alphasafal/saaya-verify/docs/report/SAAYA_Cool_Shelter_Project_Report_VIT.pdf

## SAAYA: AN IoT-ENABLED COOL SHELTER FOR OUTDOOR WORKERS

A PROJECT REPORT

Submitted to the School of Computer Science and Engineering

by

SAFAL GUPTA
23BCT0237

SCHOOL OF COMPUTER SCIENCE AND ENGINEERING VELLORE INSTITUTE OF TECHNOLOGY VELLORE – 632 014, TAMIL NADU, INDIA

OCTOBER 2026

### DECLARATION

I hereby declare that the project report entitled “SAAYA: An IoT-Enabled Cool Shelter for Outdoor Workers”, submitted by me to the School of Computer Science and Engineering, Vellore Institute of Technology, Vellore, is a record of original work carried out by me. I further declare that the work reported in this project has not been submitted, either in part or in full, for the award of any other degree or diploma in this institute or any other institute or university.

Place: Vellore
Date:

Signature of the Candidate Safal Gupta
23BCT0237

ii

### CERTIFICATE

This is to certify that the project report entitled “SAAYA: An IoT-Enabled Cool Shelter for Outdoor Workers”, submitted by Safal Gupta (23BCT0237), School of Computer Science and Engineering, Vellore Institute of Technology, Vellore, is a record of bona fide work carried out by the student during the period July 2026 to October 2026. The contents of this report have not been submitted elsewhere for the award of any degree or diploma.

Signature of the Head of Department [Head of Department]
School of Computer Science and Engineering
Internal Examiner | External Examiner

iii

### ACKNOWLEDGEMENT

I thank the Head of the Department and the faculty of the School of Computer Science and Engineering, Vellore Institute of Technology, for the facilities and the encouragement to work on a problem outside the usual software projects. I also thank the management of VIT for providing an environment in which an idea like this can be tried.

The design depends on published research and on openly available datasheets and tools. I acknowledge the authors of the heat and fan-use studies cited in this report, and the developers of CadQuery, PlatformIO, the ESP32 Arduino core and the Wokwi simulator.

Finally, I thank my family and friends for their support, and the workers whose working conditions in the Vellore summer were the reason for starting this project.

Safal Gupta

iv

### ABSTRACT

Workers on Indian construction sites and farms take their rest breaks under whatever shade is available, usually a bare metal sheet that becomes hot in the afternoon sun. Nobody measures whether these shades help, fans fitted to them fail without anyone noticing, and a worker who feels unwell has no reliable way to call for help. This project presents the SAAYA cool shelter, a demountable rest shelter for four to six workers. Its 2.4 m × 2.0 m steel frame carries a reflective upper roof skin, a ventilated gap of about 120 mm and a painted lower lining, with a 200 mm overhang, a louvred side screen and a bench. An IoT system called SAAYA Node, built around an ESP32 microcontroller, reads two Sensirion SHT30 temperature and humidity sensors (at seat height and outside the shelter as a reference), a DS18B20 probe on the roof lining, a float switch in the water can, the tachometer of a 120 mm PWM fan and an INA219 power monitor. Workers use three weatherproof buttons and an OLED display; a help request is latched in flash memory and can be cleared only by staff. Guided by medical studies showing that fans can add heat in very hot air, the controller stops automatic fan operation at 39 °C while leaving manual control to the worker. A screening heat model predicts that the cool roof keeps its lining about 26 °C cooler than a weathered metal sheet, and showed that shade, overhang and the ground around the shelter matter more than any single roof detail. The report documents the selection of materials and components, technical specifications, the interfacing circuit, dimensioned CadQuery 3D models of the shelter and the 175 × 100 × 60 mm IP65 electronics enclosure, and a deployment plan for a worksite in Vellore. The electronics cost about ₹5,314. The firmware compiles and its control logic passes automated tests; fabrication and field testing are the next stage.

Keywords: cool shelter, Internet of Things, ESP32, heat stress, outdoor workers, cool roof, PWM fan control, Vellore.

v

### TABLE OF CONTENTS

Title | Page No.
Declaration | ii
Certificate | iii
Acknowledgement | iv
Abstract | v
List of Figures | ix
List of Tables | x
List of Abbreviations | xi
1 INTRODUCTION | 1
1.1 Background | 1
1.2 Problem statement | 1
1.3 Objectives | 2
1.4 Scope and limitations | 2
1.5 Organisation of the report | 2
2 LITERATURE SURVEY | 3
2.1 Heat exposure in a shaded rest area | 3
2.2 Cool roofs in India | 3
2.3 Lessons from traditional Indian buildings | 3
2.4 When does a fan help? | 4
2.5 Measuring radiant heat cheaply | 4
2.6 Research gap | 4
3 PROPOSED COOL SHELTER AND REAL-LIFE SCENARIO | 5
3.1 The practical problem | 5
3.2 Overview of the cool shelter | 5
3.3 Intended users | 6
3.4 How the shelter keeps people cool | 6
3.5 How the smart system operates | 6
3.6 Design reasoning from a heat model | 7
3.7 Expected benefits | 8
3.8 Why the design suits this application | 8
4 COMPONENT SELECTION AND JUSTIFICATION | 9
4.1 Selection criteria | 9
4.2 Shelter structure and passive cooling elements | 9

vi

4.3 Electronic components | 10
4.4 Discussion of key choices | 11
5 TECHNICAL SPECIFICATIONS | 13
5.1 Shelter specification | 13
5.2 Electronic component specifications | 13
5.3 Power budget | 14
6 INTERFACING DESIGN | 16
6.1 Circuit overview | 16
6.2 Pin assignment | 18
6.3 Design rules taken from the datasheets | 18
7 3D MODEL DESIGN | 20
7.1 Modelling approach | 20
7.2 Shelter structure | 20
7.3 Placement of devices in the shelter | 22
7.4 Electronics enclosure | 22
8 DEPLOYMENT CAPABILITY | 26
8.1 Installation area and orientation | 26
8.2 Foundation and erection | 26
8.3 Mounting the smart system | 26
8.4 Power availability | 28
8.5 Connectivity | 28
8.6 Environmental conditions | 28
8.7 Maintenance | 28
8.8 Retrofit option | 29
9 IMPLEMENTATION AND TESTING | 30
9.1 Firmware structure | 30
9.2 Operating states | 30
9.3 Verification carried out | 31
9.4 Hardware simulation | 31
9.5 Cost summary | 33
9.6 Limitations | 33
10 CONCLUSION AND FUTURE WORK | 34
10.1 Conclusion | 34
10.2 Future work | 34
REFERENCES | 35
APPENDIX A: BILL OF MATERIALS | 37

vii

APPENDIX B: SHELTER COST ESTIMATE | 39

viii

QQLOFQQ

### LIST OF FIGURES

Fig. 3.1 The SAAYA cool shelter: steel frame, ventilated double roof, louvred side screen, bench, SAAYA Node enclosure on the rear post, seat sensor stand and water can

6

Fig. 3.2 Predicted mean radiant temperature at a seated worker’s head for different roof options (screening model, clear 38 °C noon in mid-May, Vellore)

7

Fig. 6.1 Interfacing diagram of the SAAYA Node electronics showing all pins, bus addresses, pull-up resistors, driver stages and supply rails

17

Fig. 7.1 Shelter frame with the roof skins removed, showing posts, crossbeams, knee gussets, purlins, louvred screen, bench, electronics enclosure and sensor stands

20

Fig. 7.2 General arrangement of the cool shelter: plan with post grid, roof outline and bench, and front elevation with frame, double roof and clear height

21

Fig. 7.3 Electronics enclosure with the lid removed: ESP32 board and terminals (left), INA219, buck converter and fuse (right), vent and side ACK button

23

Fig. 7.4 Enclosure front panel | 23
Fig. 7.5 Underside with five PG7 glands | 23
Fig. 7.6 Dimensioned drilling and mounting drawing of the electronics
enclosure, back bracket and internal layout | 25

Fig. 8.1 Side elevation of the shelter showing mounting heights and sensor

positions | 27

Fig. 9.1 Hardware simulator on the project website: field build, seat air 34.2 °C,

fan running at 50 percent with tachometer feedback and the INA219 reading 1.45 W | 32

ix

QQLOTQQ

### LIST OF TABLES

Table 4.1 Selection of the shelter structure and passive cooling elements | 9
Table 4.2 Selection of the electronic components | 10
Table 5.1 Specification of the cool shelter structure | 13
Table 5.2 Technical specifications of the electronic components | 13
Table 5.3 Power budget per supply rail | 15
Table 6.1 ESP32 pin assignment | 18
Table 7.1 Positions of the smart-system devices in the shelter model (datum:
front-left post centre at floor level, mm) | 22

Table 7.2 Principal dimensions of the electronics enclosure (mm, datum at front-

left-bottom corner) | 23
Table 8.1 Maintenance schedule | 28
Table 9.1 Response of the system to each operating state | 30
Table 9.2 Behaviour checked automatically in the hardware simulator | 32
Table A.1 Bill of materials and cost | 37
Table B.1 First-article cost estimate of the cool shelter (₹) | 39

x

QQLOAQQ

### LIST OF ABBREVIATIONS

ABS | Acrylonitrile butadiene styrene
ACK | Acknowledge
API | Application programming interface
CAD | Computer-aided design
CFM | Cubic feet per minute
GPIO | General-purpose input/output
I²C | Inter-Integrated Circuit bus
IMD | India Meteorological Department
IoT | Internet of Things
IP65 | Ingress protection: dust-tight, protected against water jets
LDO | Low-dropout regulator
MRT | Mean radiant temperature
RHS / SHS | Rectangular / square hollow section (steel tube)
NDMA | National Disaster Management Authority
OLED | Organic light-emitting diode
PWM | Pulse-width modulation
RH | Relative humidity
STEP | Standard for the Exchange of Product model data
STP | Shielded twisted pair
WHO | World Health Organization

xi

QQC1QQ

### CHAPTER 1

### INTRODUCTION

QQS1_1QQ1.1 Background

Outdoor work in India does not stop for the summer. Masons, road crews, farm labourers and delivery riders keep working through April and May, when the afternoon air in Vellore regularly sits close to 39 °C and has touched 45 °C [1]. The International Labour Organization estimates that heat stress could cost India about 5.8 percent of its working hours by 2030, roughly 34 million full-time jobs [2]. The 2025 Lancet Countdown put the potential labour lost to heat in India in 2024 at 247 billion hours [3].

For most of these workers the only relief during a break is whatever shade happens to be on site: a sheet of galvanised iron on four poles, a cement-sheet lean-to, or the shadow of a parked truck. In 2025 the National Disaster Management Authority published draft guidelines asking for proper shaded rest structures for outdoor workers, with reflective roofs instead of bare metal sheets, cross-ventilation and shaded, unpaved ground around them [4]. This project takes those guidelines as a starting point and asks what a cool shelter for a worksite should look like, and how it can show that it is actually working.

QQS1_2QQ1.2 Problem statement

Three problems were identified with the rest shades found on typical worksites. The roof itself is often the worst part: a bare or weathered metal sheet absorbs sunlight and its underside becomes a radiant heater above the people sitting below it. There is no feedback of any kind, so if a fan has been fitted, nobody notices when it stalls or loses its supply. And a worker who starts to feel unwell has no dependable way to call for help other than shouting or walking to find a supervisor.

The problem addressed here is to design a low-cost cool shelter for outdoor workers that reduces radiant heat by passive means, moves air only when that is useful, measures the conditions it actually produces, refuses to report a benefit it cannot demonstrate, and gives workers a help request that cannot be lost.

QQS1_3QQ1.3 Objectives

1. To design a demountable cool shelter of about 2.4 m × 2.0 m for four to six seated workers, with a reflective ventilated double roof, a deep overhang, a side screen and a bench.
2. To select sensors, a controller and an actuator that measure seat-level air, an outdoor reference, roof temperature, water availability, fan speed and fan energy, at around ₹5,000 for the electronics.
3. To design the interfacing circuit for an ESP32 microcontroller, with every pin, bus address and supply rail documented.
4. To develop dimensioned 3D models of the shelter and of the weatherproof electronics enclosure, with sensor positions, from parts and sections available in India.
5. To write firmware that keeps working without a network, detects sensor and fan faults, latches help requests and avoids running the fan in conditions where it may add heat.
6. To plan the installation, power, connectivity and maintenance of the shelter on a worksite in Vellore.

QQS1_4QQ1.4 Scope and limitations

The report covers the design of the shelter structure, its passive cooling features, the electronic system (called SAAYA Node), the firmware, the 3D models and the deployment plan. The firmware compiles and its control logic has been tested in software, and both 3D models have been checked for clashes between parts. The shelter has not been fabricated and nothing has been measured outdoors, so no measured cooling benefit or health effect is claimed. The structural sections are candidates that still need approval by a qualified structural engineer, and the shelter cost is a planning estimate, not a quotation.

QQS1_5QQ1.5 Organisation of the report

Chapter 2 reviews the literature behind the design. Chapter 3 describes the proposed cool shelter, the real-life scenario and how it operates. Chapters 4 and 5 justify the choice of materials and components and list their specifications. Chapter 6 presents the interfacing diagram. Chapter 7 describes the 3D models of the shelter and the electronics enclosure. Chapter 8 explains deployment, Chapter 9 the implementation and testing, and Chapter 10 concludes the report.

QQC2QQ

### CHAPTER 2

### LITERATURE SURVEY

QQS2_1QQ2.1 Heat exposure in a shaded rest area

The heat a resting person feels outdoors depends on air temperature, humidity and air speed, and also on radiation from the sun, the sky, the ground and any roof overhead. This radiant part is usually expressed as the mean radiant temperature (MRT). Measurements during a record heatwave in Tempe, Arizona, found that tree shade lowered afternoon MRT by up to 33 °C while air temperature across the same sites varied by less than 4.5 °C [5]. For a shelter the message is clear: blocking radiation matters far more than trying to cool the air, which an open structure cannot hold anyway.

QQS2_2QQ2.2 Cool roofs in India

Indian pilots show that roof treatment makes a measurable difference. In an Ahmedabad trial by the Mahila Housing Trust, a white solar-reflective coating on a tin roof lowered the daytime indoor temperature by about 1 °C, and modular roofs and false ceilings did somewhat better [6]. These were closed rooms rather than open shelters, but they confirm that the finish and the underside temperature of a roof are worth designing for and worth measuring.

QQS2_3QQ2.3 Lessons from traditional Indian buildings

Traditional buildings in hot parts of India handle heat with a few simple ideas: deep verandahs and chajjas that keep the sun off walls and people, jaali screens that cut low-angle sun while letting air through, and roofs with an air space that carries heat away before it reaches the room. The shelter borrows these ideas in a light, demountable form: a 200 mm roof overhang on every side, a removable louvred screen on the sun-facing side and a two-layer roof with a ventilated gap. Heavy thermal mass and evaporative cooling were deliberately left out, because a warm night stops thermal mass from recovering and evaporative systems need water and cleaning and lose their effect in humid monsoon weather.

QQS2_4QQ2.4 When does a fan help?

A fan cools by speeding up the evaporation of sweat, but when the air is hotter than the skin it also blows heat onto the body. Ravanelli et al. found that at 42 °C a fan still helped young men, but only up to a limited humidity [7]. Gagnon et al. repeated a similar test with adults around 68 years old and found no benefit, with heart rate and core temperature slightly higher with the fan on [8]. A clinical trial by Morris et al. found fans helping in hot, humid conditions and making things worse in very hot, dry conditions [9]. A later model by the same group proposed upper air-temperature limits for fan use of 39 °C for young healthy adults, 38 °C for people over 65 and 37 °C for older people on anticholinergic medication, and advised against relying on fans alone in northern India [10]. The WHO recommends using fans only below 40 °C [11].

This research is the reason the shelter’s controller does not behave like a thermostat. Above about 39 °C it stops running the fan automatically and tells the worker why, while leaving manual control in their hands.

QQS2_5QQ2.5 Measuring radiant heat cheaply

MRT is normally estimated from a black globe thermometer together with air temperature and air speed. Teitelbaum et al. showed that the standard correction becomes inaccurate below about 1 m/s [12], which is typical under a shelter. The design therefore measures what can be measured reliably and cheaply (air temperature and humidity at the seat and outside, and the temperature of the roof underside) and keeps globe measurements as a separate validation step.

QQS2_6QQ2.6 Research gap

Shade structures and cool roofs are well understood, and fans are known to help only within limits. What is missing at worksite level is a cheap shelter that combines passive cooling with measurement, controls its fan within safe limits and is honest about what it does not know. The SAAYA cool shelter is an attempt to fill that gap.

QQC3QQ

### CHAPTER 3

### PROPOSED COOL SHELTER AND REAL-LIFE SCENARIO

QQS3_1QQ3.1 The practical problem

Consider a building site on the outskirts of Vellore in May. Around fifteen workers take their afternoon break under a galvanised sheet on four poles. The sheet is old and grey, and by 1 p.m. its underside is hotter than the air. A pedestal fan was once tied to a pole but stopped working weeks ago and nobody noticed. When one of the workers feels dizzy, the others have to find the supervisor on foot.

QQS3_2QQ3.2 Overview of the cool shelter

The SAAYA cool shelter is a four-post steel frame with post centres of 2400 × 2000 mm and a roof that projects 2800 × 2400 mm, giving a 200 mm overhang on every side. The roof is made of two skins: a white, reflective upper sheet that sends most of the sunlight back to the sky, and a lower lining about 120 mm below it. The gap between them is open at the edges so that wind and rising warm air carry away the heat absorbed by the upper sheet before it reaches the lining. The roof falls 120 mm towards the front for drainage. A 1400 × 450 mm bench sits at the rear, a removable louvred screen shades the sun-facing side, and the front stays open for access. Clear height under the front of the roof is 2310 mm (Fig. 3.1).

The smart part of the shelter, called SAAYA Node, is a weatherproof electronics box fixed to a rear post. It reads the conditions under and outside the shelter, drives a small fan, shows the status on a display and handles help requests.

QQF3.1QQ

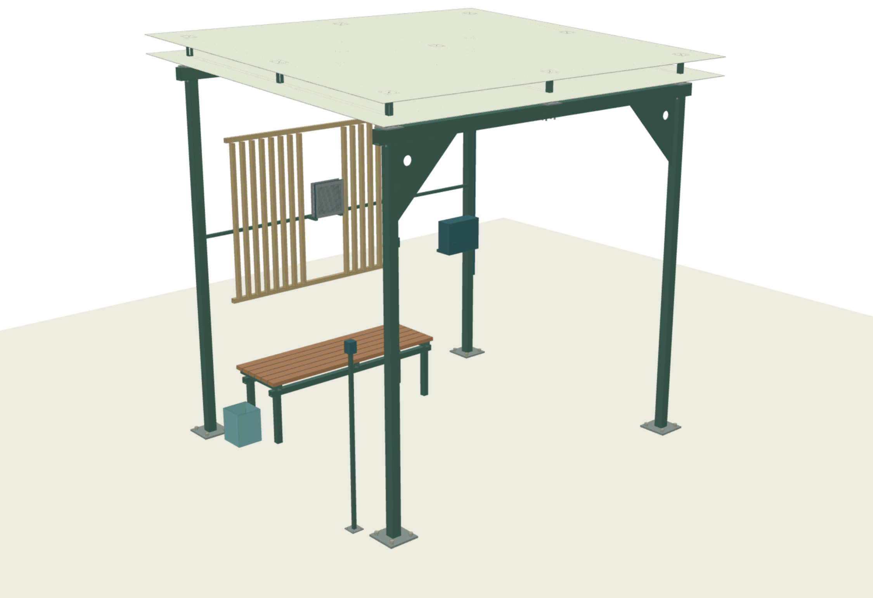
[picture p1: figure]

Fig. 3.1: The SAAYA cool shelter: steel frame, ventilated double roof, louvred side screen, bench, SAAYA Node enclosure on the rear post, seat sensor stand and water can

QQS3_3QQ3.3 Intended users

Workers use the shelter during breaks: they read the display, press MODE to switch the fan and press HELP if someone needs assistance. The site supervisor or safety officer receives help requests and acknowledges them with a separate button. The site engineer looks at the logged data to decide whether, for example, repainting the roof or planting the surrounding ground has made a difference.

QQS3_4QQ3.4 How the shelter keeps people cool

Most of the cooling is passive. The roof blocks direct sun from the seated area; the reflective upper skin keeps the roof itself from becoming a heater; the ventilated gap and the lining keep the surface that people see close to air temperature; the overhang widens the shadow; and the louvred screen cuts low-angle sun from the side while letting air through. The fan is a small addition that increases air movement over seated workers when the air is warm but not yet hot enough for a fan to become counter-productive.

QQS3_5QQ3.5 How the smart system operates

Once a second, the ESP32 inside SAAYA Node reads the air temperature and humidity at seat height, a matching reference sensor placed outside the shelter, the temperature of the roof underside, a float switch in the drinking-water can, the actual speed of the fan from its tachometer signal and the electrical power drawn by the fan.

When a worker presses MODE, the fan runs at 70 percent. In automatic mode it starts at 32 °C and stops below 31 °C, so it does not switch on and off around a single threshold. If the seat-level air reaches 39 °C, automatic operation stops and the display reads “HOT: FAN MAY ADD HEAT”, although the worker can still switch the fan on manually. If the fan is commanded but its tachometer shows no rotation after three seconds, the display shows a fan fault and no cooling is reported for that period.

Pressing HELP latches a request: the red LED lights, the buzzer sounds and the display shows the request. The latch is kept in flash memory, so it survives a power cut or a reset, and it can only be cleared with the ACK button, which sits on the side of the box so that it is pressed deliberately by staff. Readings go to a laptop over USB, or optionally over the site Wi-Fi to the supervisor.

QQS3_6QQ3.6 Design reasoning from a heat model

Before fixing the roof design, a small steady-state model was written to see which features actually reduce the heat felt by a seated worker [13, 14]. It balances sunlight, sky and ground radiation and wind on each roof skin and computes the MRT at the head of a seated worker from the exact solid angle of the roof, sky and ground. For a clear 38 °C noon in mid-May in Vellore it predicts that moving from open sun into the shade of a weathered metal shed lowers MRT by about 16 °C, and that the SAAYA cool roof lowers it by a further 2.6 °C (Fig. 3.2). The bigger difference is in the roof underside, which the model expects to run about 26 °C cooler than the weathered sheet, so the surface just above people’s heads stays close to air temperature.

QQF3.2QQ

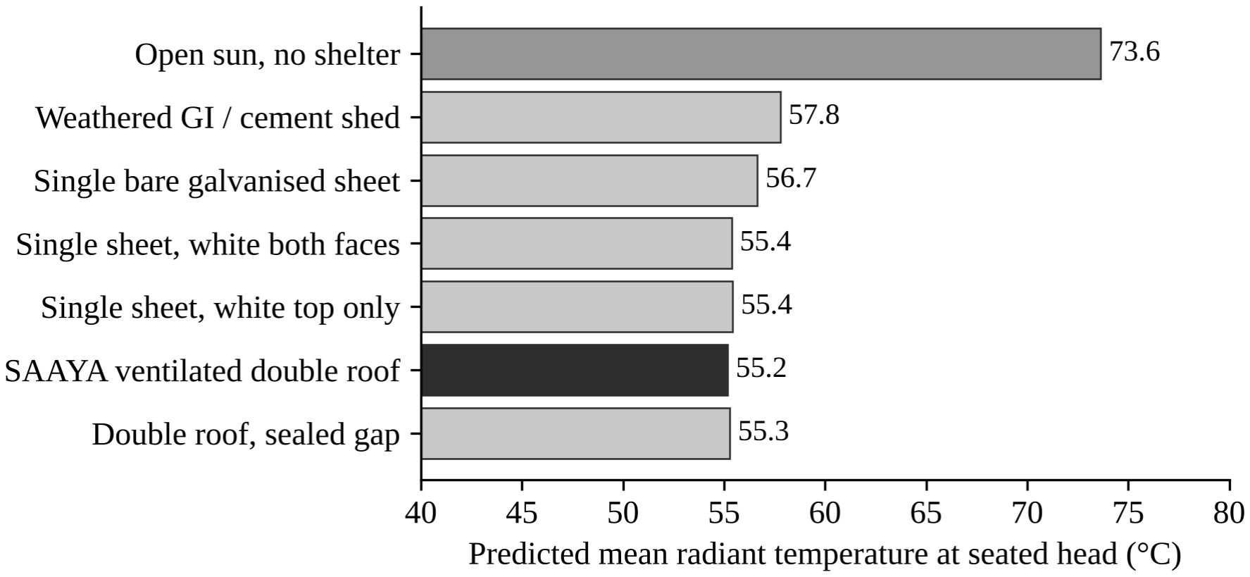
[picture p2: figure]

Fig. 3.2: Predicted mean radiant temperature at a seated worker’s head for different roof options (screening model, clear 38 °C noon in mid-May, Vellore)

The model also showed what else is worth spending on. Adding 0.3 m of overhang on every side lowers the seated MRT by about 1.4 °C, and replacing dry bare ground around the shelter with irrigated ground cover lowers it by about 4 °C, because a seated person sees far more ground and sky than roof. Light-coloured paving does the opposite: it reflects sunlight back up and raises MRT by about 5 °C. The upper skin of the double roof cuts the lining temperature by 8 to 22 °C, and its value grows as the white top coat gets dirty. These results set the priorities in the design: shade and overhang first, then the cool roof, then the ground around the shelter.

QQS3_7QQ3.7 Expected benefits

A rest place where direct sun and the hot-roof effect are removed, with the roof underside kept near air temperature.
A help request that cannot be lost or silently cleared, and that still works when the network or the laptop is down.
Immediate notice of a stalled fan, a disconnected sensor or an empty water can. Paired readings from the seat and from outside the shelter, so the site can see whether the shelter, or a later improvement, actually helped.
Very low energy use: about 34 Wh a day for the electronics and fan, compared with 11 to 13 kWh in one shift for a 1.5-ton air conditioner.

QQS3_8QQ3.8 Why the design suits this application

An open shelter cannot keep air-conditioned air in, so cooling the air is not a realistic goal. What can be done is to block radiation, move air sensibly and keep watch. The frame is bolted from repeated steel sections so it can be moved when the site moves; the electronics run entirely on the microcontroller so they do not depend on the internet; and the same electronics can be fitted to an existing shed when a new shelter is not affordable.

QQC4QQ

### CHAPTER 4

### COMPONENT SELECTION AND JUSTIFICATION

QQS4_1QQ4.1 Selection criteria

Every material and component was judged against the same criteria: whether it contributes to cooling or to measurement rather than only appearance; cost; accuracy adequate for a 1 °C decision margin; power consumption; an operating range covering shaded outdoor air between 25 °C and 45 °C and monsoon rain; compatibility with the rest of the system (3.3 V logic and the I²C bus for the electronics, bolted connections for the structure); and availability from Indian suppliers.

QQS4_2QQ4.2 Shelter structure and passive cooling elements

QQT4.1QQ
Table 4.1: Selection of the shelter structure and passive cooling elements
Element | Selected | Reasons for selection | Alternatives considered
Frame | Steel SHS 60×60×3 posts, RHS 80×60×3 beams, RHS 60×40×3 purlins | Standard sections stocked across India; bolted plate connections make the shelter demountable; galvanised or painted for corrosion | Bamboo (variable strength, termites, hard to bolt), timber (rot, fire), aluminium extrusions (higher cost, harder to weld locally)
Upper roof skin | White coated steel sheet | Reflects most sunlight; cheap and replaceable; the white top coat can be repainted when dirty | Bare galvanised sheet (hot underside), cement sheet (heavy, brittle), polycarbonate (lets light and heat through)
Roof gap | About 120 mm, open at the edges | Wind and rising air carry heat away before it reaches the lining; the gap is set by 30×30 spacers that also carry the upper skin | Sealed gap (traps heat), insulated sandwich panel (cost, holds heat into the evening)
Lower lining | Painted aluminium sheet | Stays near air temperature behind the ventilated gap; paint resists corrosion and the model shows the finish matters little once the lining is cool | No lining (the hot upper skin faces people), false ceiling boards (moisture, fixings)
Overhang | 200 mm on every side | Widens the shadow at the bench without enlarging the post grid | Larger overhang (more wind uplift and cost; considered as an upgrade)
Side screen | Removable timber louvres 20×40, on two rails | Cuts low-angle sun from the side while letting air through, like a jaali | Solid wall (blocks breeze), fabric (wears out quickly in UV)

Element | Selected | Reasons for selection | Alternatives considered
Bench | 1400×450, seat height 450, timber or recycled-plastic slats | Comfortable seated height; slats drain rain and do not get as hot as metal | Steel bench (too hot to touch), concrete (fixed, heavy)
Foundation | 200×200×10 base plates with 4 anchors each | Bolts to a slab or footing and can be lifted and moved | Embedded posts (permanent; cannot be relocated)

QQS4_3QQ4.3 Electronic components

QQT4.2QQ
Table 4.2: Selection of the electronic components
Function | Selected part | Reasons for selection | Alternatives considered
Microcontro ller | ESP32-DevKitC (WROOM-32) | ₹499; 2 × I²C, 16 LEDC PWM channels (25 kHz fan PWM), interrupt tach input, Wi-Fi built in, flash for the help latch, hardware watchdog, −40… 85 °C | Arduino Uno (no Wi-Fi, 2 kB RAM), Raspberry Pi (SD-card corruption on power loss, ~10× power, no hard real-time), ESP8266 (one ADC, fewer GPIO, no 2nd core for the Wi-Fi task)
Air temperature / RH (×2) | Sensirion SHT30 on GY-SHT30-D | Same typical accuracy as SHT31 (±0.2 °C over 0–65 °C, ±2 %RH) at less than half the price (₹179 vs ₹399); digital I²C; 0x44/0x45 lets two share one bus; 0.6 mA while measuring | DHT22 (slower, timing-critical 1-wire, poorer RH stability), BME280 (self-heating, pressure not needed), SHT31 (no accuracy gain in our 25–45 °C range)
Roof underside temperature | DS18B20 waterproof probe | ₹49; ±0.5 °C (−10…85 °C); stainless, sealed; 1-Wire runs on long cable; one GPIO | IR thermometer (needs emissivity correction on a metal roof), NTC thermistor (needs ADC calibration, lead resistance)
Energy measuremen t | INA219 breakout | ₹89; high-side current + bus voltage 0–26 V on I²C; 0.5 % class; measures the fan branch so energy is measured, not estimated | ACS712-5A Hall sensor (185 mV/A: only ≈ 60 mV signal at the 0.33 A fan load, noisy), datasheet power figures (not a measurement)
Actuator | Arctic P12 Pro, 120 mm, 12 V, 4-wire | Tach feedback (2 pulses/rev) proves the fan turns; 25 kHz PWM speed control; 0 rpm below 5 % PWM gives a true off; 77 CFM at 0.33 A (~4 W) | 2-wire fans (no feedback: a stalled fan looks like a running one), 230 V pedestal fan (shock risk in a wet outdoor space, no feedback, 55–125 W)
Display | SSD1306 0.96" I²C OLED | ₹130; readable status without a phone; shares the I²C bus; ~20 mA | LCD 16×2 (needs 5 V and 6 GPIO or an extra I²C backpack), phone app only (workers may not carry phones)
Controls | 3 × 12 mm IP65 metal momentary buttons | Weatherproof, gloved-hand usable; HELP on the front, ACK on the side so only staff clear a request | Membrane keypad (UV/ heat ageing), touch sensor (false triggers with sweat/rain)

Function | Selected part | Reasons for selection | Alternatives considered
Alert | SFM-27 active buzzer + 5 mm LED | >95 dB, <12 mA from 12 V via 2N3904; visible + audible help/fault state | Passive piezo (needs tone generation, quieter)
Water status | PP reed float switch | Dry contact, no power, cheap; open circuit (incl. broken wire) reads “low / check” | Ultrasonic level sensor (cost, condensation errors), capacitive probe (fouling)
Power | 12 V 2 A SMPS + MP1584 buck to 5 V + 1 A fuse | 12 V feeds the fan directly; buck gives 5 V for the board at high efficiency; fuse protects the field wiring; ~3.6× current margin | Linear 7805 (≈60 % loss at 12→5 V), USB power bank (not for continuous outdoor use)
Enclosure | ProtechT WPE16 IP65 ABS, 175×100×60 | Purchasable, IP65, room for the 90×70 board + modules; cable glands down + breathable vent manage monsoon rain and condensation | 3D-printed PETG box (UV and heat creep near 60–70 °C roof air, not IP-rated)

QQS4_4QQ4.4 Discussion of key choices

Why a ventilated double roof instead of a single cool sheet
A single sheet painted white on top already removes much of the solar heat, but its underside still runs well above air temperature on a clear day, and the difference grows as the coating gets dirty. A second skin with a ventilated gap keeps the lining close to air temperature even when the top coat has aged, protects the white coating from being scratched from below, and gives a cool surface just above the heads of standing workers. The upper skin is bolted on spacers so it can be removed, which also allows a site to compare the single and double roof directly with the shelter’s own sensors.

Microcontroller
The ESP32 combines two I²C controllers, sixteen PWM channels, interrupt-capable inputs for the fan tachometer, Wi-Fi, flash storage and a hardware watchdog on a ₹499 board [15]. An Arduino Uno would need extra hardware for networking and has very little memory for the telemetry records. A Raspberry Pi was rejected because it boots an operating system from an SD card that can be corrupted by the frequent power cuts on worksites.

Temperature and humidity sensors
The SHT31 was the first choice, but the cheaper SHT30 has the same typical accuracy of ±0.2 °C between 0 °C and 65 °C and ±2 percent relative humidity [16], which covers the range under a shelter. Two SHT30 modules save about ₹440, and they share one bus because one is set to address 0x44 and the other to 0x45.

Fan
A four-wire PWM fan was essential because its tachometer output proves that the fan is actually turning. The four-wire specification also requires such fans to run at full speed when the PWM line is not driven [17, 18], so if the controller fails the fan fails on rather than off. The Arctic P12 Pro delivers 77 CFM at 0.33 A and stops completely below 5 percent PWM, which gives a genuine off state. A 230 V pedestal fan was rejected because it brings mains voltage into a wet outdoor space and gives no feedback.

Power
A 12 V, 2 A adapter feeds the fan directly, and an MP1584 buck module produces 5 V for the board. A linear regulator would waste more than half of the power as heat inside a closed box. The MP1584 chip is marked as not recommended for new designs by its maker [19], which is acceptable for a prototype; the MP2338 is noted as its replacement for production.

QQC5QQ

### CHAPTER 5

### TECHNICAL SPECIFICATIONS

QQS5_1QQ5.1 Shelter specification

QQT5.1QQ
Table 5.1: Specification of the cool shelter structure
Item | Specification
Plan size | Post centres 2400 × 2000 mm; roof projection 2800 × 2400 mm (200 mm overhang each side)
Height | Front clear height 2310 mm; roof falls 120 mm over 2000 mm (3.4°) towards the front gutter
Capacity | 4 to 6 seated workers on a 1400 mm bench, plus standing space and an open access bay
Posts | SHS 60 × 60 × 3 mm; front 2300 mm, rear 2420 mm long; 200 × 200 × 10 mm base plates, 4 anchors each
Beams and purlins | Two RHS 80 × 60 × 3 mm crossbeams, 2580 mm; three RHS 60 × 40 × 3 mm purlins at 2000 mm span; two 6 mm knee gussets
Roof | White coated steel upper skin; painted aluminium lower lining; nine SHS 30 × 30 × 2 spacers, about 118 mm, with bolted caps
Side screen | 14 timber louvres 20 × 40 × 1070 mm on two RHS 30 × 30 × 2 mm rails, 1400 mm long, removable
Bench | 1400 × 450 mm, seat height 450 mm, six 70 × 25 mm slats on SHS 40 × 40 × 2 mm legs and rails
Connections | M10 bolts at roof connection plates, M6 at spacer caps; weld and bolt schedule subject to structural approval
Modelled mass | About 250 kg using idealised material densities

QQS5_2QQ5.2 Electronic component specifications

QQT5.2QQ
Table 5.2: Technical specifications of the electronic components
Component | Supply and current | Range and accuracy | Interface | Dimensions | Sourc e
ESP32-WROOM-32E (DevKitC) | 3.0–3.6 V module; 5 V via board LDO 20–68 mA modem-sleep; Wi-Fi TX 239 mA avg / 379 mA peak; 10 µA deep sleep | −40…85 °C — | 2 × I²C, LEDC PWM, GPIO, Wi-Fi 802.11 b/g/n | board 54.4 × 27.9; module 18 × 25.5 × 3.1 | [20]

Component | Supply and current | Range and accuracy | Interface | Dimensions | Sourc e
SHT30 (×2) | 2.15–5.5 V (3.3 V used) 0.6 mA measuring; 0.2 µA idle | 0–100 %RH; −40…125 °C ±0.2 °C (0–65 °C), ±2 %RH typ; τ63 RH 8 s | I²C 0x44 / 0x45 | small breakout; measure before fixing | [16]
DS18B20 probe | 3.0–5.5 V 1 mA active; 0.75 µA standby | −55…125 °C ±0.5 °C (−10…85 °C); 12-bit, 750 ms | 1-Wire, 4.7 kΩ pull-up | Ø6 × 50 mm probe, 1 m lead | [21]
INA219 | 3–5.5 V logic; bus 0– 26 V 0.7 mA | ±3.2 A with 0.1 Ω shunt 0.5 % max (B grade); 0.8 mA LSB | I²C 0x40 | ≈ 25 × 22 mm | [22]
SSD1306 OLED | 3.3–5 V module ≈ 20 mA fully lit, < 5 mA text | −40…85 °C 128 × 64 px, active 21.7 × 10.9 mm | I²C 0x3C | 27.5 × 27.5 × 11 mm | [23]
Arctic P12 Pro fan | 12 V 0.33 A (~4 W) | 600–3000 rpm; 0 rpm < 5 % PWM 77 CFM / 131 m³/h; 6.9 mmH₂O | 4-wire: PWM 25 kHz, tach 2 p/rev | 120 × 120 × 25 mm | suppli er
2N3904 (Q1, Q2) | VCEO 40 V IC 200 mA max | — hFE 100–300 @ 10 mA; VCE(sat) 0.2 V | 4.7 kΩ base, 10 kΩ B-E | TO-92 | [24]
MP1584EN buck | 4.5–28 V in 3 A out | 0.8–20 V out (set 5.0 V) IC marked NRND → MP2338 for production | — | 22 × 17 × 4 mm | [19]
SFM-27 buzzer | 3–24 V (12 V used) < 12 mA | — > 95 dB | via Q2 on IO14 | measure before drilling | suppli er
12 mm IP65 button (×3) | — 3 A / 250 V AC contact | — IP65 | to GND, internal pull-up | 12 mm panel hole | suppli er
PP float switch | — 0.5 A switching | −10…60 °C NO reed | IO35 + 10 kΩ pull-up | measure before fitting | suppli er
Enclosure WPE16 | — — | outdoor, shaded mount IP65 | 5 × PG7 + M12 vent | 175 × 100 × 60 mm | suppli er

QQS5_3QQ5.3 Power budget

Table 5.3 adds up the expected current on each supply rail. With the fan at 70 percent and Wi-Fi off, the system draws about 271 mA from the 12 V adapter, about 3.2 W. In the worst case, with the fan at full speed, the Wi-Fi radio transmitting and the buzzer on, it draws about 578 mA or 6.9 W, assuming an 85 percent efficient buck converter. The 2 A adapter has a margin of more than three times, and a 1 A slow-blow fuse protects the field wiring.

QQT5.3QQ
Table 5.3: Power budget per supply rail
Load | Rail | Typical (mA) | Peak (mA) | Note
ESP32-DevKitC (Wi-Fi off) | 5 V | 70 | 70 | modem-sleep 20–68 mA + LDO
ESP32 Wi-Fi uplink (optional) | 5 V | 0 | 380 | TX peak 379 mA
OLED | 3.3 V | 10 | 20
SHT30 ×2 + DS18B20 + INA219 | 3.3 V | 3 | 4
LED | 3.3 V | 0 | 8 | only on help/fault
Fan, Arctic P12 Pro | 12 V | 230 | 330 | 70 % / 100 % PWM
Buzzer | 12 V | 0 | 12 | only on help

Running the fan for eight hours and the controller for twenty-four hours uses about 34 Wh a day. A 20 W solar panel on the roof with a 12 V, 7 Ah battery could therefore power the shelter on sites without mains, although that option has not been costed here.

QQC6QQ

### CHAPTER 6

### INTERFACING DESIGN

QQS6_1QQ6.1 Circuit overview

Fig. 6.1 shows every connection between the ESP32-DevKitC, the sensors, the fan, the user controls and the power supply. All signals use 3.3 V logic. The four I²C devices share one bus on GPIO21 and GPIO22, run at 50 kHz rather than the usual 100 kHz to give extra margin on the several metres of cable to the reference sensor outside the shelter. The fan is controlled through a 2N3904 transistor so that the ESP32 never connects directly to the fan’s own circuitry, and a second transistor drives the 12 V buzzer.

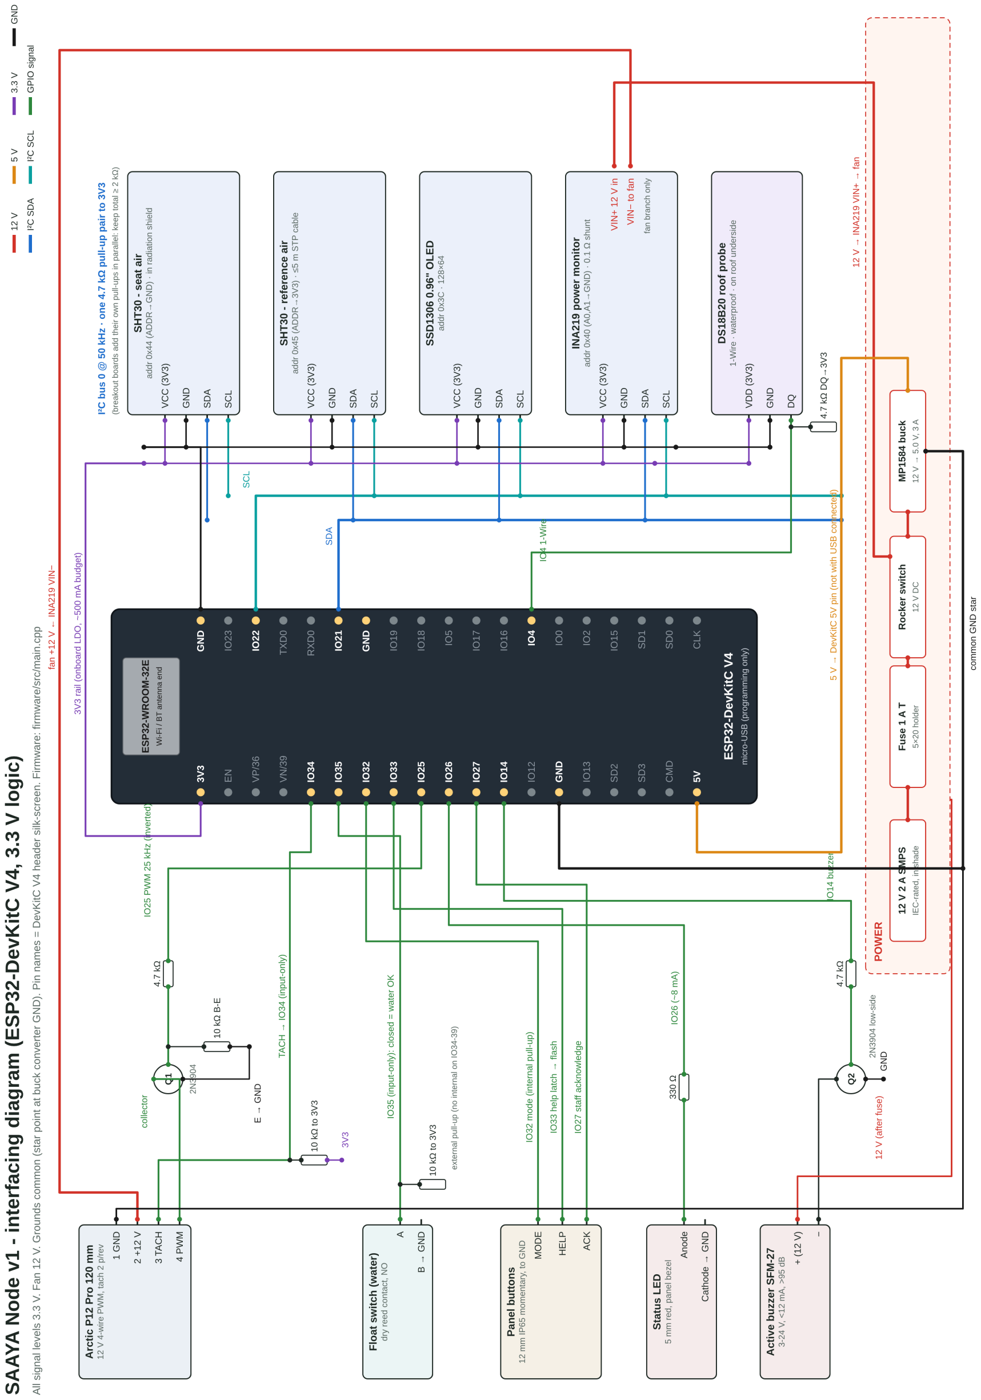
[picture p3: figure]

QQF6.1QQ

Fig. 6.1: Interfacing diagram of the SAAYA Node electronics showing all pins, bus addresses, pull-up resistors, driver stages and supply rails

QQS6_2QQ6.2 Pin assignment

QQT6.1QQ
Table 6.1: ESP32 pin assignment
ESP32 pin | Function | Directio n | Conditioning | Connected to
IO21 / IO22 | I²C SDA / SCL @ 50 kHz | bidir | 4.7 kΩ to 3V3 | SHT30 seat 0x44, SHT30 reference 0x45, OLED 0x3C, INA219 0x40
IO25 | Fan PWM 25 kHz (LEDC ch 0) | out | 4.7 kΩ → Q1 2N3904, 10 kΩ B-E; output inverted in firmware | Fan pin 4 (PWM). ESP32 reset → line floats → fan full speed
IO34 | Fan tach | in only | 10 kΩ to 3V3 (no internal pull-up) | Fan pin 3, 2 pulses/rev
IO4 | DS18B20 1-Wire | bidir | 4.7 kΩ to 3V3 | Roof underside probe
IO35 | Float switch | in only | 10 kΩ to 3V3; closed = water OK | Float in water can
IO32 | MODE button | in | INPUT_PULLUP, 35 ms debounce | Front panel
IO33 | HELP button | in | INPUT_PULLUP; latch stored in flash | Front panel (red)
IO27 | ACK button | in | INPUT_PULLUP | Right side wall (staff)
IO26 | Status LED | out | 330 Ω (≈ 8 mA) | Front panel
IO14 | Buzzer | out | 4.7 kΩ → Q2 2N3904 low side | SFM-27 on 12 V
5V / GND | Board supply | power | MP1584 5.0 V; never with USB connected | Common GND star at buck
3V3 | Sensor/logic supply | power | DevKitC LDO | All I²C modules, DS18B20, pull-ups

The strapping pins GPIO0, GPIO2, GPIO12 and GPIO15 were avoided because their state at power-up decides how the chip boots, and GPIO6 to GPIO11 are connected to the on-board flash memory.

QQS6_3QQ6.3 Design rules taken from the datasheets

GPIO34 to GPIO39 are input-only and have no internal pull-up resistors [15], so the fan tachometer and the float switch use GPIO34 and GPIO35 with external 10 kΩ pull-ups to 3.3 V.
The fan PWM signal is generated at 25 kHz, the frequency required by the four-wire fan specification, and the tachometer gives two pulses per revolution [17].

The DevKitC must be powered from either USB or its 5 V pin, never both at once [15]. In the shelter it runs from the buck converter, and USB is used only for programming.
The INA219 can sense up to 26 V [22]; it sits on the high side of the 12 V fan supply and measures the fan’s energy only.
The DS18B20 needs a 4.7 kΩ pull-up on its data line [21], and its 750 ms conversion is started in the background so it never delays the control loop.

QQC7QQ

### CHAPTER 7

### 3D MODEL DESIGN

QQS7_1QQ7.1 Modelling approach

Both models were built in CadQuery, a Python library for parametric CAD, so every dimension lives in code and the drawings, renders and this report all read the same numbers. The shelter model contains 44 part definitions and 143 placed instances; the electronics enclosure model contains 23 solids. Both are exported as STEP files for use in any CAD package and as STL meshes for the web viewer, and an automatic check confirms that no two solids overlap by more than 1 mm³ in either model.

QQS7_2QQ7.2 Shelter structure

The frame is made of welded side frames and a bolted roof module so that it can be transported in pieces and assembled with hand tools. Fig. 7.1 shows the frame with the roof removed: the two crossbeams sit on the posts with knee gussets at the front, and three purlins carry the roof skins. Fig. 7.2 is the general arrangement drawing with the post grid, roof outline, bench and clear height.

QQF7.1QQ

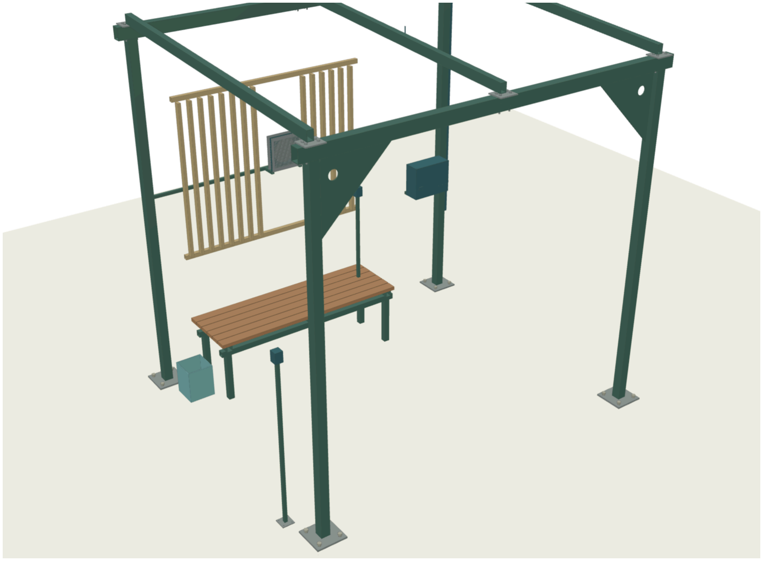
[picture p4: figure]

Fig. 7.1: Shelter frame with the roof skins removed, showing posts, crossbeams, knee gussets, purlins, louvred screen, bench, electronics enclosure and sensor stands

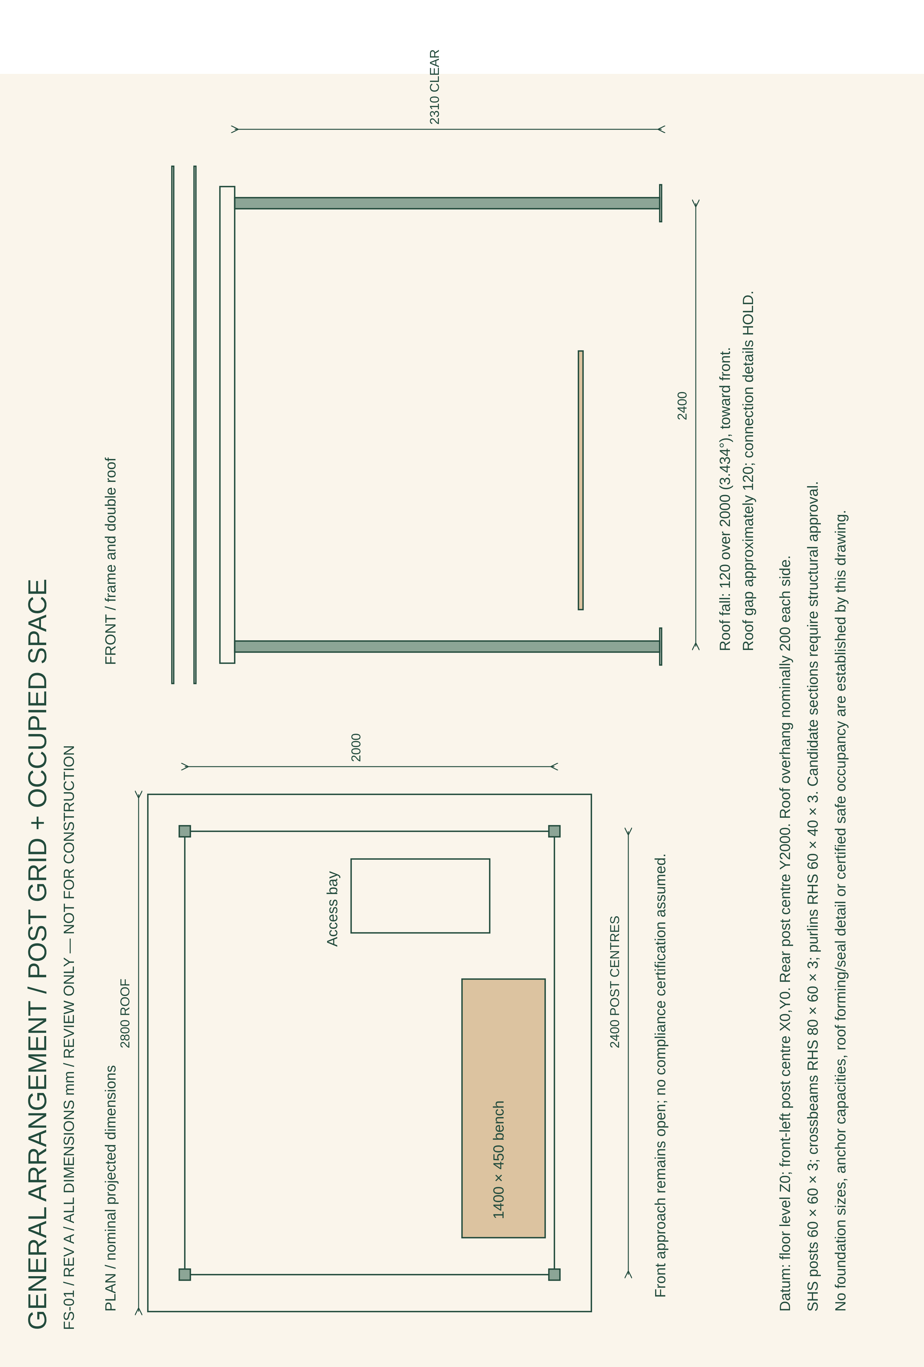
[picture p5: figure]

QQF7.2QQ

Fig. 7.2: General arrangement of the cool shelter: plan with post grid, roof outline and bench, and front elevation with frame, double roof and clear height

QQS7_3QQ7.3 Placement of devices in the shelter

QQT7.1QQ
Table 7.1: Positions of the smart-system devices in the shelter model (datum: front-left post centre at floor level, mm)
Device | Position (x, y, z) | Reason
SAAYA Node enclosure | rear right post, z ≈ 950–1200 | Shaded, within reach of a seated or standing person, close to the cable route
Fan | (850, 1880, 1400) on a rear service rail | Above and behind the bench, aimed down at seated workers
Seat T/RH sensor | (1450, 1750, 1100) on a stem by the bench | Seated head height, in the occupied zone, in a radiation shield
Roof probe | (1300, 1000, under the lining) | Centre of the roof underside, the surface people see
Reference T/RH sensor | own stand; moved ≥ 2 m outside the roof edge in use | Measures outdoor air at the same height for a fair comparison
Water can and float | (0, 1640, 0), rear left | Away from the electronics; easy to refill

QQS7_4QQ7.4 Electronics enclosure

The electronics live in a purchased IP65 ABS box of 175 × 100 × 60 mm, which the model treats as a box to be drilled rather than a part to be printed. A 3D-printed housing was rejected because PETG can soften in the 60 to 70 °C air just below a sunlit roof and is not rated for rain. Inside, a 90 × 70 mm perforated board carries the ESP32, the two driver transistors, the pull-up resistors and pluggable terminal blocks for the field wiring, with the INA219, buck converter and fuse holder beside it on a metal plate (Fig. 7.3).

The display window is at the top left, where people look first. The HELP button, the status LED and the MODE button form one column on the right, with the LED directly above HELP so the state of a request is shown next to the button that made it. All five cable glands face the ground so that rain runs off rather than in, and a breathable vent on the left wall stops condensation being drawn in as the box cools every night (Figs. 7.4 and 7.5). An aluminium back bracket clamps to the shelter post with two hose clamps or screws to a wall.

QQF7.3QQ

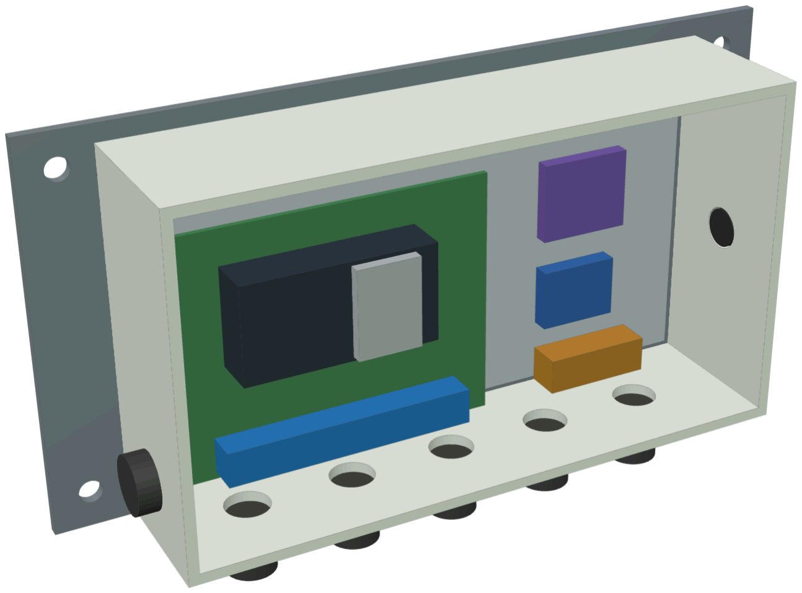
[picture p6: figure]

Fig. 7.3: Electronics enclosure with the lid removed: ESP32 board and terminals (left), INA219, buck converter and fuse (right), vent and side ACK button

QQF7.4QQ

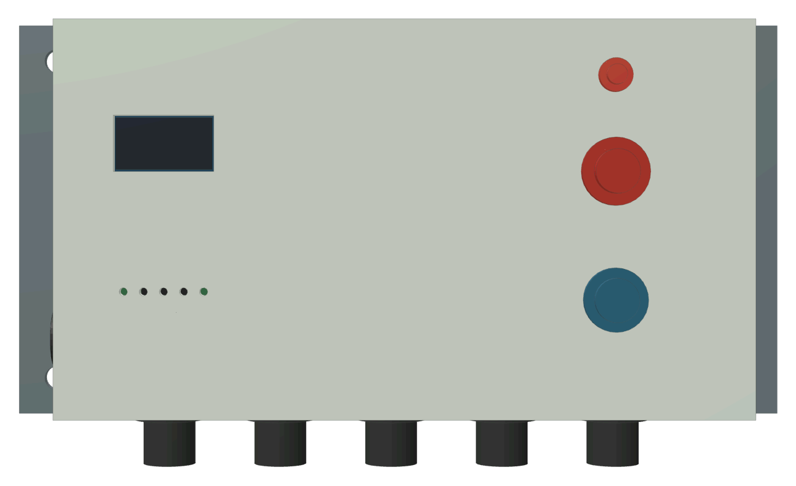
[picture p7: figure]

Fig. 7.4: Enclosure front panel

QQF7.5QQ

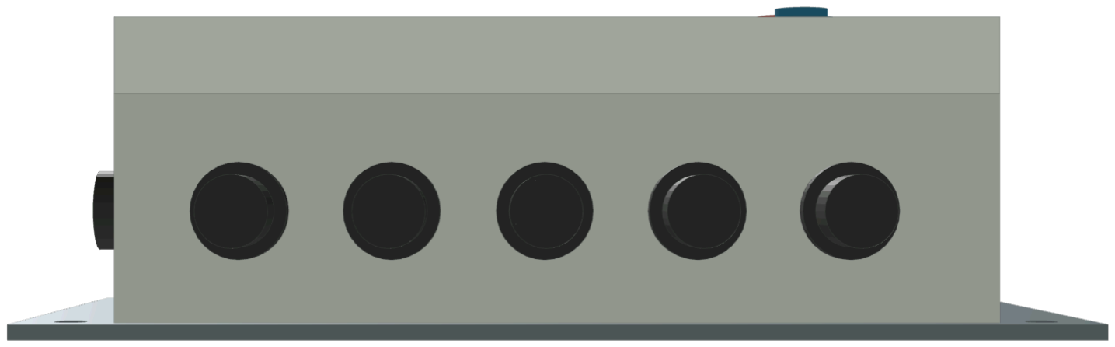
[picture p8: figure]

Fig. 7.5: Underside with five PG7 glands

QQT7.2QQ
Table 7.2: Principal dimensions of the electronics enclosure (mm, datum at front-left-bottom corner)
Feature | Dimension | Reason
Enclosure | 175 × 100 × 60, wall 3.0, lid depth 15 | Purchasable IP65 box with at least 10 mm of wiring space
OLED window | 25 × 14 at x = 15, z = 62 | Clears the 21.7 × 10.9 mm active area
HELP, MODE, LED | Ø12, Ø12, Ø8 on x = 140; z = 62, 30, 86 | One column for the right hand; LED above HELP
ACK button | Ø12 on right wall, y = 38, z = 50 | Reached only on purpose, by staff

Feature | Dimension | Reason
Cable glands | 5 × PG7 (Ø12.5) at x = 25, 55, 85, 115, 145, y = 38 | Face down; 30 mm pitch leaves room for a spanner
Vent | M12 (Ø12.5) on left wall, y = 38, z = 18 | Equalises pressure, limits condensation
Back bracket | 215 × 110 × 3 aluminium; 4 × Ø6.5 on 194 × 90; 4 slots 8 × 16 | Hose clamps on a 40–90 mm post, or wall anchors
Radiation shield | 5 plates Ø110 at 14 mm pitch on three M5 rods | Shades the air sensor while letting air pass
Fan | 120 × 120 × 25 with guards on both faces | Mounted on the rear rail with an adapter plate

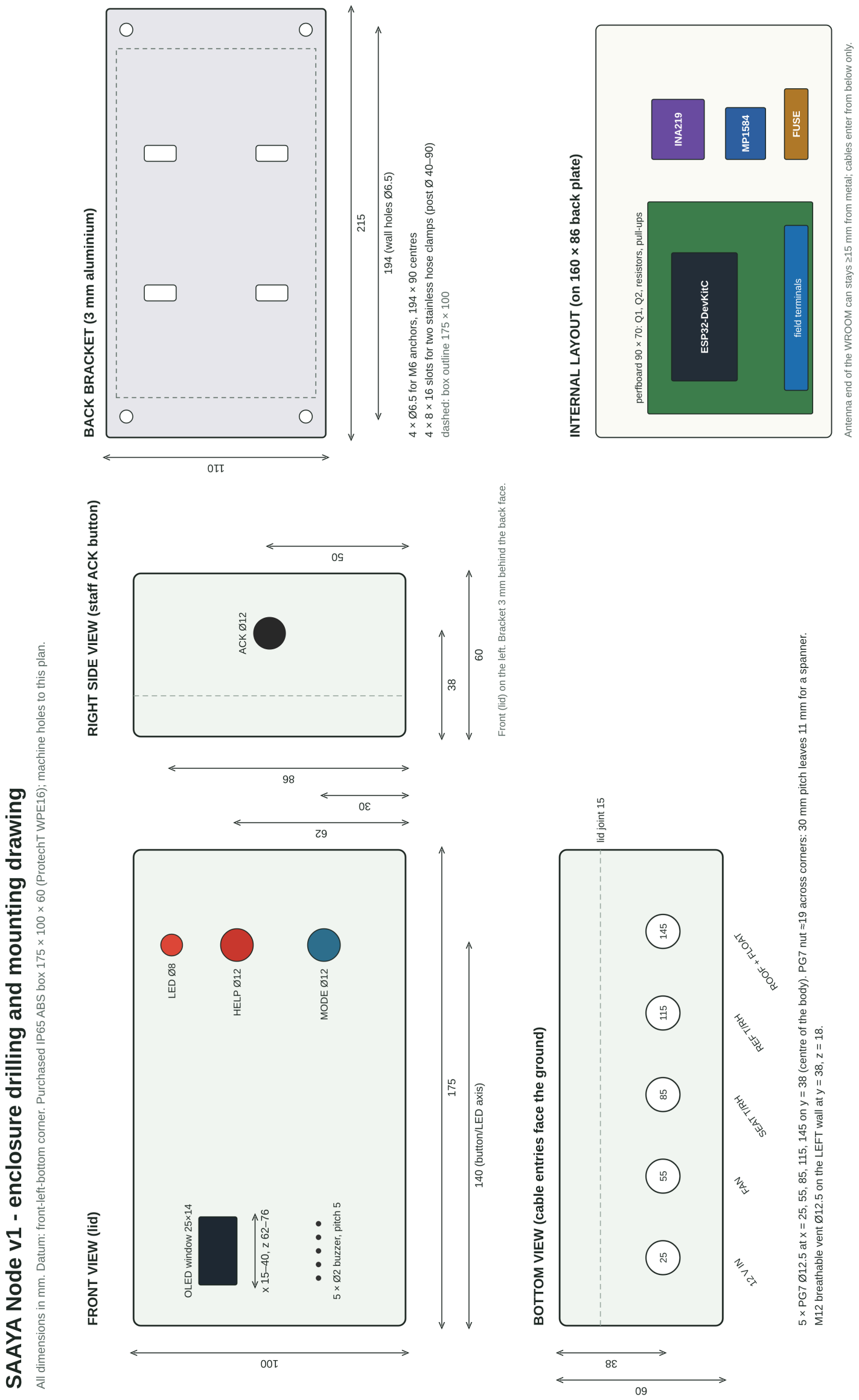
[picture p9: figure]

QQF7.6QQ

Fig. 7.6: Dimensioned drilling and mounting drawing of the electronics enclosure, back bracket and internal layout

QQC8QQ

### CHAPTER 8

### DEPLOYMENT CAPABILITY

QQS8_1QQ8.1 Installation area and orientation

The shelter is meant for construction sites, road projects, farms and factory yards where workers rest outdoors, with one shelter for every four to six people on break at the same time. A larger site with thirty to sixty workers would place several shelters near the work fronts rather than one large one, so that nobody has to walk far in the heat. The open front faces away from the afternoon sun, and the louvred screen goes on the west or south-west side, which takes the low afternoon sun in Vellore. The shelter should stand on shaded or planted ground where possible, not on light paving.

QQS8_2QQ8.2 Foundation and erection

Each post stands on a 200 × 200 × 10 mm base plate with four anchors into a small concrete footing or an existing slab. The side frames are welded in a workshop, carried to site and bolted to the crossbeams and purlins; the roof skins and spacers are then bolted on and the screen and bench fitted. The size of the footings and anchors depends on the soil and the local wind load and must be designed by a structural engineer for each site.

QQS8_3QQ8.3 Mounting the smart system

The electronics box is clamped to a rear post with its centre about 1.4 m above the floor, within easy reach and well above splashing water. The seat sensor stands beside the bench at 1.1 m, the head height of a seated person, and the reference sensor stands at least 2 m outside the roof edge at the same height so that the two readings can be compared fairly. The roof probe is fixed to the centre of the lining with thermal tape, and the fan is mounted on the rear rail about 1 m from the seat, tilted 30 to 45 degrees down (Fig. 8.1). Cables run in UV-stabilised conduit along the post and the purlins.

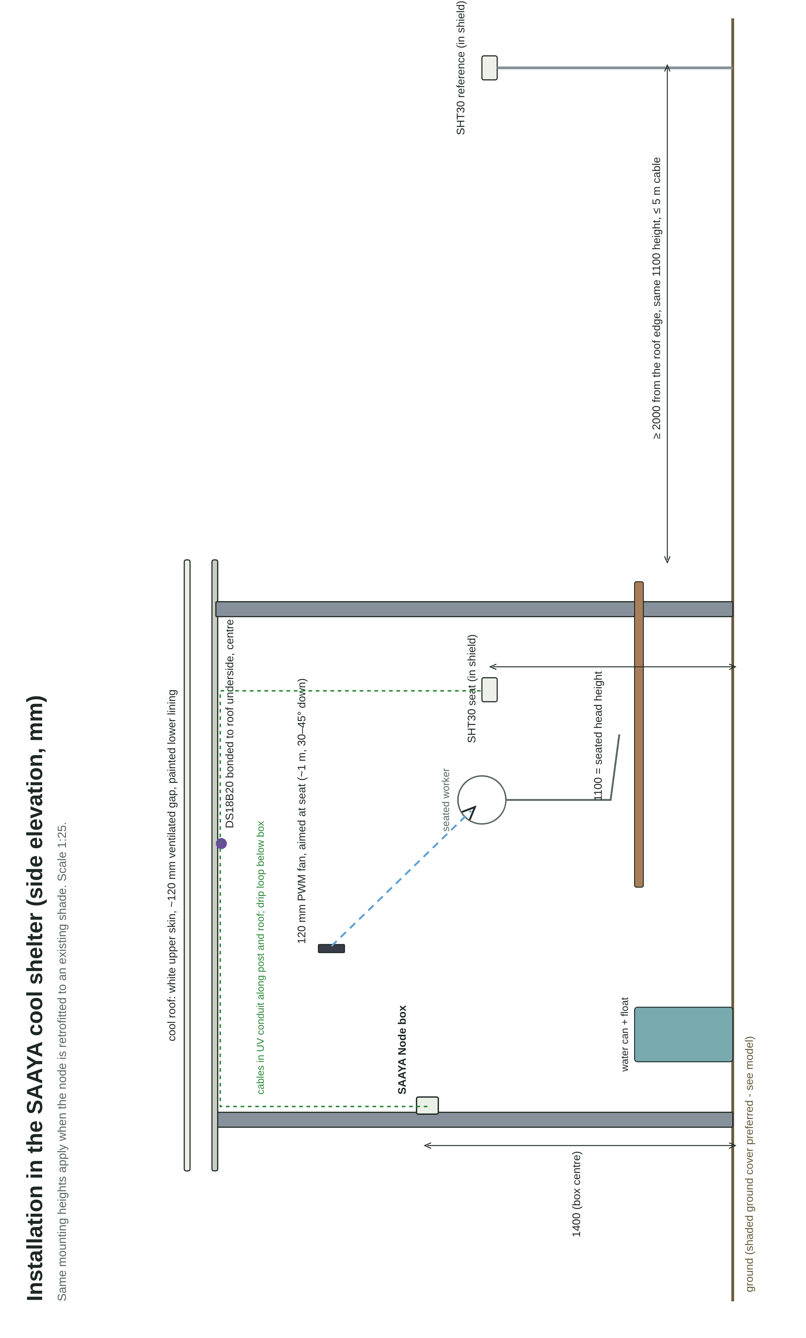
[picture p10: figure]

QQF8.1QQ

Fig. 8.1: Side elevation of the shelter showing mounting heights and sensor positions

QQS8_4QQ8.4 Power availability

Most sites have a 230 V socket in the site office or on a distribution board. The 12 V adapter is kept in the dry and only safe low voltage is run to the shelter. Peak demand is under 7 W. For sites without mains, the 34 Wh daily need can be met by a small solar panel on the roof and a battery.

QQS8_5QQ8.5 Connectivity

The system is offline-first: every control decision is made on the ESP32. Data can be collected in two ways. In the basic setup a laptop connected by USB runs the local logging software. In the Wi-Fi build, the node posts each reading to the supervisor’s laptop over the site network, authenticated with a device token. The Wi-Fi code runs as a separate task on the second processor core, so a weak signal can never delay the buttons, the help alarm or the fan. No cloud account or SIM card is needed, although a GSM or LoRa link could be added for remote sites.

QQS8_6QQ8.6 Environmental conditions

In Vellore the shaded air ranges from about 25 °C to 45 °C, afternoon humidity in the hot months is around 43 to 51 percent, and the north-east monsoon brings heavy rain from October to December. The roof falls towards a front gutter, the steel is galvanised or painted, the electronics are rated well above 60 °C, the enclosure is IP65 with its cable entries facing down and a vent for condensation, and the adapter is kept out of the sun and rain.

QQS8_7QQ8.7 Maintenance

QQT8.1QQ
Table 8.1: Maintenance schedule
Interval | Task
Weekly | Wipe the radiation shields and fan guard; check the float switch and refill the water can; clear leaves from the roof gap
Monthly | Check glands, cables and conduit; compare commanded and measured fan speed on the display; clean the gutter
Every three months | Place the two SHT30 sensors side by side for 20 minutes and record their offset; check bolt tightness and touch up paint
Yearly or when dirty | Wash or repaint the white top coat of the upper skin; inspect base plates and anchors for corrosion
On a fault message | The display names the fault (sensor, fan feedback or water); every electronic part is plugged in and can be replaced in minutes

QQS8_8QQ8.8 Retrofit option

Where a site already has a sound shed and cannot afford a new shelter, the same SAAYA Node can be clamped to an existing post and the roof underside painted. This brings the help request, fault detection and measurement to the existing shade for the cost of the electronics alone, and the measurements can later show whether a full cool shelter is worth building.

QQC9QQ

### CHAPTER 9

### IMPLEMENTATION AND TESTING

QQS9_1QQ9.1 Firmware structure

The firmware is written in C++ for the Arduino framework and built with PlatformIO. The decision logic (help latch, fan duty, start-up grace period and fault detection) is kept in a single header file with no hardware dependencies, so the same code can be compiled and tested on a computer. The main loop polls the buttons every cycle, applies the control logic and, once a second, reads the sensors, updates the display and prints one JSON record. A five-second hardware watchdog restarts the board if the loop hangs.

QQS9_2QQ9.2 Operating states

QQT9.1QQ
Table 9.1: Response of the system to each operating state
State or event | System response
Air below 32 °C, automatic mode | Fan off; it starts at 32 °C and stops below 31 °C
32 °C to 37 °C, automatic mode | Fan at 50 percent; normal display
37 °C to 39 °C | Fan allowed; display warns that benefit is limited for older or medicated people
39 °C or above | Automatic fan stops and restarts below 38.5 °C; display reads “HOT: FAN MAY ADD HEAT”; manual still allowed
MODE pressed | Switches between manual 70 percent and automatic (field build) or off (bench build)
HELP pressed | Request latched; LED, buzzer and display; kept in flash through a reset
ACK pressed by staff | Clears the request; HELP wins if both are pressed together
Fan commanded, tachometer below 100 rpm after 3 s | Fan feedback fault shown; any cooling claim for the period is withdrawn
Sensor missing or invalid | Sensor fault shown; readings marked unavailable, never zero; automatic mode disabled
Float switch open or wire broken | “WATER LOW / CHECK” shown
Firmware stalls | Watchdog restarts the board within 5 s; the help latch is restored

QQS9_3QQ9.3 Verification carried out

The firmware, including the optional Wi-Fi version, is compiled automatically on GitHub Actions for the esp32dev board. The control logic passes native C++ tests covering the help latch, manual override, fault detection, start-up grace, timer roll-over, hysteresis and the fan-benefit limit, and the same rules are tested in the Python data service and in the web demonstration. The data service has 89 automated tests. The shelter model passes the clash check over all 143 instances, the enclosure model over all 23 solids, and the public website is tested in a browser at desktop and phone widths.

The firmware is built in four versions on every change: the default bench build (manual fan only), the field build with the automatic fan band, the Wi-Fi build and a build for the newer Arduino-ESP32 core 3. All four compile without errors.

QQS9_4QQ9.4 Hardware simulation

Because the node has not yet been assembled, the complete circuit was simulated in two ways so that its behaviour can be demonstrated and checked before any soldering.

The first is an interactive simulator on the project website (Fig. 9.1). It draws every part of the node wired to the same ESP32 pins as the interfacing diagram: both SHT30 sensors, the DS18B20 roof probe, the INA219, the OLED, the 4-wire fan with its 2N3904 driver, the three buttons, the LED, the buzzer, the float switch and the 12 V to 5 V supply. The fan, help and fault decisions are not re-written for the website: the firmware’s own control header is compiled to WebAssembly and called directly, and an automated test confirms that it gives exactly the same answers as the normally compiled C++ on 5,000 random cases. The loop around it follows the firmware line by line, including the 35 ms button debounce, one-second sampling, the 2-pulses-per-revolution tachometer calculation, the inverted PWM through the transistor and the help latch kept in flash. The sensors return values set with sliders, and the fan follows a simple speed and current model; the page states clearly which parts are modelled.

The second is a complete project for the Wokwi ESP32 emulator [25], which runs the actual firmware on an emulated ESP32. Wokwi has no models of the SHT30, the INA219 or a 4-wire fan, so two custom chips were written in C: an SHT30 that answers the real command set with the datasheet CRC, and a fan branch that inverts the PWM like the 2N3904, produces two tachometer pulses per revolution and exposes the INA219 registers. Both chips were compiled with Wokwi’s compiler settings and tested against the same I²C transactions that the Adafruit libraries perform.

QQF9.1QQ

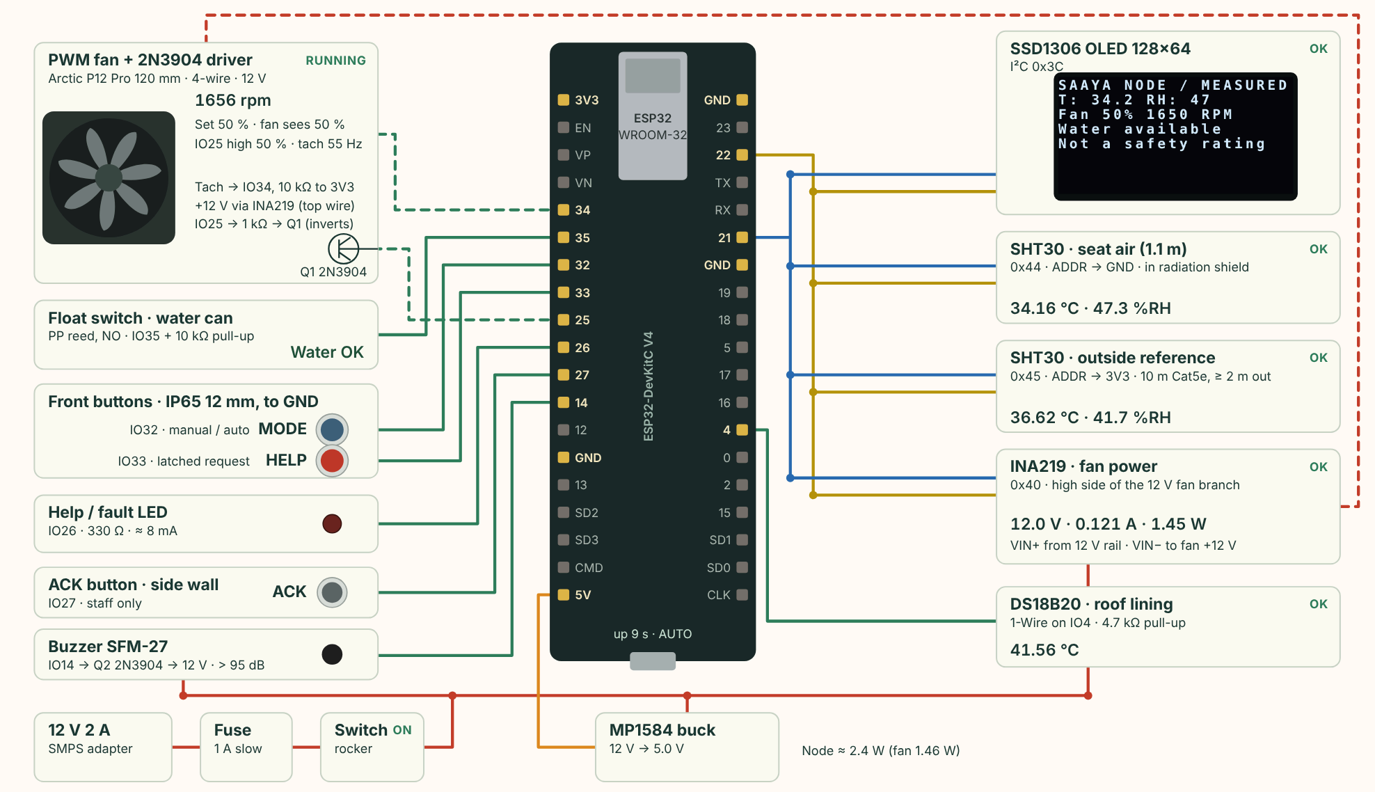
[picture p11: figure]

Fig. 9.1: Hardware simulator on the project website: field build, seat air 34.2 °C, fan running at 50 percent with tachometer feedback and the INA219 reading 1.45 W

QQT9.2QQ
Table 9.2: Behaviour checked automatically in the hardware simulator
Test | Expected and observed result
Seat air 33 °C, field build | Automatic fan at 50 percent; tachometer above 1,000 rpm; INA219 0.5 to 4.5 W; record marked valid
Seat air 40 °C | Automatic fan stops; OLED “HOT: FAN MAY ADD HEAT”; fan_advice = avoid
MODE at 40 °C | Manual fan at 70 percent: never blocked
Seat air 38.6 °C, then 38.2 °C | No restart above 38.5 °C; restarts below it
Fan rotor blocked; tachometer wire cut | FAN FEEDBACK FAULT after 3 s and LED on; clears when pulses return
HELP, then power cut, then ACK | Latched before the cut, restored from flash after reboot, cleared only by ACK
Seat sensor unplugged | SENSOR FAULT; temperature sent as null; automatic fan inhibited; recovers on reconnection
INA219 unplugged; float dropped | Power sent as null; OLED “WATER LOW / CHECK”
Default (bench) build at 34 °C | No automatic fan, as intended for bench use

All nine checks pass at desktop and phone screen widths and run on every change to the project. The simulation also exposed three faults in the earlier firmware, which were corrected: the two SHT30 addresses were the reverse of the design, the automatic fan band was switched off in the only build, and the first OLED line was one character too long for the 128-pixel display.

QQS9_5QQ9.5 Cost summary

The electronics cost about ₹5,314, of which ₹3,965 comes from prices listed on Indian supplier websites and the rest is estimated (Appendix A). The first shelter is estimated at ₹94,134 to ₹170,771, including steel, roof, fabrication, finishing, bench and screen, electronics allowance, foundations, transport, engineering review and a 15 percent contingency (Appendix B). This is a planning estimate, not a quotation. Repeated production, bolted standard sections and sites with an existing slab would bring the figure down, and the retrofit option costs only the electronics.

QQS9_6QQ9.6 Limitations

Several things have not yet been demonstrated: the real temperature of the roof underside and the air speed at the seat, the error introduced by the home-made radiation shields, the efficiency of the buck converter in a hot box, whether the enclosure stays watertight after drilling, the strength of the frame and its connections, and any effect on how workers feel. The structural sections need approval by a qualified engineer before anyone sits under a full-size shelter.

QQC10QQ

### CHAPTER 10

### CONCLUSION AND FUTURE WORK

QQS10_1QQ10.1 Conclusion

This project designed the SAAYA cool shelter, a demountable rest shelter for outdoor workers that keeps people cool mainly by passive means and uses a low-cost IoT system to control a fan sensibly, detect faults, handle help requests and measure the conditions it produces. The 2400 × 2000 mm steel frame carries a reflective, ventilated double roof with a 200 mm overhang, a louvred side screen and a bench for four to six people. The smart system uses an ESP32 with two SHT30 sensors, a DS18B20 roof probe, an INA219 power monitor, a four-wire PWM fan, an OLED display and three weatherproof buttons in a 175 × 100 × 60 mm IP65 box.

Two findings shaped the design more than anything else. A heat model showed that shade removes most of the radiant heat and that a cool, ventilated roof keeps the surface above people’s heads near air temperature, which set the order of priorities: shade and overhang, then the cool roof, then the ground around the shelter. Studies of fan use showed that a fan can add heat above about 39 °C, which led to a controller that steps back from automatic operation at that point instead of running harder.

QQS10_2QQ10.2 Future work

1. Have the frame and connections designed and approved by a structural engineer, and obtain a fabrication quotation in Vellore.
2. Build one shelter and two electronics units, place the sensors side by side to measure their offsets, and compare the roof underside and seat conditions with the model on at least three clear days.
3. Compare the single and double roof directly by removing the upper skin for some of the test days.
4. Add a GSM or LoRa link so that help requests reach a supervisor’s phone on sites without Wi-Fi, and design a small printed circuit board for the electronics.
5. Carry out a supervised field trial with worker consent and a proper safety protocol, and only then report any effect on comfort.

QQREFQQ

### REFERENCES

India Meteorological Department, climatological normals for Vellore (station 43303), 1991–2020, as tabulated in “Vellore,” Wikipedia.

[1]

International Labour Organization, Working on a Warmer Planet: The Impact of Heat Stress on Labour Productivity and Decent Work. Geneva: ILO, 2019.

[2]

M. Romanello et al., “The 2025 report of the Lancet Countdown on health and climate change,” The Lancet, 2025.

[3]

National Disaster Management Authority, Government of India, Guidelines for Cooling Centers (draft), New Delhi, May 2025.

[4]

A. Middel and E. S. Krayenhoff, “Micrometeorological determinants of pedestrian thermal exposure during record-breaking heat in Tempe, Arizona,” Science of the Total Environment, vol. 687, pp. 137–151, 2019.

[5]

Mahila Housing Trust, Combating Climate Change Induced Heat Stress in Ahmedabad: Cool Roof Interventions, Ahmedabad, 2017–2022.

[6]

N. M. Ravanelli, S. G. Hodder, G. Havenith and O. Jay, “Heart rate and body temperature responses to extreme heat and humidity with and without electric fans,” JAMA, vol. 313, no. 7, pp. 724–725, 2015.

[7]

D. Gagnon, S. A. Romero, M. N. Cramer, O. Jay and C. G. Crandall, “Age modulates physiological responses during fan use under extreme heat and humidity,” JAMA, vol. 316, no. 9, pp. 989–991, 2016.

[8]

N. B. Morris, T. English, L. Hospers, A. Capon and O. Jay, “The effects of electric fan use under differing resting heat index conditions: a clinical trial,” Annals of Internal Medicine, 2019.

[9]

N. B. Morris et al., “Electric fan use for cooling during hot weather: a biophysical modelling study,” The Lancet Planetary Health, vol. 5, no. 6, 2021.

[10]

World Health Organization, “Climate change, heat and health,” fact sheet. [Online]. Available: https://www.who.int/news-room/fact-sheets/detail/climate-change-heat-and-health

[11]

E. Teitelbaum et al., “Addressing a systematic error correcting for free and mixed convection when measuring mean radiant temperature with globe thermometers,” Scientific Reports, vol. 12, art. 6473, 2022.

[12]

W. C. Swinbank, “Long-wave radiation from clear skies,” Quarterly Journal of the Royal Meteorological Society, vol. 89, pp. 339–348, 1963.

[13]

J. H. Watmuff, W. W. S. Charters and D. Proctor, “Solar and wind induced external coefficients for solar collectors,” COMPLES, no. 2, p. 56, 1977.

[14]

Espressif Systems, ESP32 Series Datasheet, v5.3, and ESP32-DevKitC V4 User Guide. [Online]. Available: https://docs.espressif.com

[15]

Sensirion AG, Datasheet SHT3x-DIS: Humidity and Temperature Sensor, v7, Dec. 2022.

[16]

Intel Corporation, 4-Wire Pulse Width Modulation (PWM) Controlled Fans Specification, Rev. 1.2, Jul. 2004.

[17]

[18] Noctua, PWM Specifications White Paper. [Online]. Available: https://noctua.at

Monolithic Power Systems, MP1584 3 A, 1.5 MHz, 28 V Step-Down Converter, datasheet r1.1.

[19]

Espressif Systems, ESP32-WROOM-32E & ESP32-WROOM-32UE Datasheet, v2.1. [Online]. Available: https://documentation.espressif.com/esp32-wroom-32e_esp32-wroom-32ue_datasheet_en.pdf

[20]

Analog Devices (Maxim Integrated), DS18B20 Programmable Resolution 1-Wire Digital Thermometer, datasheet.

[21]

Texas Instruments, INA219 Zerø-Drift, Bidirectional Current/Power Monitor With I²C Interface, datasheet SBOS448.

[22]

Solomon Systech, SSD1306 128 × 64 Dot Matrix OLED/PLED Segment/Common Driver with Controller, Rev 1.1.

[23]

[24] onsemi, 2N3904 General Purpose Transistor, NPN Silicon, datasheet.
Wokwi, “ESP32 simulation” and “Diagram format” documentation. [Online]. Available: https://docs.wokwi.com

[25]

QQAPPAQQ

### APPENDIX A BILL OF MATERIALS

Prices were read from Indian supplier websites on 20 October 2026 and include GST where it was shown. Items marked “allowance” are estimates.

QQTA.1QQ
Table A.1: Bill of materials and cost
Function | Part | Qty | Unit | Amount | Status
Microcontroller | ESP32-DevKitC, 38-pin, ESP32-WROOM-32 | 1 | ₹499 | ₹499 | listed
Air T/RH (seat + reference) | GY-SHT30-D module, Sensirion SHT30 | 2 | ₹179 | ₹358 | listed
Roof surface temperature | DS18B20 waterproof probe, 1 m | 1 | ₹49 | ₹49 | listed
Fan power monitor | INA219 module (0.1 Ω shunt class) | 1 | ₹89 | ₹89 | listed
Local display | SSD1306 0.96" 128×64 I²C OLED | 1 | ₹130 | ₹130 | listed
Actuator | Arctic P12 Pro 120 mm 4-wire PWM fan | 1 | ₹910 | ₹910 | listed
PWM + buzzer drivers | 2N3904 NPN, TO-92 | 2 | ₹6 | ₹12 | listed
MODE / HELP / ACK | 12 mm IP65 metal momentary (ProMax) | 3 | ₹159 | ₹477 | listed
Status light | 5 mm red LED + 8 mm bezel | 1 | ₹4 | ₹4 | listed
Help sounder | SFM-27 active buzzer, 3–24 V | 1 | ₹60 | ₹60 | allowance
Water availability | PP float switch, reed, NO | 1 | ₹175 | ₹175 | listed
Power supply | 12 V 2 A SMPS adapter | 1 | ₹189 | ₹189 | listed
5 V rail | MP1584EN buck module | 1 | ₹49 | ₹49 | listed
Enclosure | ProtechT WPE16 IP65 ABS 175×100×60 | 1 | ₹949 | ₹949 | listed
Cable entries | PG7 nylon cable gland | 5 | ₹15 | ₹75 | listed
Protection | 5×20 fuse holder + 1 A T fuse | 1 | ₹19 | ₹19 | allowance (listed items out of stock)
Board + passives | perfboard 90×70, headers, resistors, terminal blocks | 1 | ₹150 | ₹150 | allowance
Power switch / vent | rocker switch + M12 breathable vent | 1 | ₹120 | ₹120 | allowance

Function | Part | Qty | Unit | Amount | Status
Field cable | Cat5e STP 10 m (sensor runs) | 1 | ₹250 | ₹250 | allowance
Radiation shields | 2 × DIY 5-plate PP shield on M5 rods | 1 | ₹300 | ₹300 | allowance
Mounting | 3 mm Al bracket, M6 anchors / 2 hose clamps, UV conduit | 1 | ₹450 | ₹450 | allowance
Total | listed prices ₹3,965; estimates ₹1,349 | | | ₹5,314 | excluding shipping and labour

Supplier pages: https://probots.co.in/esp32-wroom-32-nodemcu-38-pin-micro-usb-development-board.html; http s://probots.co.in/gy-sht30-d-digital-temperature-humidity-sensor-module-i2c.html; https://probots.co.in/ds18b20-w aterproof-temperature-sensor-for-arduino-raspberry.html; https://hubtronics.in/ina219-m; https://st.robu.in/product/0-96-inch-oled; https://mdcomputers.in/product/arctic-p12-pro-120mm-cabinet-fan-acfan00305a; https://probots.co.in/2n3904-npn-transistor-40v-0-2a-to92.html; https://probots.co.in/12mm-promax-pps12005rpm-metal-push-butt on-switch-waterproof-momentary-red.html; https://probots.co.in/5mm-red-led-diffused.html; https://st.robu.in/product/continuous-sound-electronic-active-buzzer-sfm-27-dc-3-24v; https://probots.co.in/water-level-float-sensor-swit ch-with-digital-output.html; https://probots.co.in/12v-2a-power-supply-smps-adaptor-premium.html; https://aws.robu.in/?p=2275994; https://probots.co.in/protecht-ip65-waterproof-plastic-enclosure-wpe16.html; https://probots.co.in/polymide-cable-glands-pg-07.html; https://hubtronics.in/5x20mm-glass-fuse-holder.

QQAPPBQQ

### APPENDIX B SHELTER COST ESTIMATE

The figures below are planning allowances worked out from the quantities in the 3D model (about 161 kg of structural steel at an assumed ₹80 to ₹140 per kg) and typical local rates. They are not supplier quotations and must be replaced by a dated fabrication quote before any decision is made.

QQTB.1QQ
Table B.1: First-article cost estimate of the cool shelter (₹)
Item | Low | High
Structural steel stock | ₹12,855 | ₹22,496
Roof materials, forming and sealed drainage | ₹9,000 | ₹16,000
Frame cutting, drilling, welding and jigs | ₹15,000 | ₹25,000
Corrosion protection and finishing | ₹5,000 | ₹9,000
Bench and removable screens | ₹8,000 | ₹14,000
Outdoor electronics, fan and protected low-voltage power | ₹6,000 | ₹12,000
Foundations, anchors and site preparation | ₹10,000 | ₹20,000
Transport, erection and installation | ₹8,000 | ₹15,000
Engineering review and first-article inspection | ₹8,000 | ₹15,000
Contingency / tax reconciliation allowance | ₹12,279 | ₹22,275
Total | ₹94,134 | ₹170,771

The electronics line in this table is a broad allowance; the detailed electronics bill in Appendix A comes to about ₹5,314. For comparison, a 1.5-ton inverter split air conditioner lists at about ₹36,990 for the equipment alone, but an air conditioner cannot cool an open shelter, so the two are not equivalent.
