alphasafal/saaya-verify/docs/node/enclosure-drawing.png

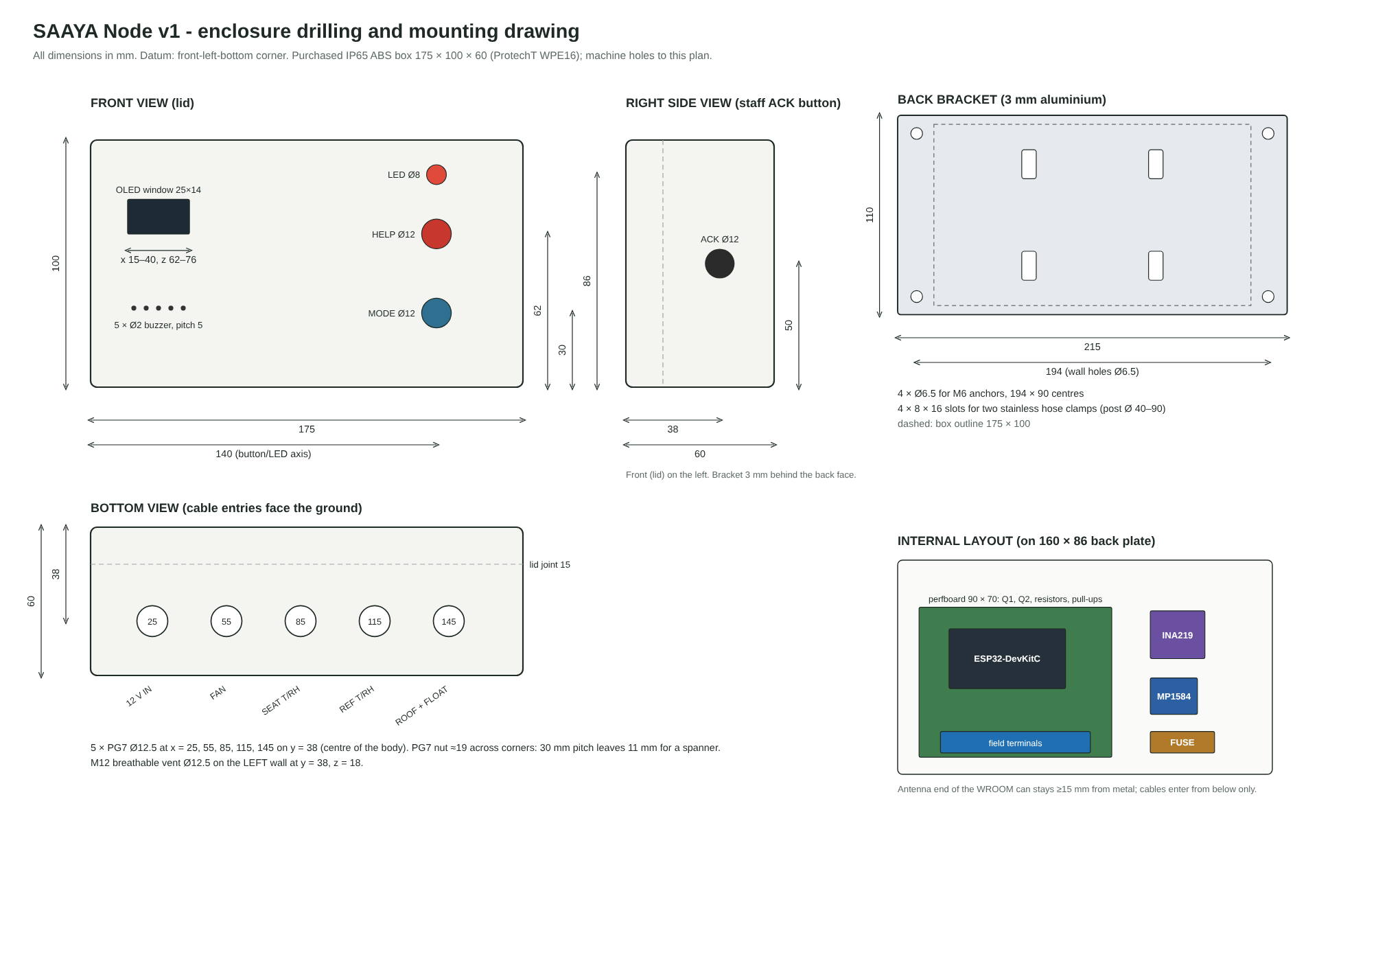
docs/node/enclosure-drawing.png
