alphasafal/saaya-verify/docs/node/interfacing-diagram.png

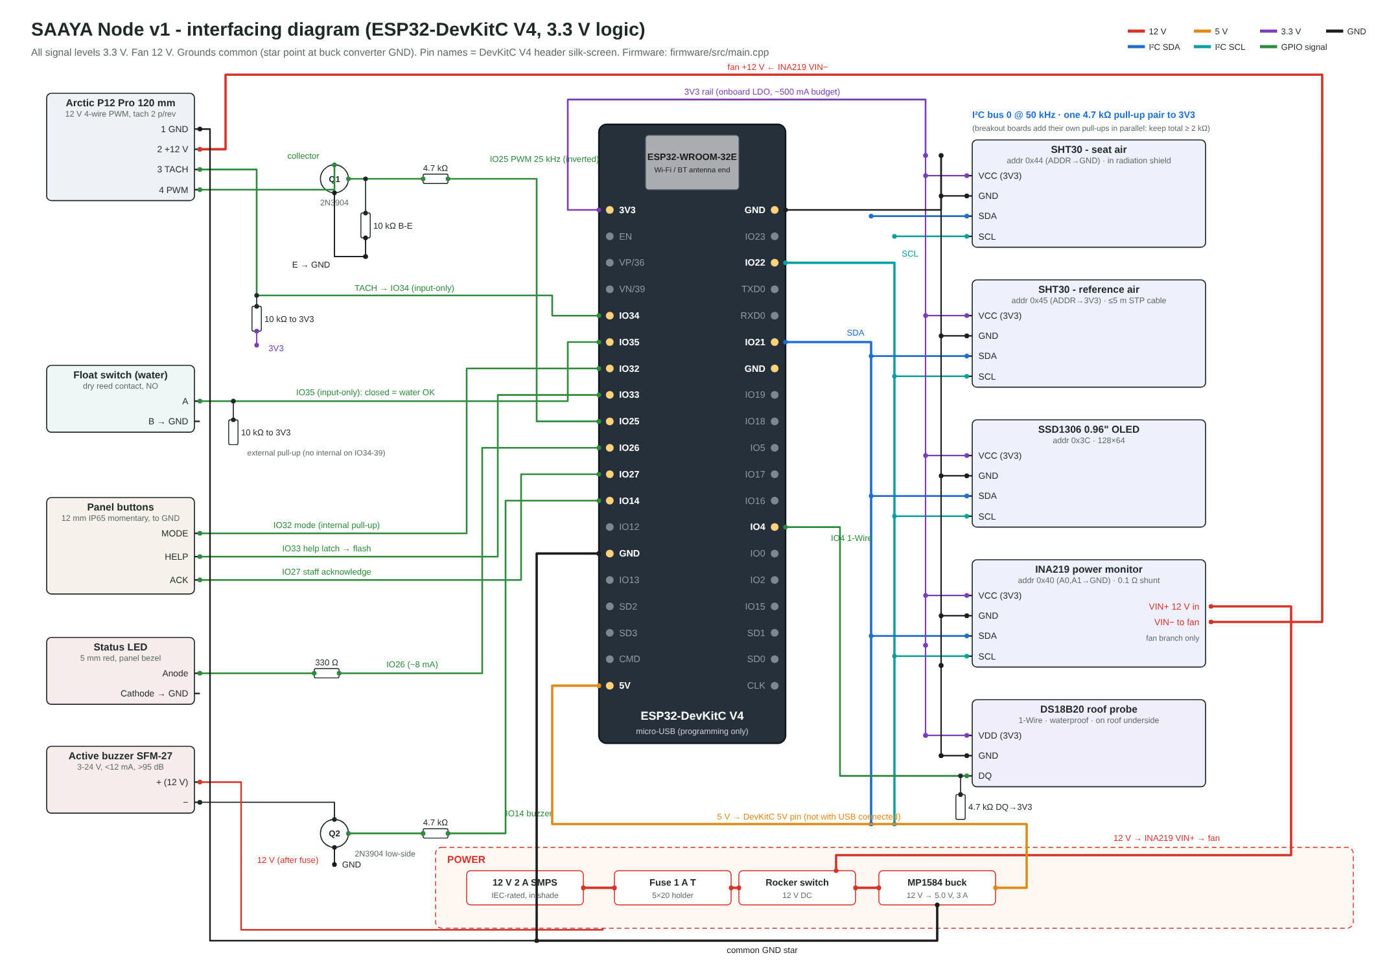
docs/node/interfacing-diagram.png
