alphasafal/saaya-verify/docs/report/img/enclosure-drawing-rot.png

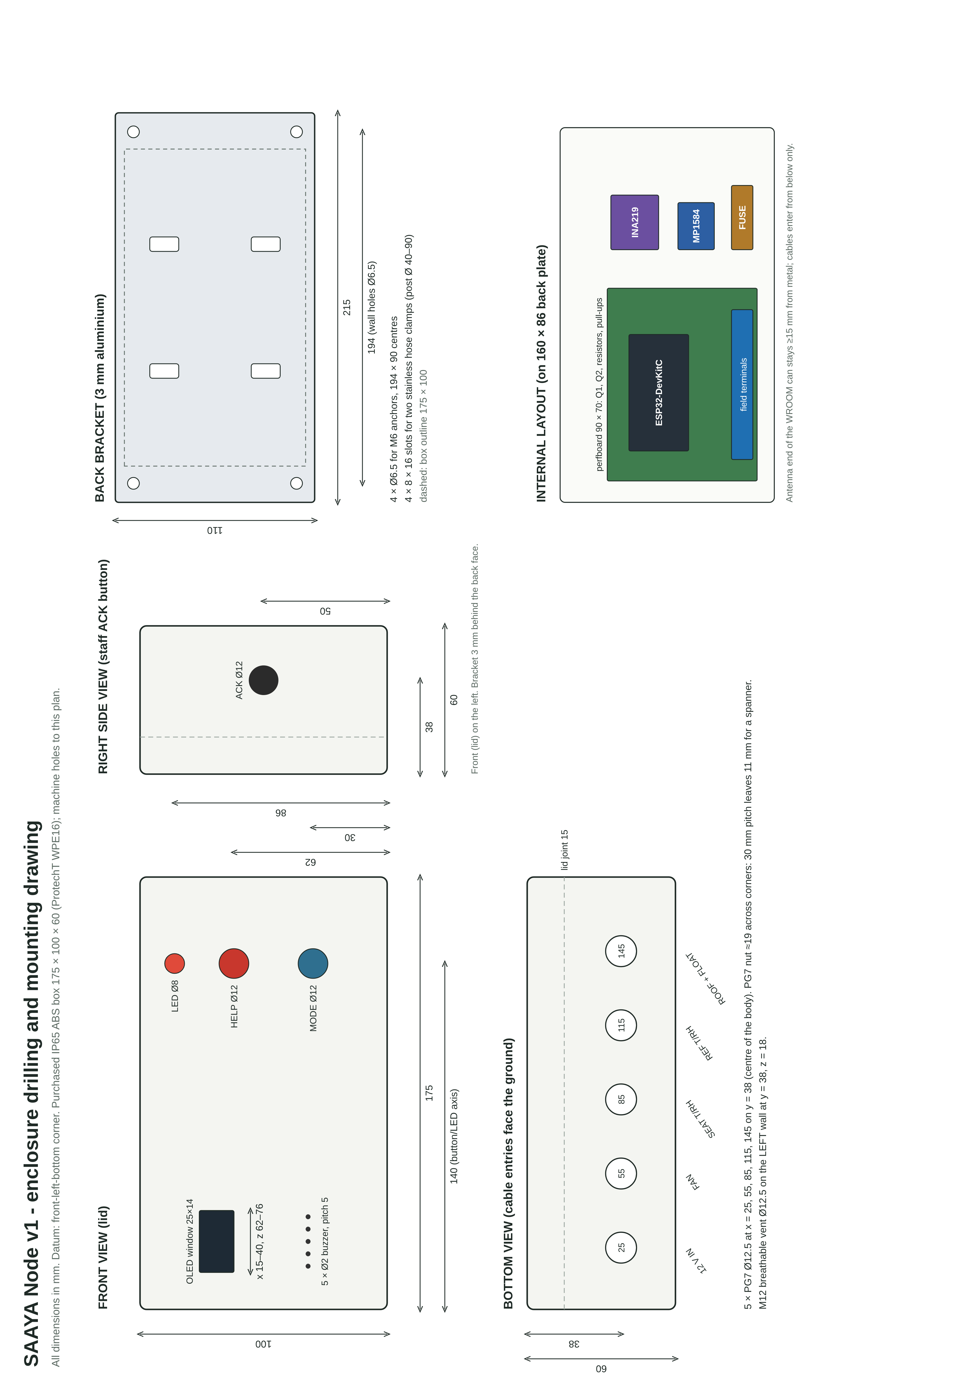
docs/report/img/enclosure-drawing-rot.png
