alphasafal/saaya-verify/docs/report/img/general-arrangement-rot.png

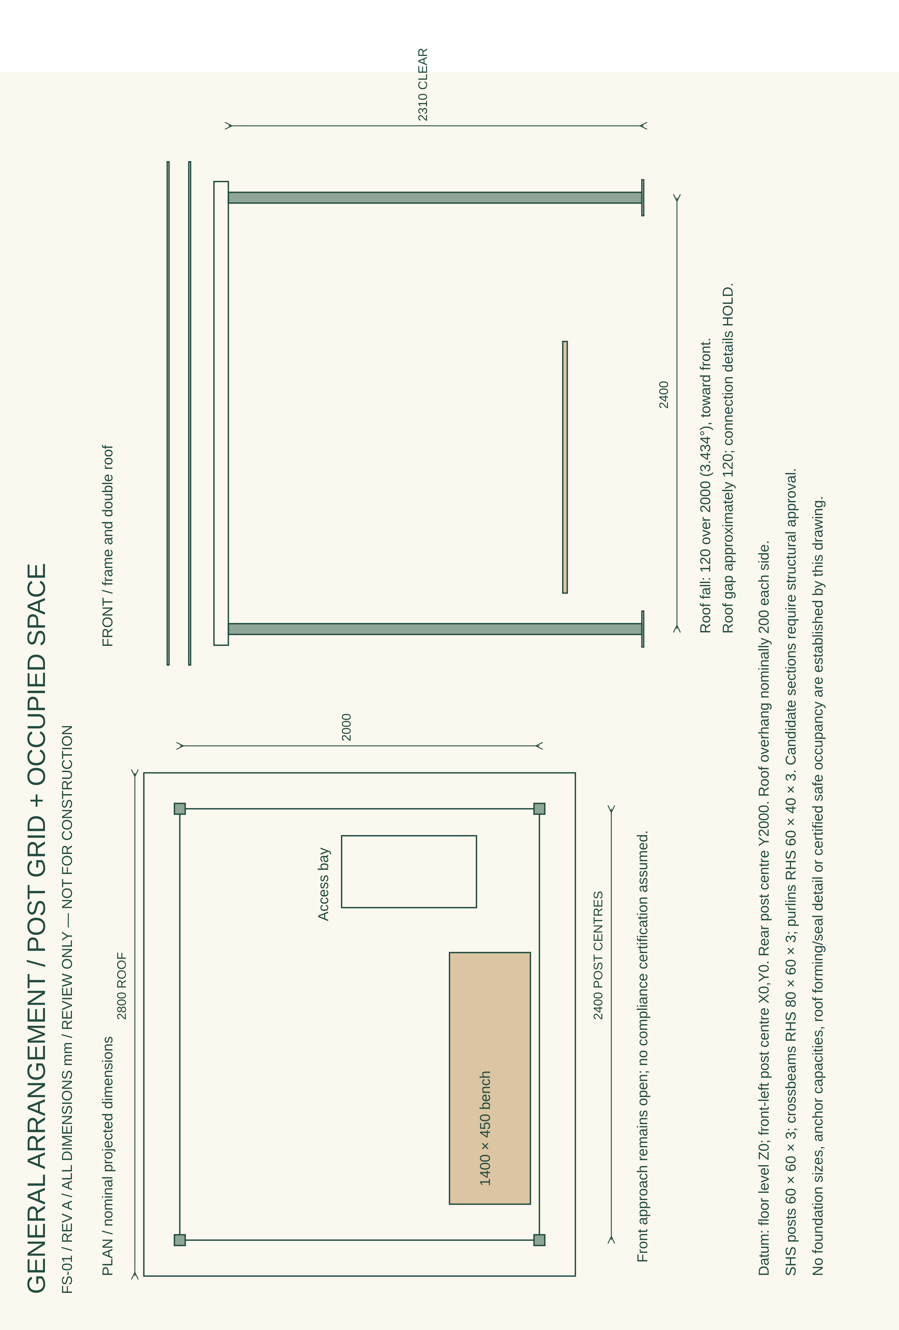
docs/report/img/general-arrangement-rot.png
