alphasafal/saaya-verify/docs/report/img/general-arrangement.png

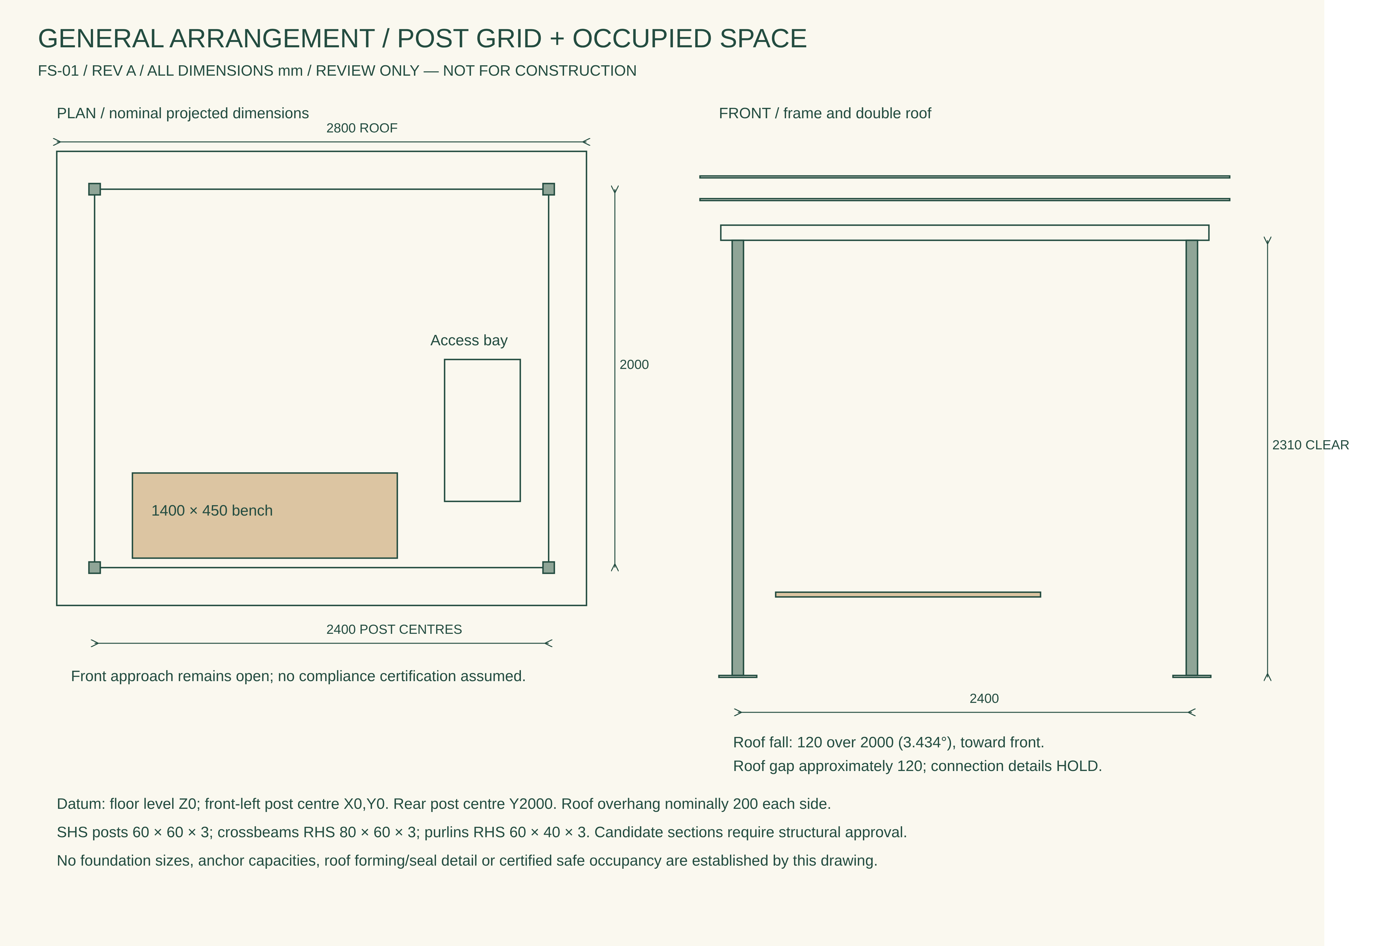
docs/report/img/general-arrangement.png
