alphasafal/saaya-verify/docs/report/img/interfacing-diagram-rot.png

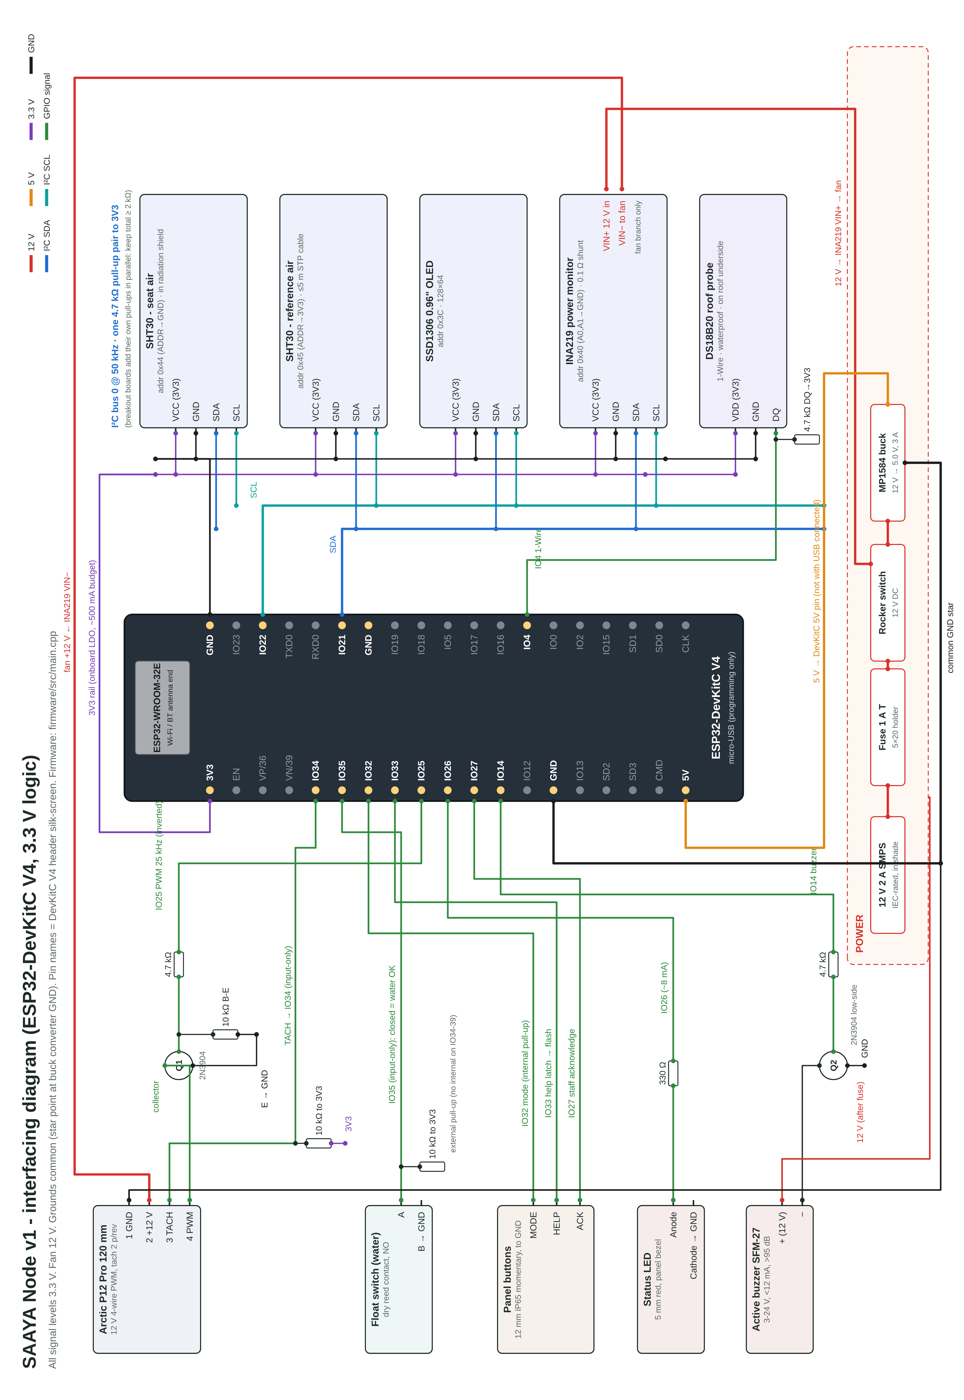
docs/report/img/interfacing-diagram-rot.png
