alphasafal/saaya-verify/docs/report/img/mrt-chart.png

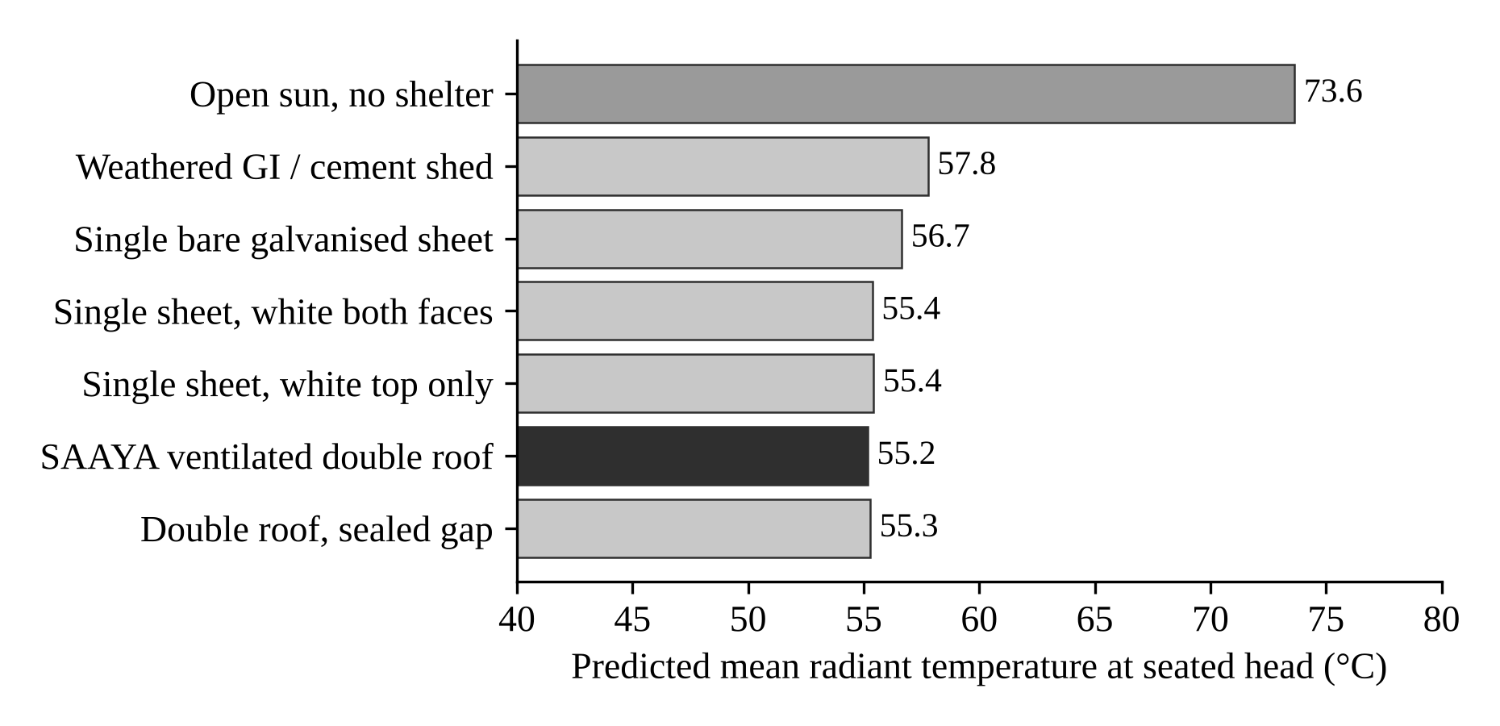
docs/report/img/mrt-chart.png
