alphasafal/saaya-verify/docs/report/img/shelter-front.png

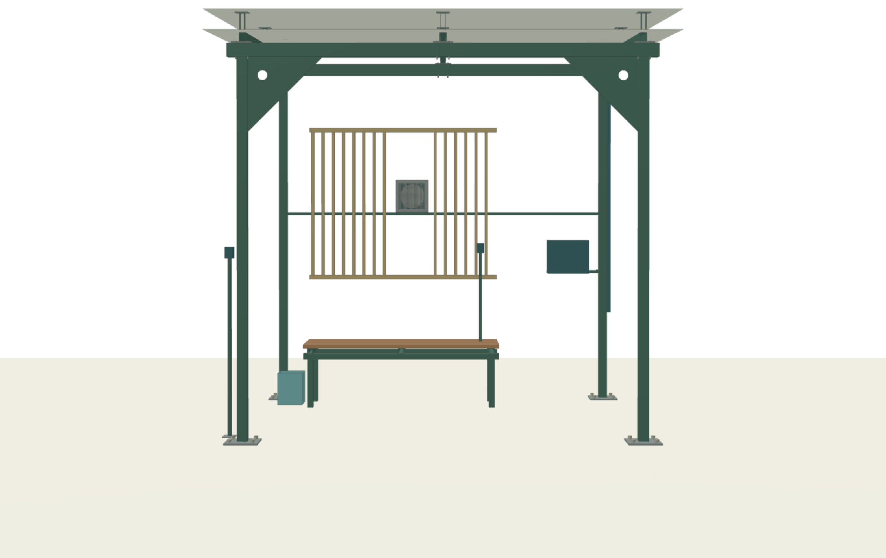
docs/report/img/shelter-front.png
