alphasafal/saaya-verify/site/downloads/sheet-1.png

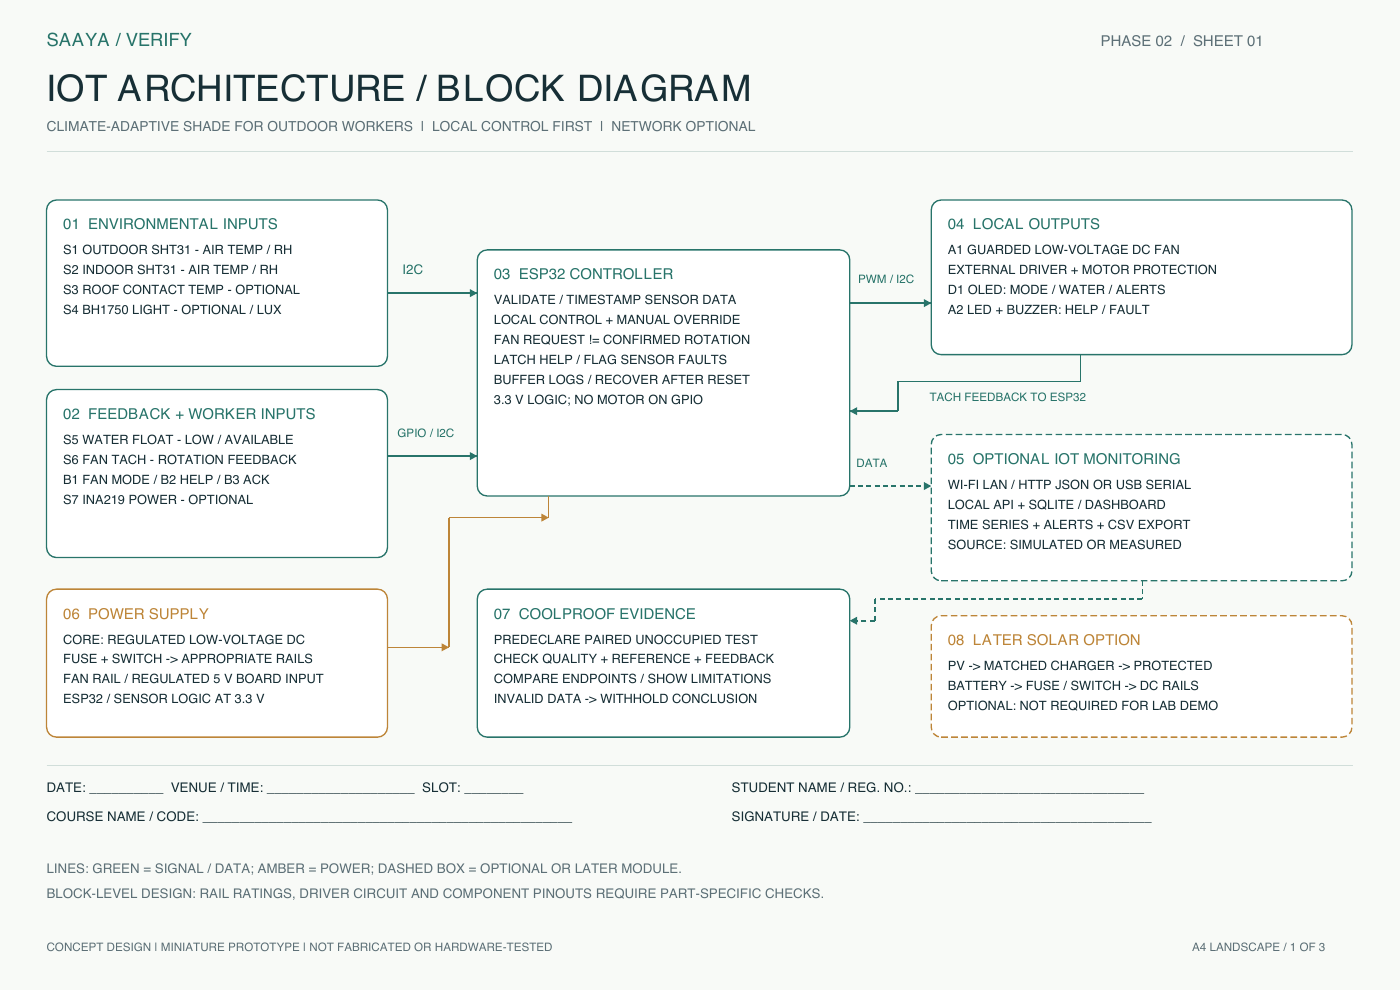
site/downloads/sheet-1.png
