alphasafal/saaya-verify/site/fullsize/bom.csv

part | quantity | material | process | envelope_mm | unit_mass_kg | mass_basis | note
BP01_base_plate | 4 | S235/S275 equivalent candidate; obtain mill certificate | Laser cut + drill | [200.0, 200.0, 10.022] | 3.06 | Idealized solid volume × assumed density; purchased electronics masses are placeholders | Four anchor holes; foundation and anchor design HOLD
P01_front_post | 2 | S235/S275 equivalent candidate; obtain mill certificate | Saw SHS 60x60x3; weld base | [60.0, 60.0, 2300.0] | 12.35 | Idealized solid volume × assumed density; purchased electronics masses are placeholders | Bottom at z10; cap/vent/drain detail by galvanizer
P02_rear_post | 2 | S235/S275 equivalent candidate; obtain mill certificate | Saw SHS 60x60x3; weld base | [60.0, 60.0, 2420.0] | 12.994 | Idealized solid volume × assumed density; purchased electronics masses are placeholders
B01_crossbeam | 2 | S235/S275 equivalent candidate; obtain mill certificate | Saw RHS 80x60x3 | [2580.0, 60.0, 80.014] | 16.23 | Idealized solid volume × assumed density; purchased electronics masses are placeholders | Connection plate/weld schedule requires structural review
R01_roof_purlin | 3 | S235/S275 equivalent candidate; obtain mill certificate | RHS 60x40x3; vertical end cuts | [40.0, 2000.0, 180.0] | 8.831 | Idealized solid volume × assumed density; purchased electronics masses are placeholders | Slope 3.434 degrees; span 2000; rear bottom seating relief up to 3 mm over 50 mm requires structural review
CP01_roof_connection | 6 | S235/S275 equivalent candidate; obtain mill certificate | Laser cut + drill | [120.0, 100.0, 6.014] | 0.547 | Idealized solid volume × assumed density; purchased electronics masses are placeholders | M10 proposed; hole pattern matched to bolt envelopes
SP01_roof_spacer | 9 | S235/S275 equivalent candidate; obtain mill certificate | Saw SHS 30x30x2 | [30.0, 30.0, 117.8] | 0.134 | Idealized solid volume × assumed density; purchased electronics masses are placeholders | Ventilation gap; bolted cap plates not load approved
CP02_spacer_cap | 9 | S235/S275 equivalent candidate; obtain mill certificate | Laser cut + drill | [80.0, 80.0, 7.8] | 0.147 | Idealized solid volume × assumed density; purchased electronics masses are placeholders | M6 proposed, isolate dissimilar metals
RF01_lower_skin | 1 | Aluminium sheet candidate | Cut/drill; split into transportable panels at fabrication | [2800.0, 2400.0, 145.0] | 18.143 | Idealized solid volume × assumed density; purchased electronics masses are placeholders | One solid envelope; seam/hem tooling detail HOLD
RF02_upper_skin | 1 | Coated steel sheet candidate | Cut/drill/form; reflective finish | [2800.0, 2400.0, 144.8] | 42.2 | Idealized solid volume × assumed density; purchased electronics masses are placeholders | Flat envelope; formed profile, laps, rain seal and uplift fixing HOLD
G01_knee_gusset | 2 | S235/S275 equivalent candidate; obtain mill certificate | Laser cut 6 mm; weld to frame | [450.0, 6.075, 450.0] | 4.636 | Idealized solid volume × assumed density; purchased electronics masses are placeholders | Weld access and buckling check HOLD
ST01_bench_leg | 4 | S235/S275 equivalent candidate; obtain mill certificate | Saw SHS 40x40x2 | [40.0, 40.0, 345.0] | 0.823 | Idealized solid volume × assumed density; purchased electronics masses are placeholders
ST02_bench_rail | 2 | S235/S275 equivalent candidate; obtain mill certificate | Saw SHS 40x40x2 | [1400.0, 40.0, 40.0] | 3.341 | Idealized solid volume × assumed density; purchased electronics masses are placeholders
ST04_bench_crossrail | 3 | S235/S275 equivalent candidate; obtain mill certificate | Saw SHS 40x40x2 | [450.0, 40.0, 40.0] | 1.074 | Idealized solid volume × assumed density; purchased electronics masses are placeholders | Transverse support beneath every slat; connection strength review required
ST03_seat_slat | 6 | Durable timber / recycled plastic candidate | Cut, radius edges, predrill | [1400.0, 70.0, 25.0] | 1.593 | Idealized solid volume × assumed density; purchased electronics masses are placeholders | Material/creep/fire specification and surface temperature test HOLD
JA01_louvre | 14 | Timber candidate | Cut and finish | [20.0, 40.0, 1070.0] | 0.556 | Idealized solid volume × assumed density; purchased electronics masses are placeholders | Interchangeable spacing; check wind load and splinters
JA02_screen_rail | 2 | S235/S275 equivalent candidate; obtain mill certificate | Saw RHS 30x30x2 | [1400.0, 30.0, 30.0] | 2.462 | Idealized solid volume × assumed density; purchased electronics masses are placeholders
E01_dry_enclosure | 1 | Aluminium candidate | Fold/weld or purchased enclosure adapted | [300.0, 120.004, 240.012] | 1.865 | Idealized solid volume × assumed density; purchased electronics masses are placeholders | Envelope only for enclosure process; seals, hinges, wall mounts and IP test HOLD
E02_service_lid | 1 | Aluminium candidate | Cut/drill | [300.0, 120.0, 3.006] | 0.291 | Idealized solid volume × assumed density; purchased electronics masses are placeholders | Gasket and threaded supports require supplier selection
E03_component_carrier | 1 | Aluminium candidate | Cut/drill | [260.0, 80.0, 3.006] | 0.168 | Idealized solid volume × assumed density; purchased electronics masses are placeholders | Insulated standoffs; board mounting holes transferred after component approval
F01_fan_cartridge | 1 | Aluminium candidate | Cut + drill | [240.0, 4.236, 240.0] | 0.315 | Idealized solid volume × assumed density; purchased electronics masses are placeholders | 154 mm fan bolt grid; confirm actual fan drawing/revision
F02_fan_guard | 2 | Aluminium candidate | Laser cut; deburr | [240.0, 3.007, 240.0] | 0.331 | Idealized solid volume × assumed density; purchased electronics masses are placeholders | 4 mm slots; finger/probe clearance, rigidity and airflow tests required
F03_reference_fan | 1 | Purchased Noctua NF-A20 PWM reference | Purchase | [200.0, 30.224, 200.0] | 0.218 | Idealized solid volume × assumed density; purchased electronics masses are placeholders | Not weather qualified; use an outdoor-rated substitute before release
S01_sensor_shield | 2 | UV-resistant polymer candidate | Print fit prototype; source qualified shield | [50.0, 50.0, 70.0] | 0.052 | Idealized solid volume × assumed density; purchased electronics masses are placeholders | Illustrative shield enclosure; ventilation/radiation performance unverified
E04_ESP32_reference | 1 | Purchased electronics | Purchase | [48.26, 27.94, 14.0] | 0.017 | Idealized solid volume × assumed density; purchased electronics masses are placeholders | Espressif DevKitC V4 PCB outline; connector/component heights require measurement
E05_monitor_reference | 1 | Purchased electronics | Purchase | [25.0, 20.0, 12.0] | 0.005 | Idealized solid volume × assumed density; purchased electronics masses are placeholders | INA219 nominal; exact supplier board HOLD
E06_display_reference | 1 | Purchased electronics | Purchase | [36.0, 6.0, 24.0] | 0.005 | Idealized solid volume × assumed density; purchased electronics masses are placeholders | OLED nominal; final module/drawing HOLD
S02_roof_probe | 1 | Stainless probe reference | Purchase | [6.004, 6.006, 50.007] | 0.011 | Idealized solid volume × assumed density; purchased electronics masses are placeholders | Probe dimensional allowance, supplier confirmation required
W01_optional_water_vessel | 1 | Polymer vessel candidate | Purchase | [180.0, 180.0, 230.0] | 0.728 | Idealized solid volume × assumed density; purchased electronics masses are placeholders | Empty removable experiment vessel; no potable-water or cooling claim
HW01_M10_bolt_reference | 24 | Steel hardware | Purchase | [16.01, 16.015, 106.016] | 0.071 | Idealized solid volume × assumed density; purchased electronics masses are placeholders | Unthreaded solid envelope; grade/length/washer/torque approval HOLD
HW02_M16_anchor_reference | 16 | Anchor hardware | Purchase | [26.016, 26.024, 210.026] | 0.357 | Idealized solid volume × assumed density; purchased electronics masses are placeholders | Geometry ONLY; embedment and capacity not designed
C01_cable_trunk | 1 | UV-resistant conduit candidate | Cut and mechanically fasten | [25.0, 18.0, 1700.0] | 0.233 | Idealized solid volume × assumed density; purchased electronics masses are placeholders | No mains wiring in model; secure clamps and drip loops required
MT01_rear_service_rail | 1 | S235/S275 equivalent candidate; obtain mill certificate | Saw RHS 20x20x2 | [2340.0, 20.0, 20.0] | 2.645 | Idealized solid volume × assumed density; purchased electronics masses are placeholders | Rear support rail; weld/attachment verification required
MT02_fan_support_arm | 2 | S235/S275 equivalent candidate; obtain mill certificate | Saw RHS 20x20x2 | [90.0, 20.0, 20.0] | 0.102 | Idealized solid volume × assumed density; purchased electronics masses are placeholders | Rotate along Y; weld to rail
MT03_enclosure_backrail | 1 | S235/S275 equivalent candidate; obtain mill certificate | Saw RHS 20x20x2 | [400.0, 20.0, 20.0] | 0.452 | Idealized solid volume × assumed density; purchased electronics masses are placeholders | Bracket attachment and back-wall sealing HOLD
MT04_enclosure_return | 1 | S235/S275 equivalent candidate; obtain mill certificate | Saw RHS 20x20x2 | [110.0, 20.0, 20.0] | 0.124 | Idealized solid volume × assumed density; purchased electronics masses are placeholders
MT05_seated_sensor_stem | 1 | S235/S275 equivalent candidate; obtain mill certificate | Saw SHS 20x20x2 | [20.0, 20.0, 650.0] | 0.735 | Idealized solid volume × assumed density; purchased electronics masses are placeholders | Bench mount fastener detail HOLD
MT06_reference_sensor_stem | 1 | S235/S275 equivalent candidate; obtain mill certificate | Saw SHS 20x20x2 | [20.0, 20.0, 1096.0] | 1.239 | Idealized solid volume × assumed density; purchased electronics masses are placeholders | Independent reference support; anti-tip/anchor verification HOLD
MT07_sensor_foot | 1 | S235/S275 equivalent candidate; obtain mill certificate | Laser cut/drill | [80.0, 80.0, 4.008] | 0.197 | Idealized solid volume × assumed density; purchased electronics masses are placeholders
E07_button_reference | 3 | Purchased switch | Purchase | [6.006, 10.007, 6.004] | 0.0 | Idealized solid volume × assumed density; purchased electronics masses are placeholders | Envelope only; choose exact panel switch
E08_LED_reference | 1 | Purchased indicator | Purchase | [3.003, 5.004, 3.002] | 0.0 | Idealized solid volume × assumed density; purchased electronics masses are placeholders | Envelope only
E09_buzzer_reference | 1 | Purchased buzzer | Purchase | [12.0, 12.0, 8.0] | 0.001 | Idealized solid volume × assumed density; purchased electronics masses are placeholders | Envelope only; audible level unverified
S03_SHT31_reference | 2 | Purchased sensor | Purchase | [12.7, 18.0, 2.6] | 0.001 | Idealized solid volume × assumed density; purchased electronics masses are placeholders | Adafruit 2857 current outline reference; confirm purchased revision
W02_float_reference | 1 | Purchased level switch | Purchase | [8.0, 20.0, 12.0] | 0.002 | Idealized solid volume × assumed density; purchased electronics masses are placeholders | Nominal envelope; material compatibility and wiring unverified
