alphasafal/saaya-verify/cad/node/exports/main_board.stl

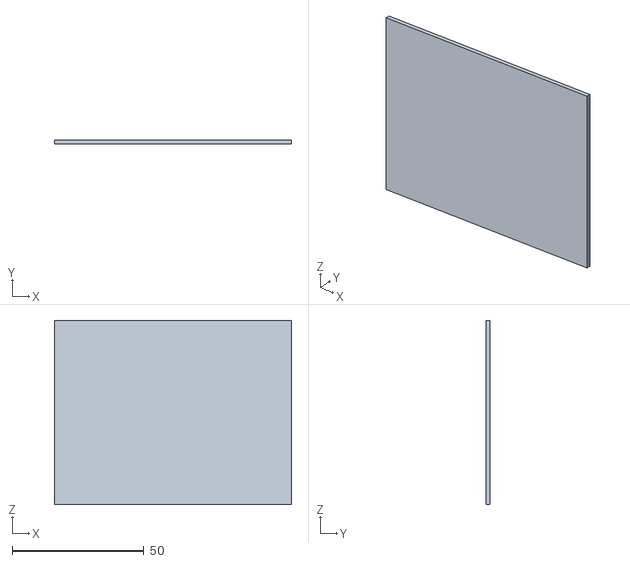
[picture p33: CAD file, 2026-10-20]
cad/node/exports/main_board.stl
90.0 x 1.60 x 70.0
