alphasafal/saaya-verify/cad/fullsize/exports/SAAYA_FS01_assembly.step

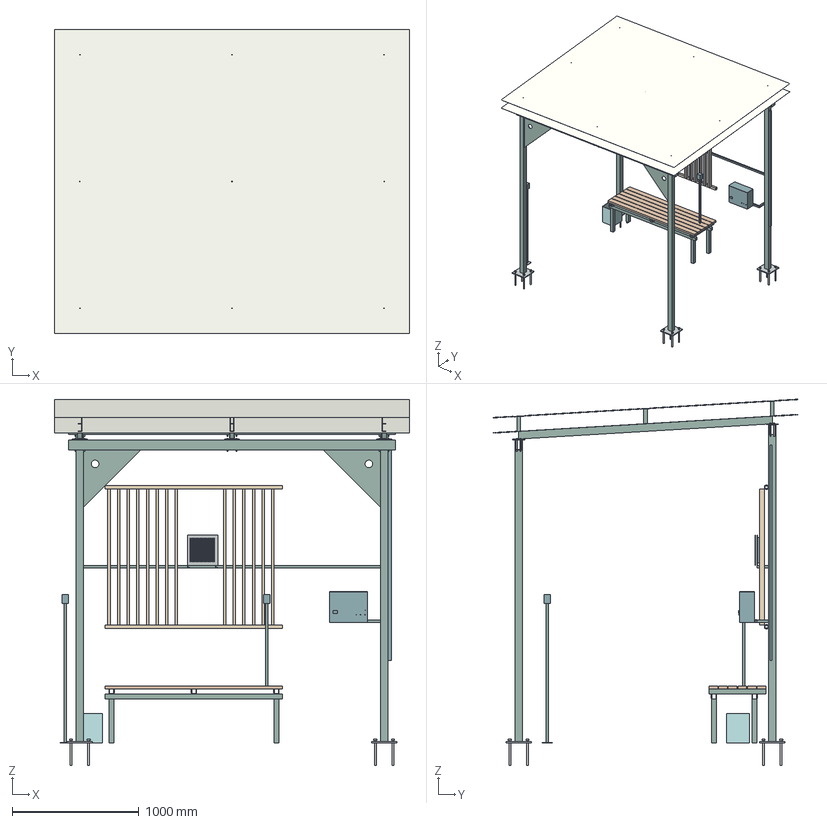
[picture p34: CAD file, 2026-10-12]
cad/fullsize/exports/SAAYA_FS01_assembly.step
2800.0 x 2400.0 x 2888.8 mm
base_0 x 4
post_0 x 2
anchor_0_0 x 16
post_2 x 2
crossbeam_0 x 2
purlin_0 x 3
connection_0_0 x 6
roof_bolt_0_0_0 x 24
lower_roof
upper_roof
roof_spacer_0_0 x 9
roof_cap_0_0 x 9
front_knee_0 x 2
bench_leg_0 x 4
bench_rail_0 x 2
bench_crossrail_0 x 3
seat_slat_0 x 6
screen_rail_0 x 2
louvre_0 x 14
dry_enclosure
service_lid
component_carrier
ESP32
INA219
OLED
fan_mount
reference_fan
front_fan_guard x 2
reference_sensor x 2
roof_probe
optional_water
cable_route
rear_service_rail
fan_support_arm_0 x 2
enclosure_backrail
enclosure_return
seated_sensor_stem
reference_sensor_stem
reference_sensor_foot
mode_button x 3
assistance_LED
assistance_buzzer
outdoor_SHT31 x 2
water_availability_switch
