alphasafal/saaya-verify/cad/exports/fan_angle_bracket.stl

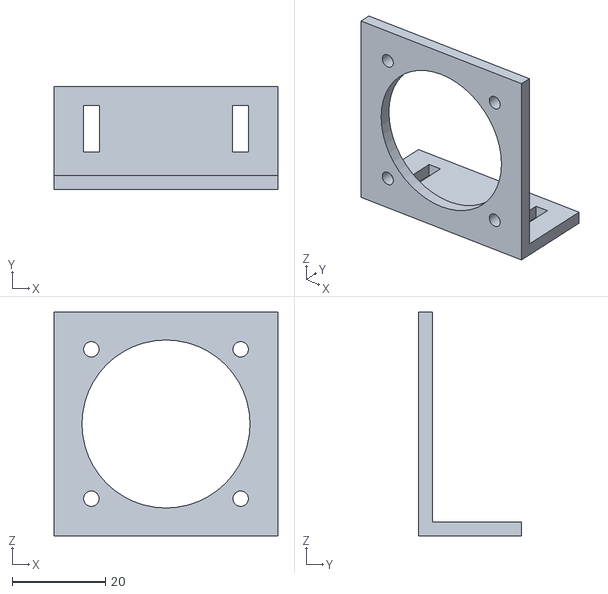
[picture p35: CAD file, 2026-10-11]
cad/exports/fan_angle_bracket.stl
48.0 x 22.0 x 48.0
