alphasafal/saaya-verify/cad/fullsize/exports/ST04_bench_crossrail.step

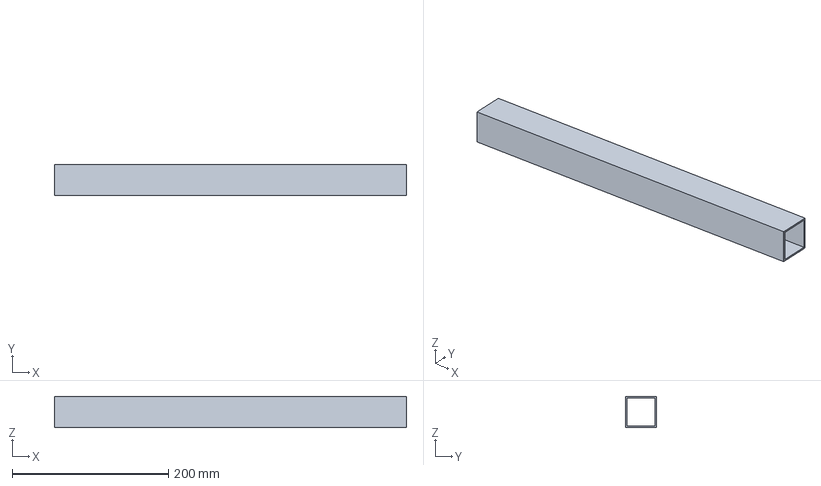
[picture p36: CAD file, 2026-10-12]
cad/fullsize/exports/ST04_bench_crossrail.step
450.0 x 40.0 x 40.0 mm
