alphasafal/saaya-verify/cad/node/exports/buck.stl

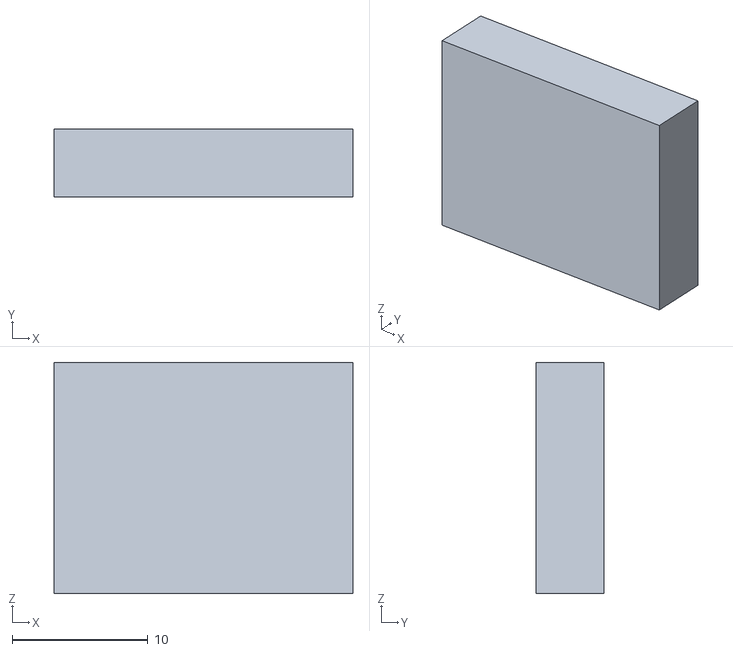
[picture p37: CAD file, 2026-10-20]
cad/node/exports/buck.stl
22.0 x 5.00 x 17.0
