alphasafal/saaya-verify/cad/pavilion/exports/air_sensor_4.stl

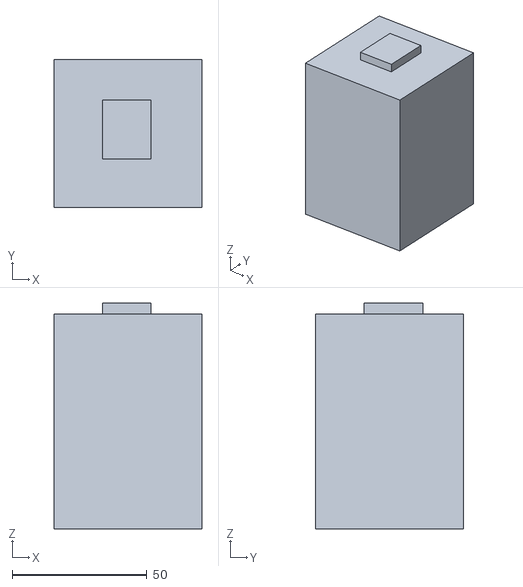
[picture p38: CAD file, 2026-10-13]
cad/pavilion/exports/air_sensor_4.stl
55.0 x 55.0 x 84.0
