alphasafal/saaya-verify/site/fullsize/P01_front_post.step

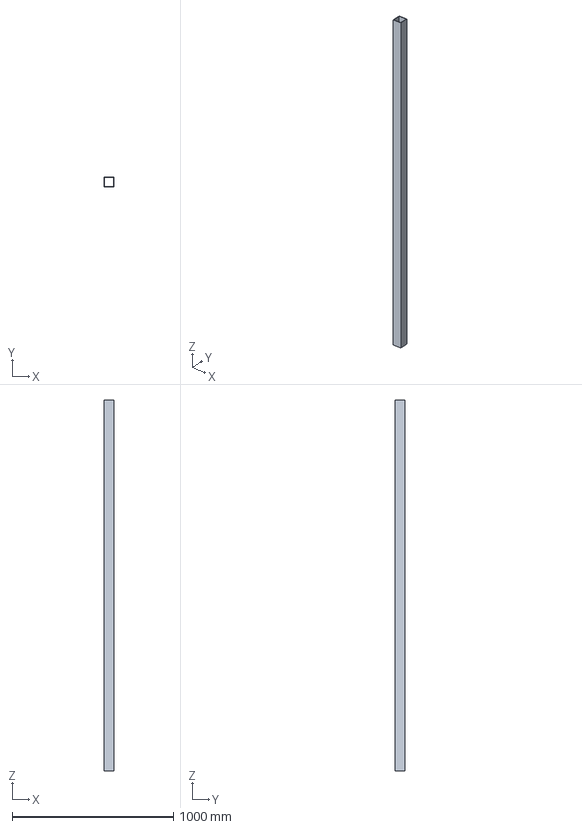
[picture p39: CAD file, 2026-10-12]
site/fullsize/P01_front_post.step
60.0 x 60.0 x 2300.0 mm
