alphasafal/saaya-verify/site/node/enclosure_body.stl

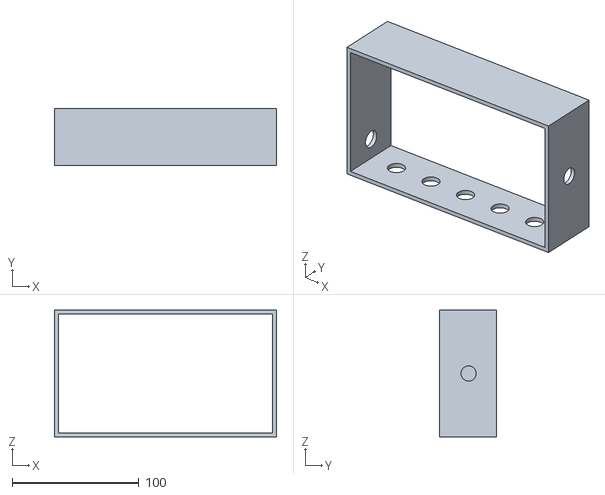
[picture p40: CAD file, 2026-10-20]
site/node/enclosure_body.stl
175.0 x 45.0 x 100.0
