alphasafal/saaya-verify/site/pavilion/lower_roof.stl

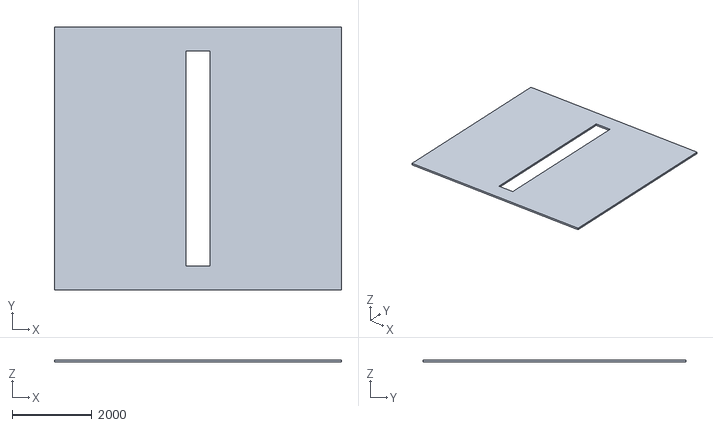
[picture p41: CAD file, 2026-10-13]
site/pavilion/lower_roof.stl
7200.0 x 6600.0 x 60.0
