alphasafal/saaya-verify/cad/exports/jaali_coupon_pitch_8.stl

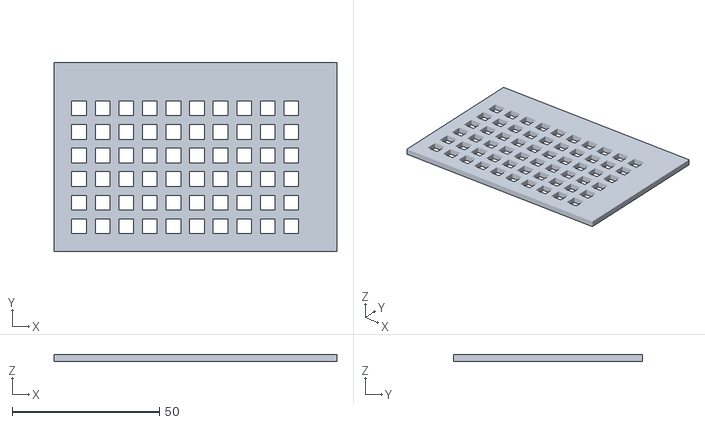
[picture p42: CAD file, 2026-10-11]
cad/exports/jaali_coupon_pitch_8.stl
96.0 x 64.0 x 2.40
