alphasafal/saaya-verify/cad/fullsize/exports/RF02_upper_skin.step

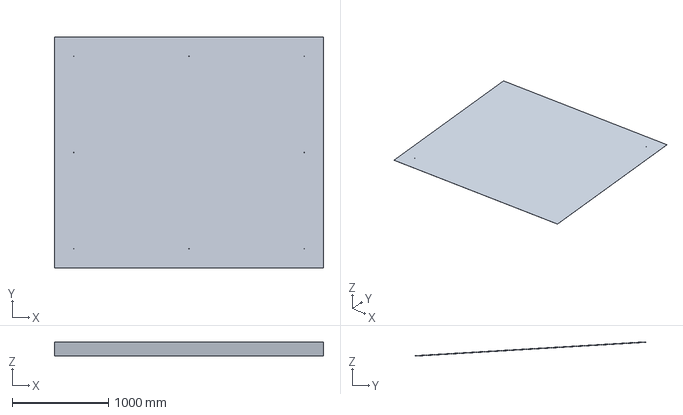
[picture p43: CAD file, 2026-10-12]
cad/fullsize/exports/RF02_upper_skin.step
2800.0 x 2400.0 x 144.8 mm
