alphasafal/saaya-verify/cad/node/exports/esp32_devkitc.stl

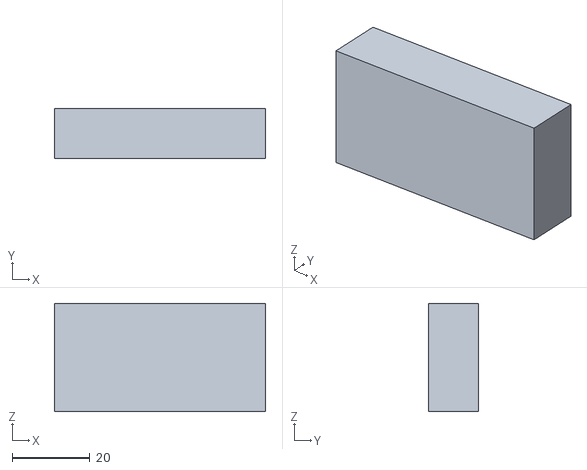
[picture p44: CAD file, 2026-10-20]
cad/node/exports/esp32_devkitc.stl
54.4 x 13.0 x 27.9
