alphasafal/saaya-verify/site/downloads/enclosure_base.stl

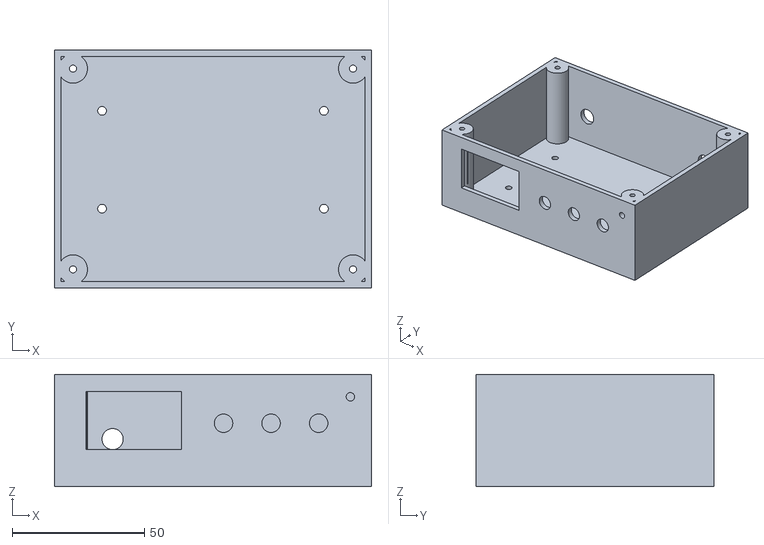
[picture p45: CAD file, 2026-10-11]
site/downloads/enclosure_base.stl
120.0 x 90.0 x 42.5
