alphasafal/saaya-verify/site/fullsize/SP01_roof_spacer.step

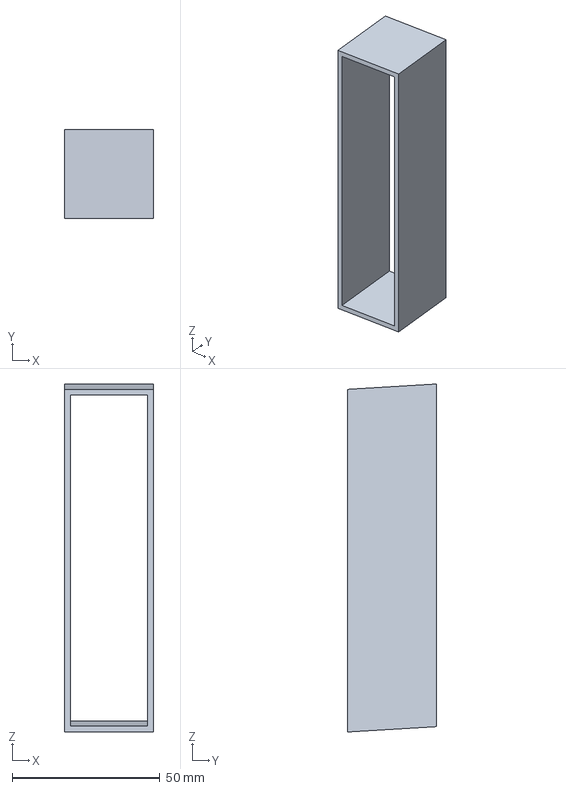
[picture p46: CAD file, 2026-10-12]
site/fullsize/SP01_roof_spacer.step
30.0 x 30.0 x 117.8 mm
