alphasafal/saaya-verify/site/node/fan_guard.stl

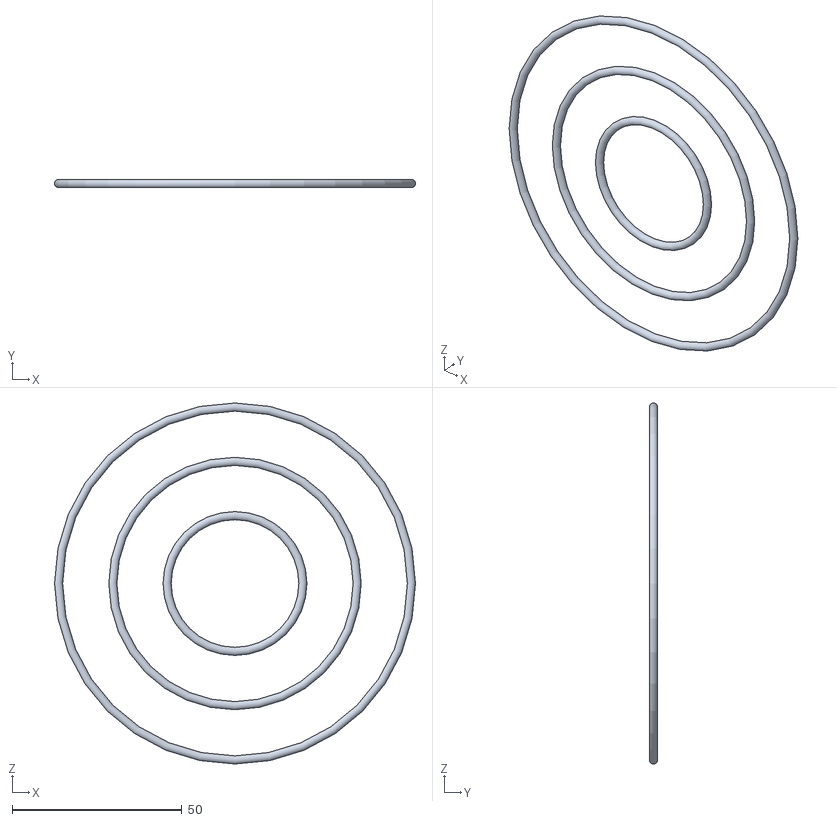
[picture p47: CAD file, 2026-10-20]
site/node/fan_guard.stl
106.4 x 2.40 x 106.4
