alphasafal/saaya-verify/site/pavilion/fan_2.stl

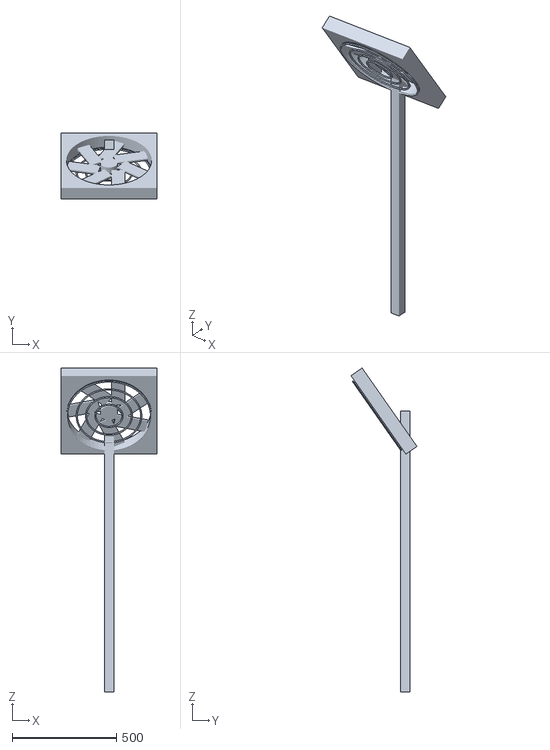
[picture p48: CAD file, 2026-10-13]
site/pavilion/fan_2.stl
460.0 x 317.1 x 1557.0
