alphasafal/saaya-verify/cad/exports/roof_quarter_print_8.stl

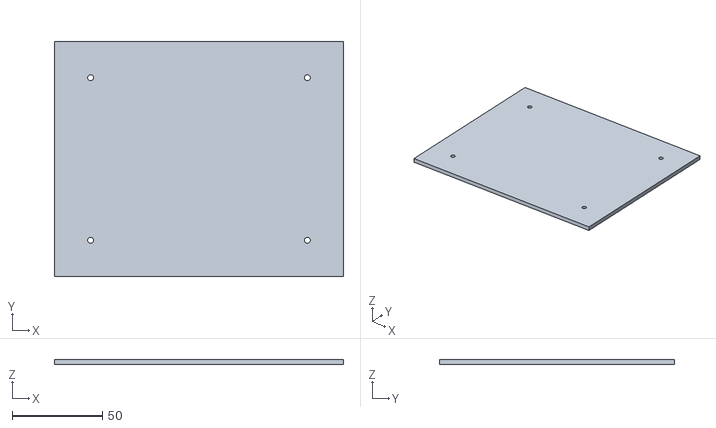
[picture p49: CAD file, 2026-10-11]
cad/exports/roof_quarter_print_8.stl
160.0 x 130.0 x 3.00
