alphasafal/saaya-verify/cad/fullsize/exports/F02_fan_guard.step

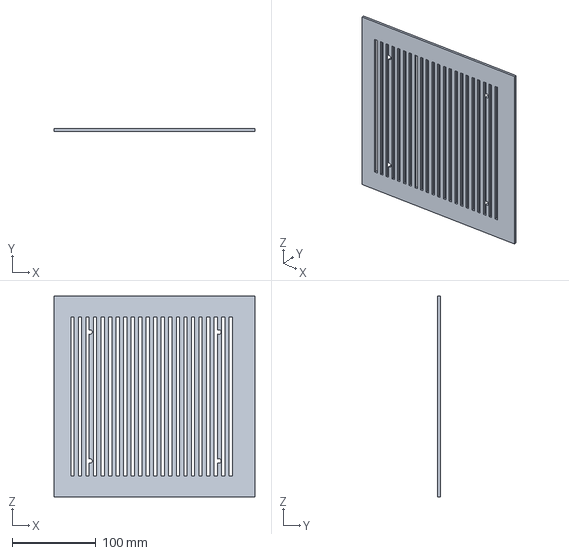
[picture p50: CAD file, 2026-10-12]
cad/fullsize/exports/F02_fan_guard.step
240.0 x 3.00 x 240.0 mm
