alphasafal/saaya-verify/cad/node/exports/back_bracket.stl

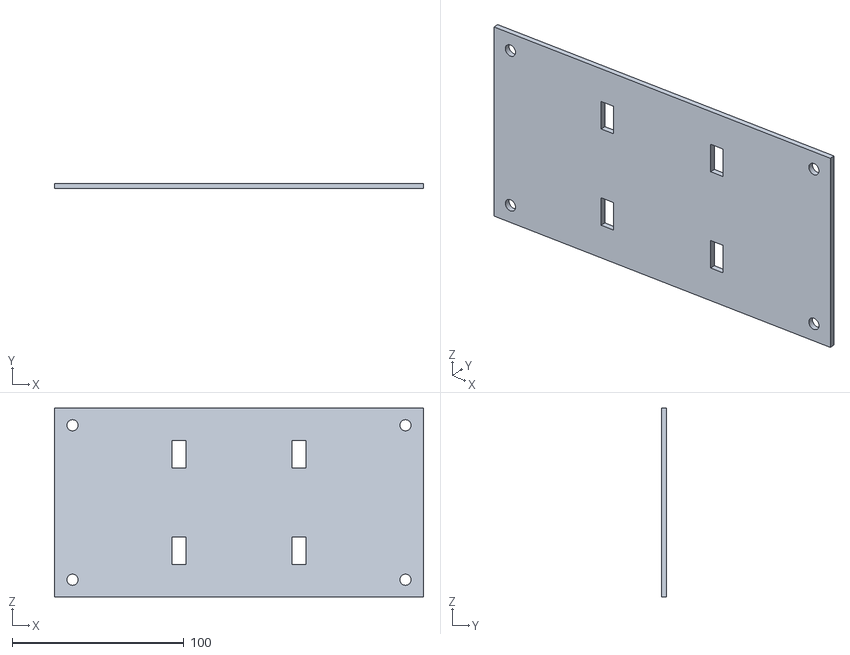
[picture p51: CAD file, 2026-10-20]
cad/node/exports/back_bracket.stl
215.0 x 3.00 x 110.0
