alphasafal/saaya-verify/cad/pavilion/exports/reflective_roof.stl

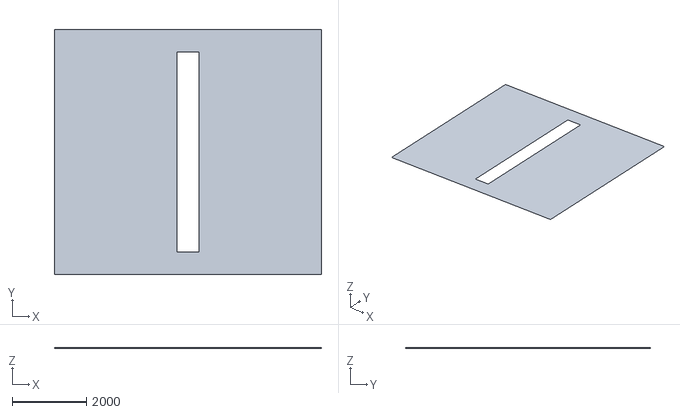
[picture p52: CAD file, 2026-10-13]
cad/pavilion/exports/reflective_roof.stl
7200.0 x 6600.0 x 20.0
