alphasafal/saaya-verify/site/downloads/base_quarter_print_4.stl

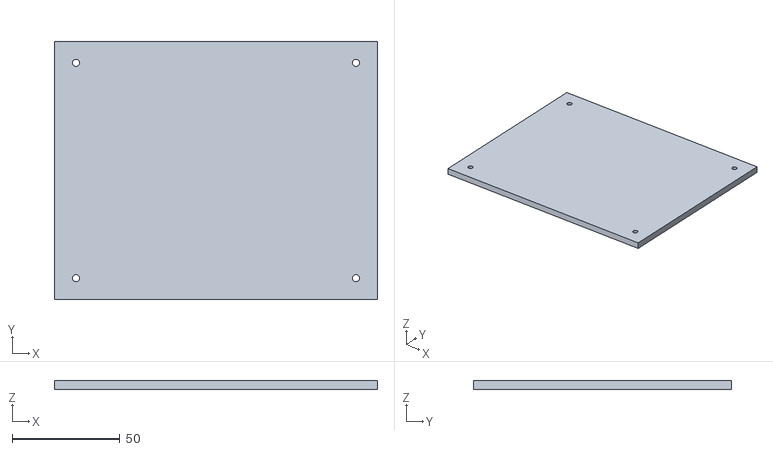
[picture p53: CAD file, 2026-10-11]
site/downloads/base_quarter_print_4.stl
150.0 x 120.0 x 4.00
