alphasafal/saaya-verify/site/fullsize/MT07_sensor_foot.step

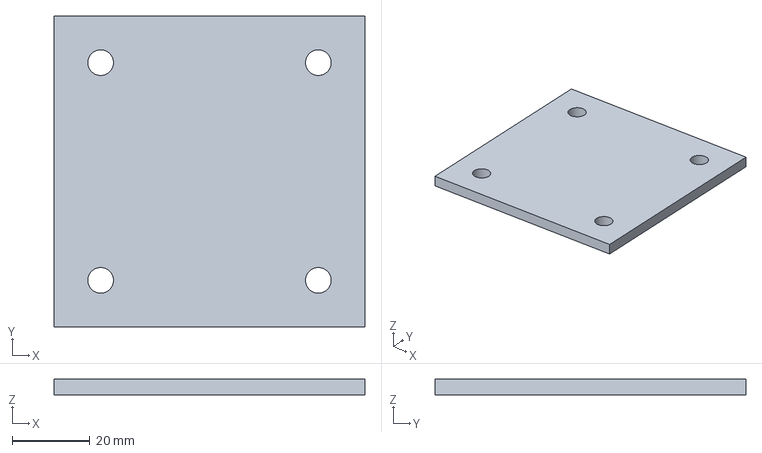
[picture p54: CAD file, 2026-10-12]
site/fullsize/MT07_sensor_foot.step
80.0 x 80.0 x 4.00 mm
