alphasafal/saaya-verify/site/node/mounting_plate.stl

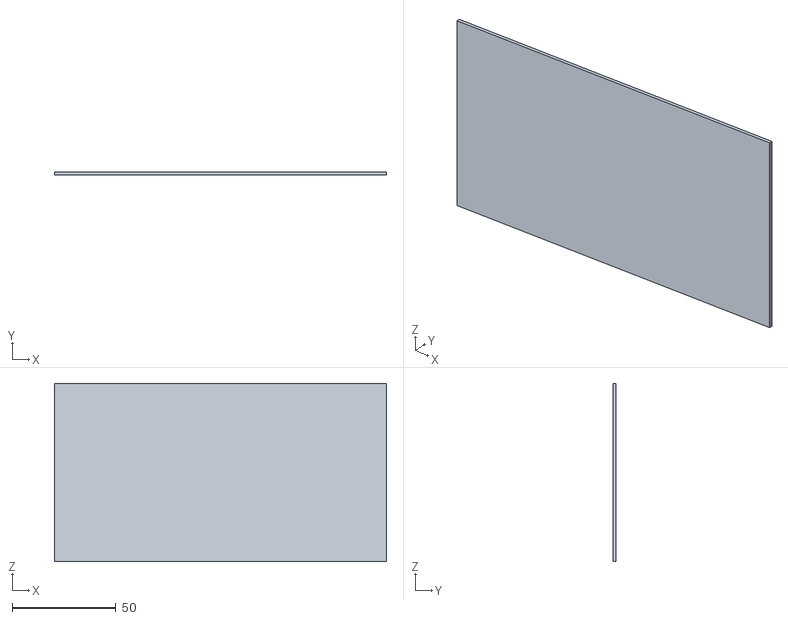
[picture p55: CAD file, 2026-10-20]
site/node/mounting_plate.stl
160.0 x 1.50 x 86.0
