alphasafal/saaya-verify/site/pavilion/east_screen.stl

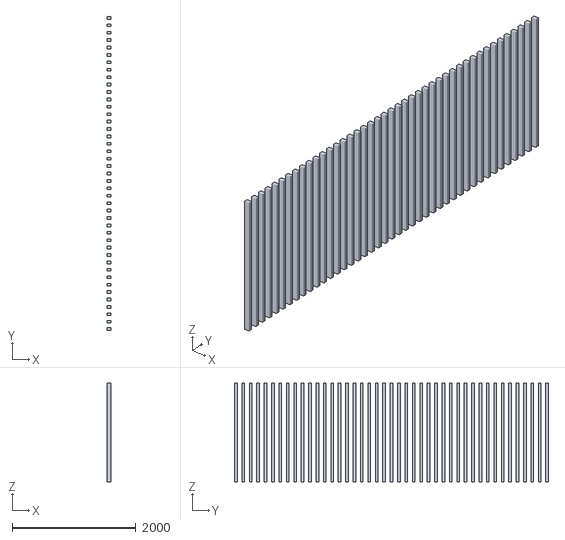
[picture p56: CAD file, 2026-10-13]
site/pavilion/east_screen.stl
60.0 x 5085.0 x 1600.0
