alphasafal/saaya-verify/cad/exports/fan_guard_40mm.stl

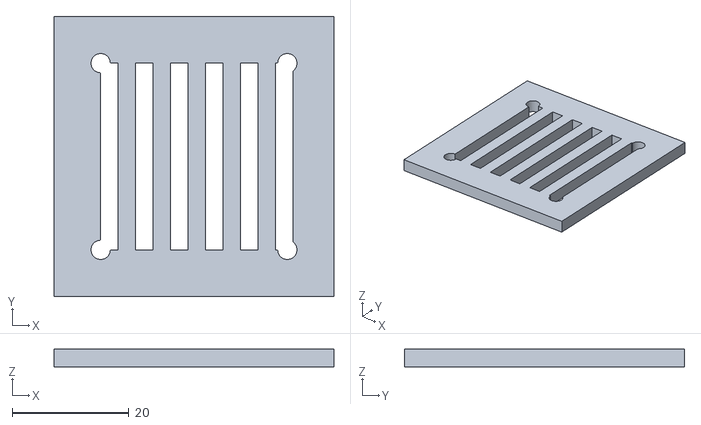
[picture p57: CAD file, 2026-10-11]
cad/exports/fan_guard_40mm.stl
48.0 x 48.0 x 3.00
