alphasafal/saaya-verify/cad/node/exports/enclosure_lid.stl

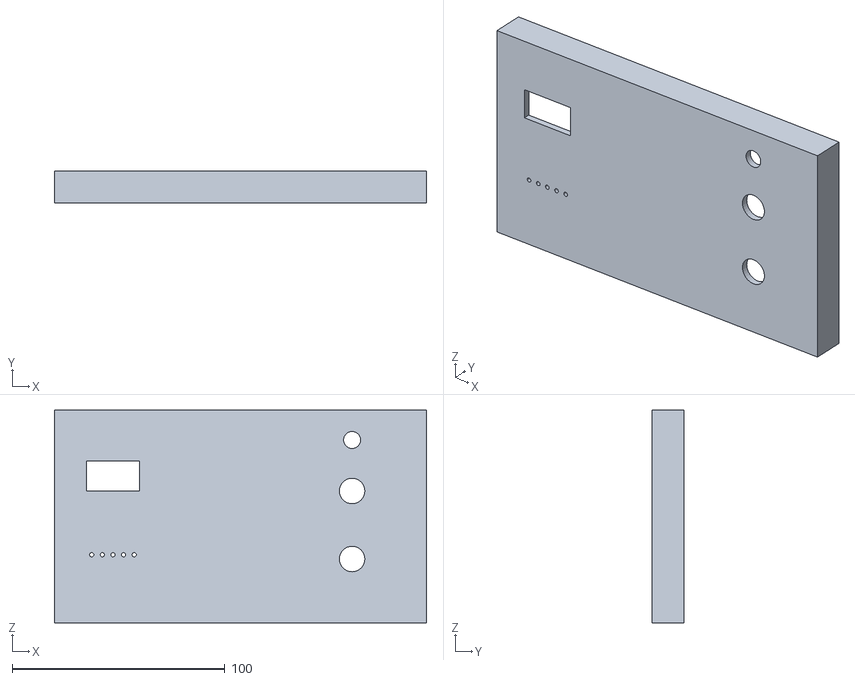
[picture p58: CAD file, 2026-10-20]
cad/node/exports/enclosure_lid.stl
175.0 x 15.0 x 100.0
