alphasafal/saaya-verify/site/downloads/jaali_coupon_pitch_12.stl

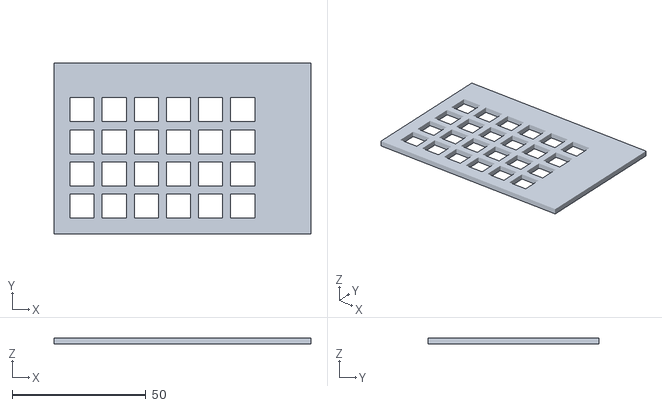
[picture p59: CAD file, 2026-10-11]
site/downloads/jaali_coupon_pitch_12.stl
96.0 x 64.0 x 2.40
