alphasafal/saaya-verify/site/fullsize/MT04_enclosure_return.step

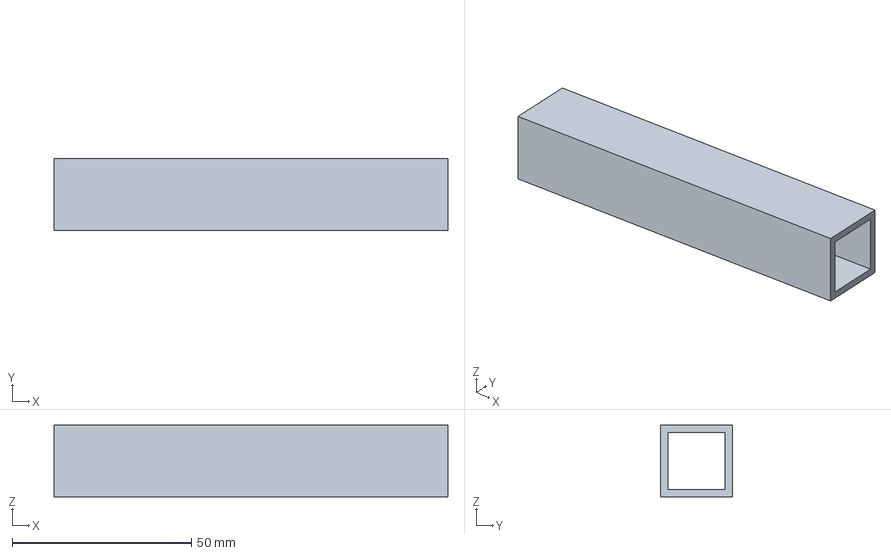
[picture p60: CAD file, 2026-10-12]
site/fullsize/MT04_enclosure_return.step
110.0 x 20.0 x 20.0 mm
