alphasafal/saaya-verify/site/pavilion/control_4.stl

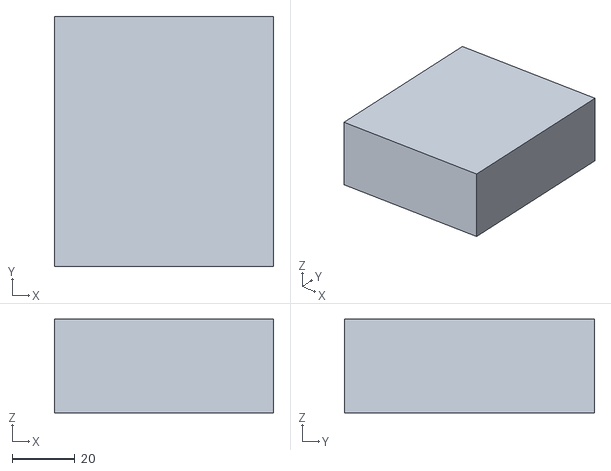
[picture p61: CAD file, 2026-10-13]
site/pavilion/control_4.stl
70.0 x 80.0 x 30.0
