alphasafal/saaya-verify/cad/exports/universal_board_carrier.stl

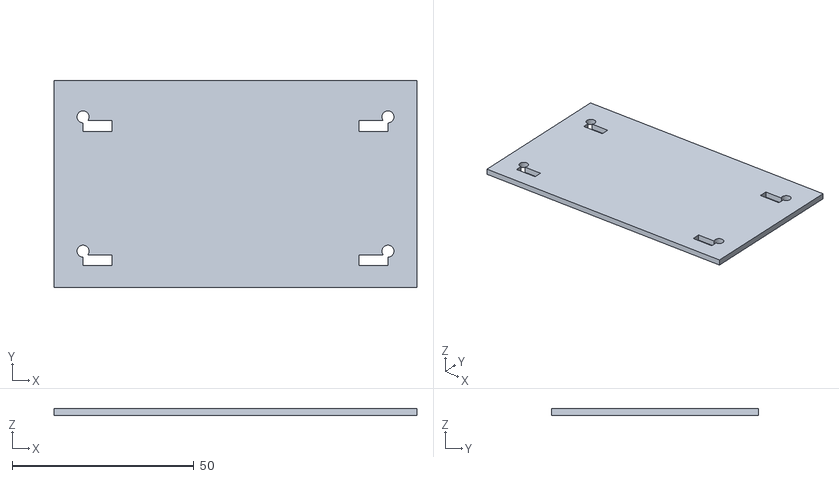
[picture p62: CAD file, 2026-10-11]
cad/exports/universal_board_carrier.stl
100.0 x 57.0 x 2.00
