alphasafal/saaya-verify/cad/fullsize/exports/C01_cable_trunk.step

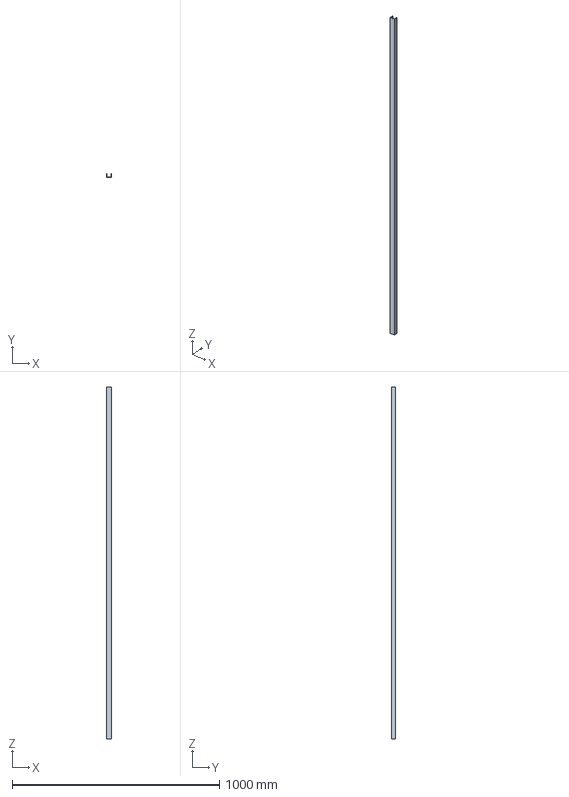
[picture p63: CAD file, 2026-10-12]
cad/fullsize/exports/C01_cable_trunk.step
25.0 x 18.0 x 1700.0 mm
