alphasafal/saaya-verify/cad/node/exports/fuse.stl

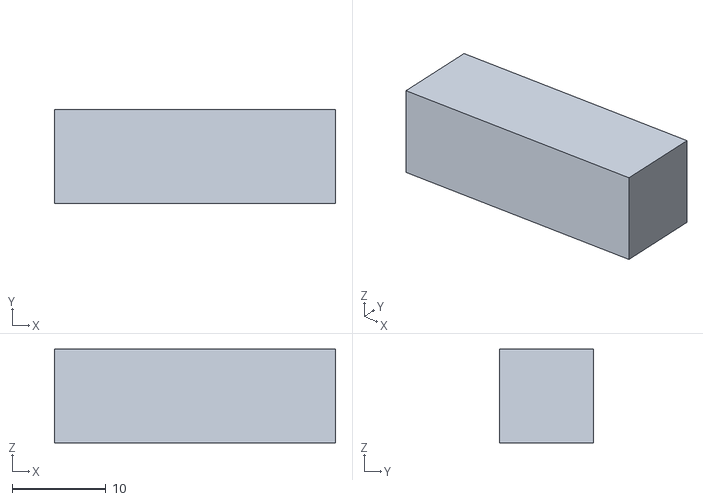
[picture p64: CAD file, 2026-10-20]
cad/node/exports/fuse.stl
30.0 x 10.0 x 10.0
