alphasafal/saaya-verify/cad/pavilion/exports/reference_station.stl

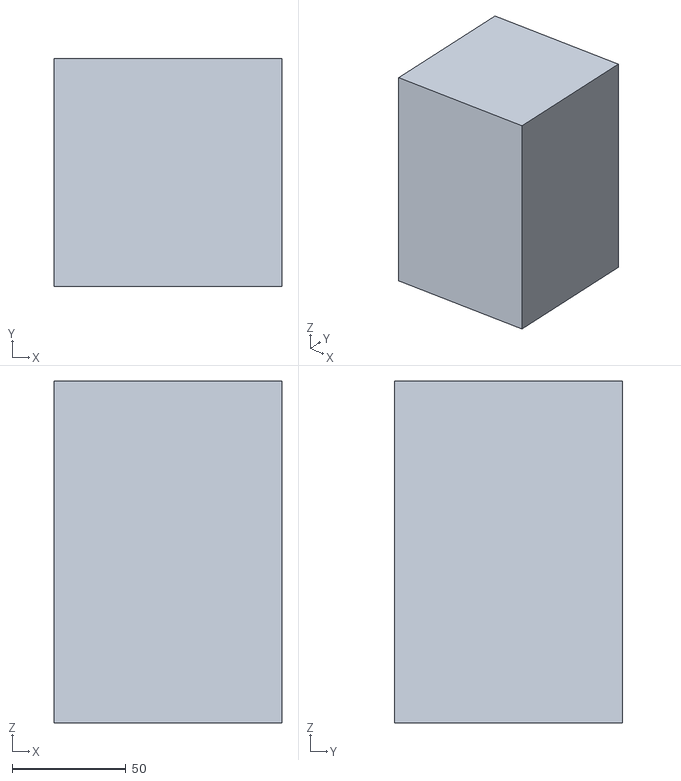
[picture p65: CAD file, 2026-10-13]
cad/pavilion/exports/reference_station.stl
100.0 x 100.0 x 150.0
