alphasafal/saaya-verify/site/downloads/enclosure_lid.stl

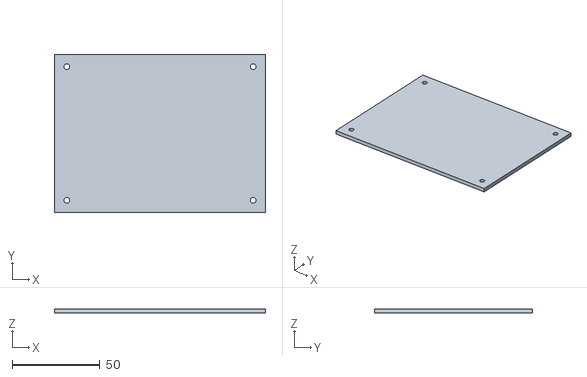
[picture p66: CAD file, 2026-10-11]
site/downloads/enclosure_lid.stl
120.0 x 90.0 x 2.50
