alphasafal/saaya-verify/site/fullsize/MT05_seated_sensor_stem.step

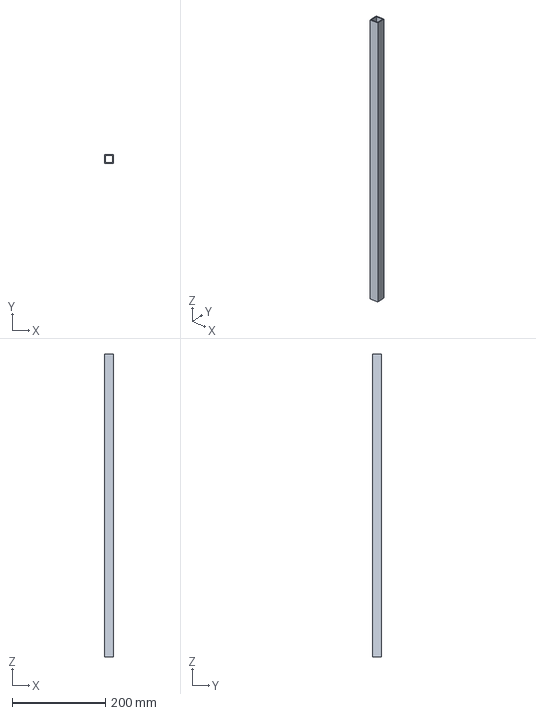
[picture p67: CAD file, 2026-10-12]
site/fullsize/MT05_seated_sensor_stem.step
20.0 x 20.0 x 650.0 mm
