alphasafal/saaya-verify/site/node/fan_120.stl

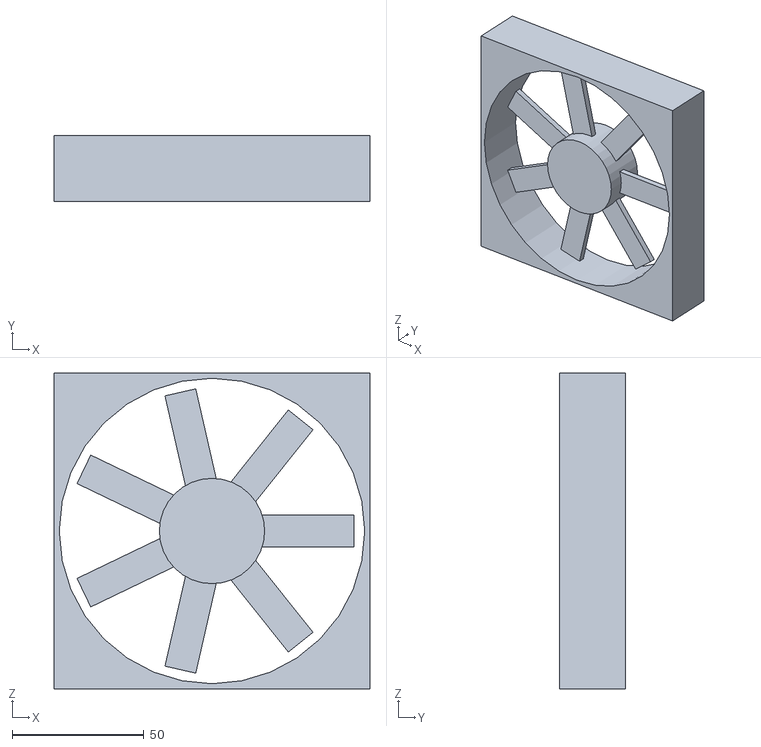
[picture p68: CAD file, 2026-10-20]
site/node/fan_120.stl
120.0 x 25.0 x 120.0
