alphasafal/saaya-verify/site/pavilion/cot_3.stl

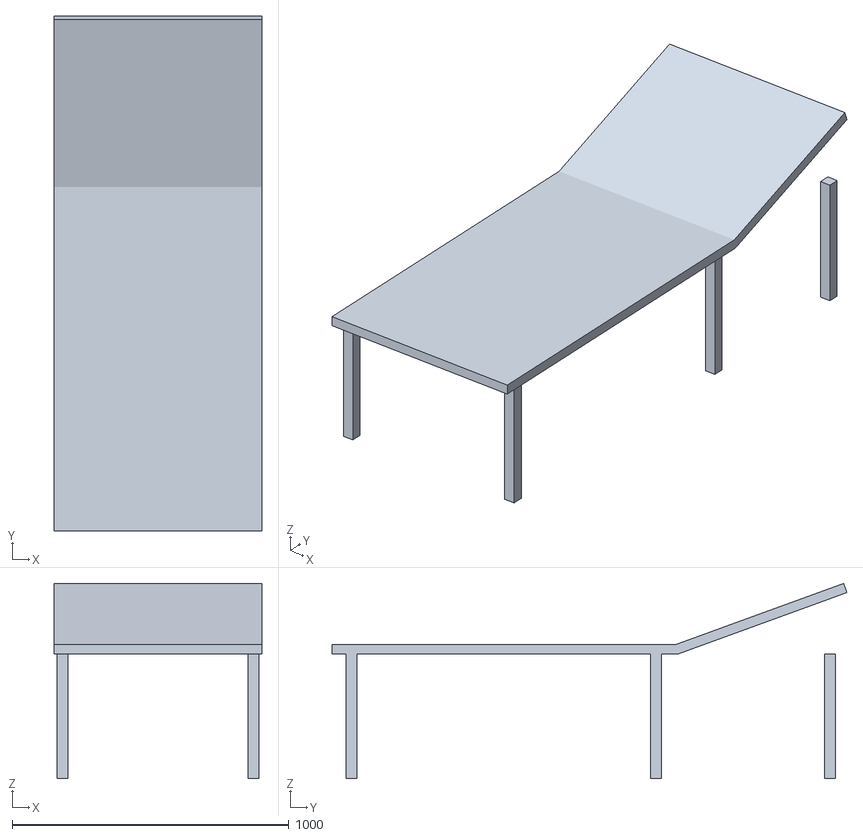
[picture p69: CAD file, 2026-10-13]
site/pavilion/cot_3.stl
750.0 x 1860.8 x 705.2
