alphasafal/saaya-verify/cad/exports/roof_spacer_print_4.stl

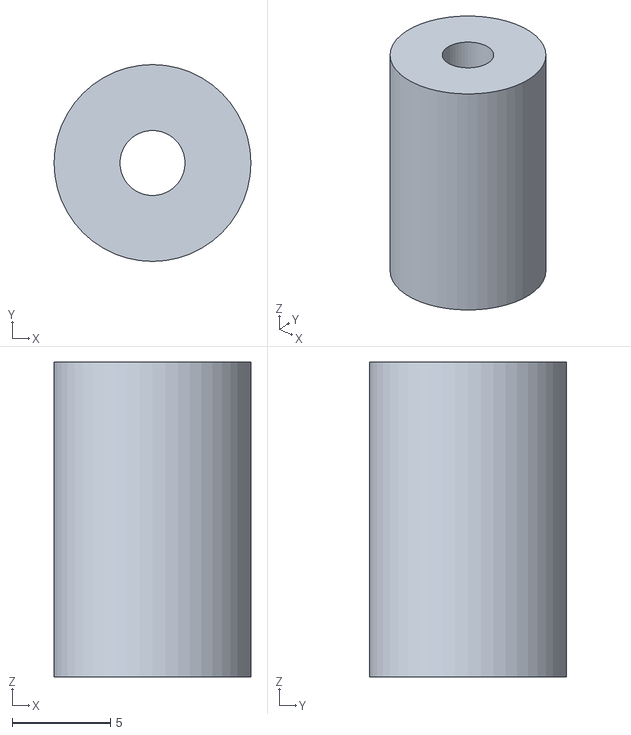
[picture p70: CAD file, 2026-10-11]
cad/exports/roof_spacer_print_4.stl
10.0 x 10.0 x 16.0
