alphasafal/saaya-verify/cad/pavilion/exports/frame.stl

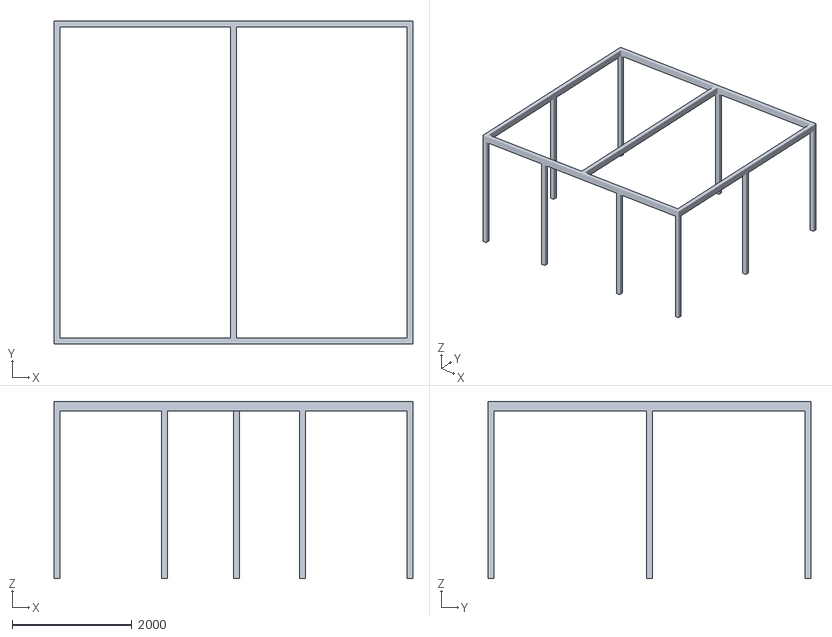
[picture p71: CAD file, 2026-10-13]
cad/pavilion/exports/frame.stl
6000.0 x 5400.0 x 2960.0
