alphasafal/saaya-verify/cad/fullsize/exports/JA01_louvre.step

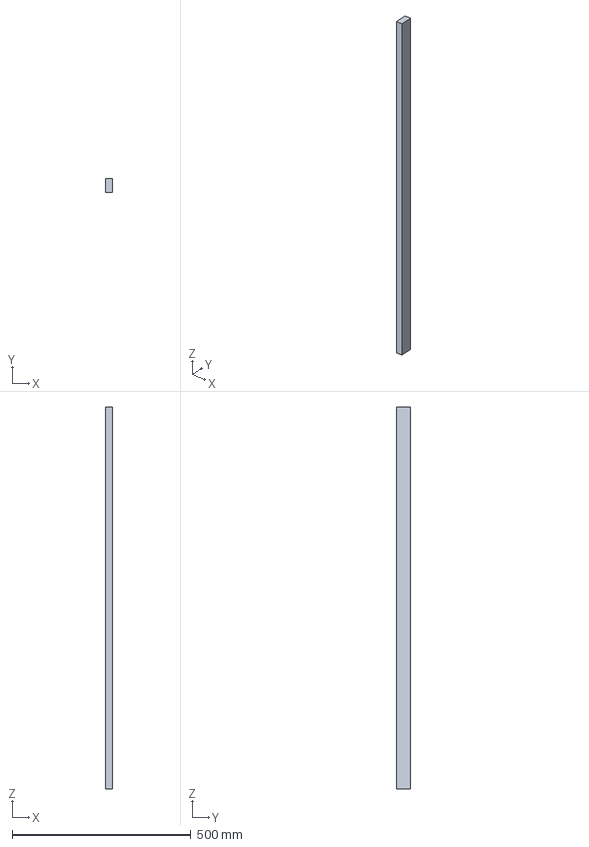
[picture p72: CAD file, 2026-10-12]
cad/fullsize/exports/JA01_louvre.step
20.0 x 40.0 x 1070.0 mm
