alphasafal/saaya-verify/cad/node/exports/esp32_shield_can.stl

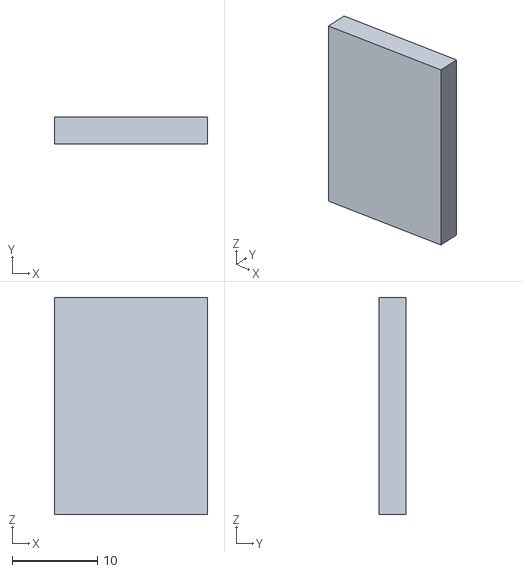
[picture p73: CAD file, 2026-10-20]
cad/node/exports/esp32_shield_can.stl
18.0 x 3.20 x 25.5
