alphasafal/saaya-verify/site/fullsize/F01_fan_cartridge.step

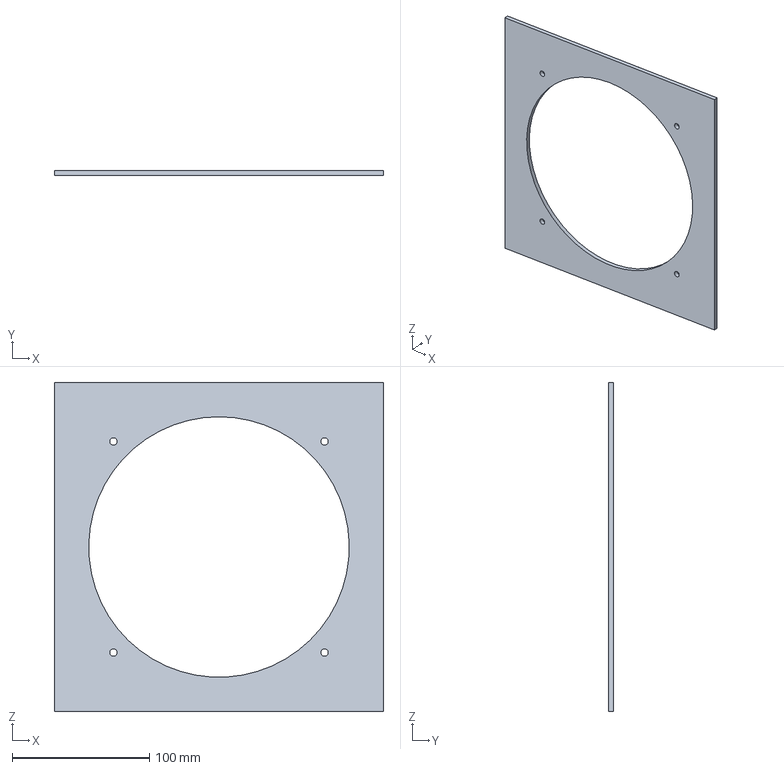
[picture p74: CAD file, 2026-10-12]
site/fullsize/F01_fan_cartridge.step
240.0 x 4.00 x 240.0 mm
