alphasafal/saaya-verify/site/node/SAAYA_NODE_v1.step

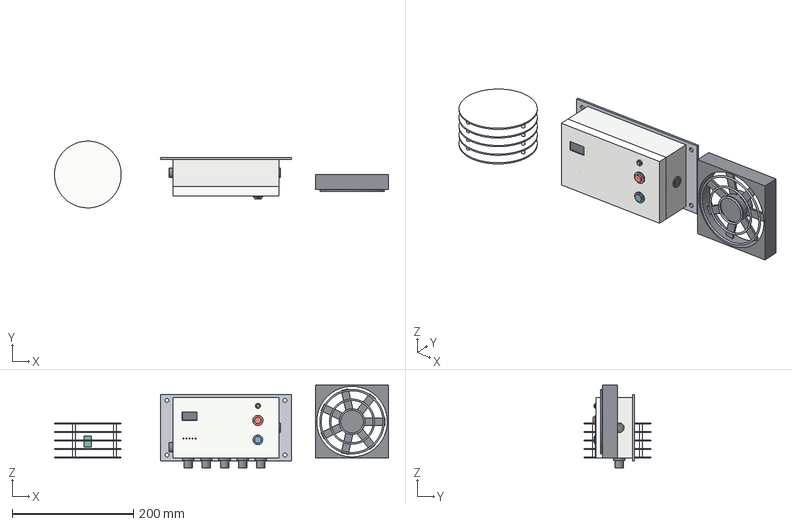
[picture p75: CAD file, 2026-10-20]
site/node/SAAYA_NODE_v1.step
549.9 x 109.9 x 136.0 mm
enclosure_body
enclosure_lid
status_led
oled_glass
help_button
mode_button
ack_button
glands_and_vent
mounting_plate
main_board
esp32_devkitc
esp32_shield_can
ina219
buck
fuse
oled_module
buzzer
terminal_blocks
back_bracket
radiation_shield
sht31_in_shield
fan_120
fan_guard
