alphasafal/saaya-verify/cad/exports/oled_bezel_measure_module_first.stl

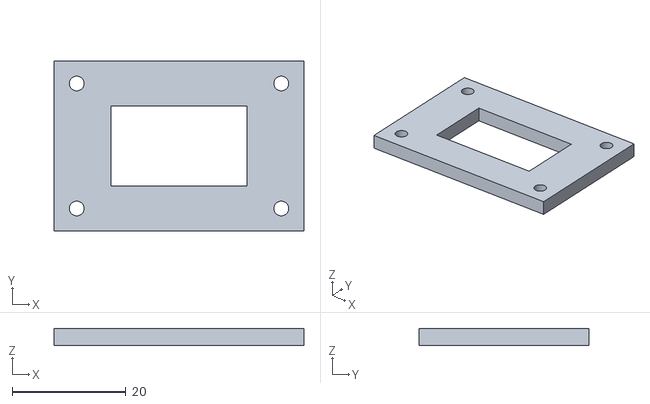
[picture p76: CAD file, 2026-10-11]
cad/exports/oled_bezel_measure_module_first.stl
44.0 x 30.0 x 3.00
