alphasafal/saaya-verify/cad/fullsize/exports/P02_rear_post.step

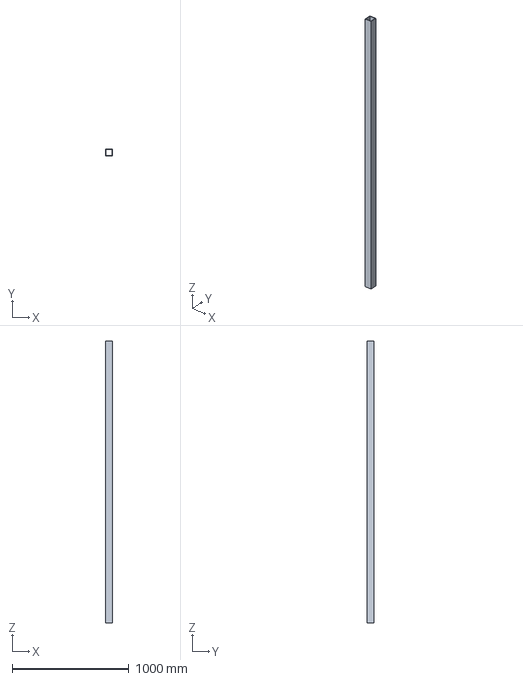
[picture p77: CAD file, 2026-10-12]
cad/fullsize/exports/P02_rear_post.step
60.0 x 60.0 x 2420.0 mm
