alphasafal/saaya-verify/cad/node/exports/mode_button.stl

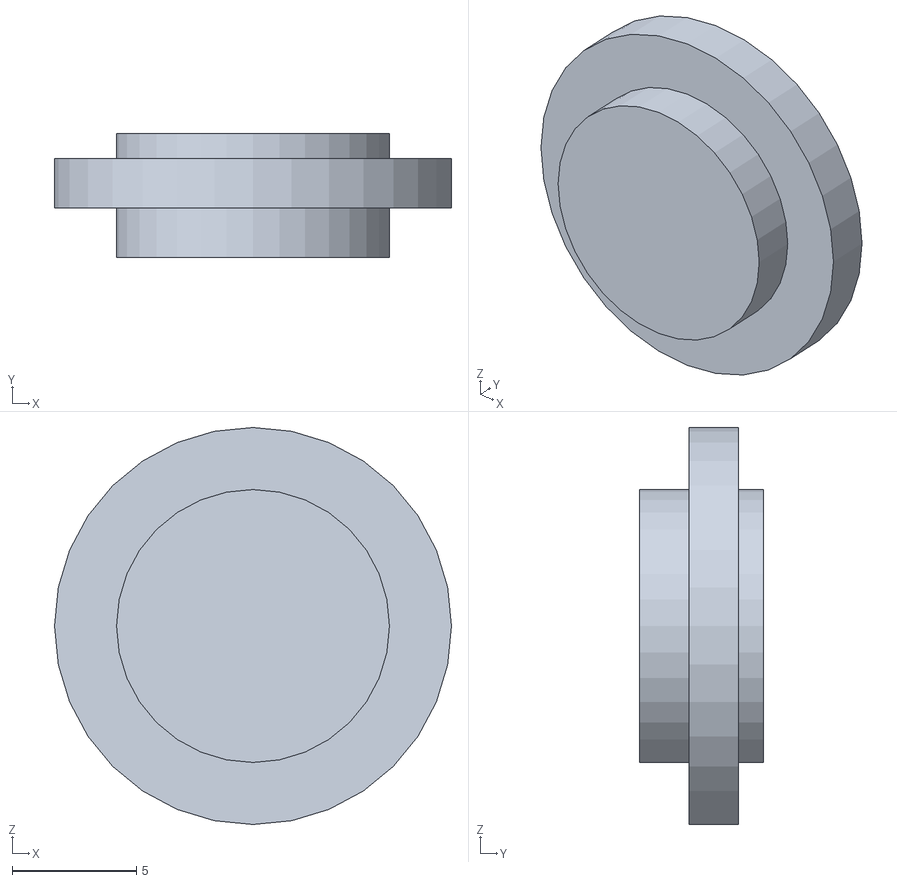
[picture p78: CAD file, 2026-10-20]
cad/node/exports/mode_button.stl
16.0 x 5.00 x 16.0
