alphasafal/saaya-verify/site/fullsize/E05_monitor_reference.step

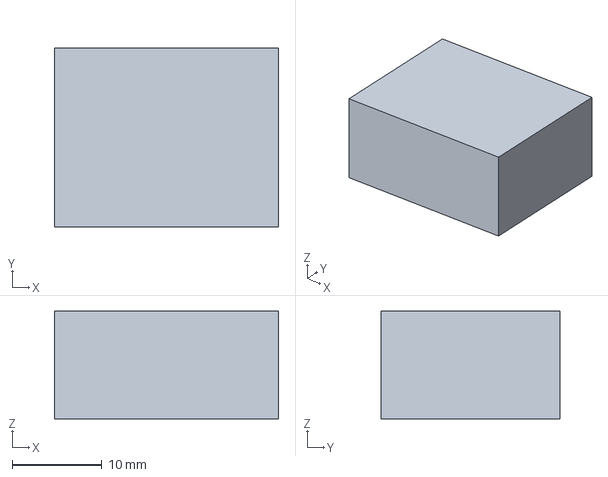
[picture p79: CAD file, 2026-10-12]
site/fullsize/E05_monitor_reference.step
25.0 x 20.0 x 12.0 mm
