alphasafal/saaya-verify/cad/exports/pillar_print_4.stl

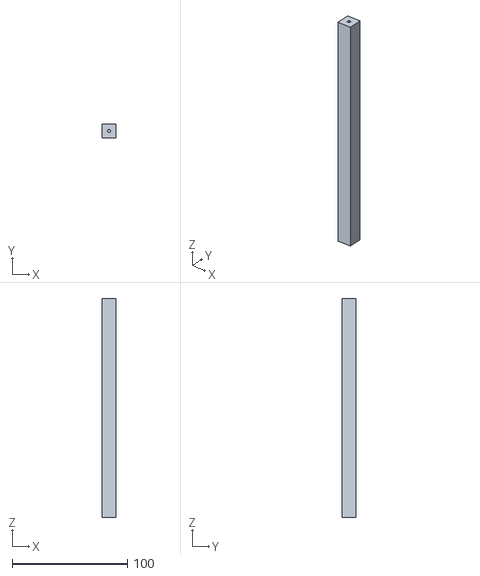
[picture p80: CAD file, 2026-10-11]
cad/exports/pillar_print_4.stl
12.0 x 12.0 x 190.0
