alphasafal/saaya-verify/cad/fullsize/exports/G01_knee_gusset.step

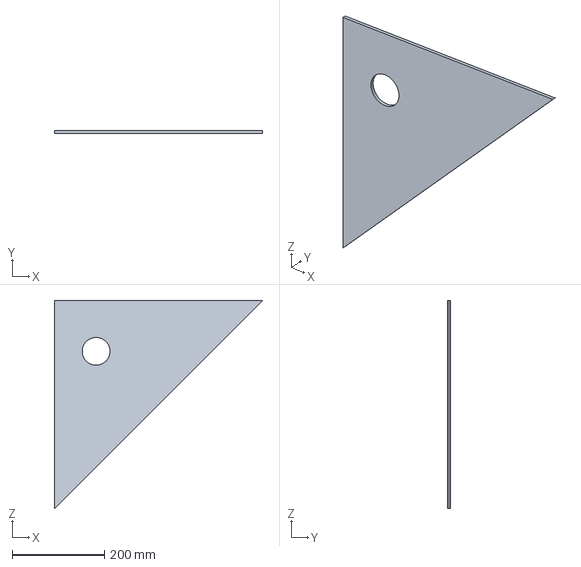
[picture p81: CAD file, 2026-10-12]
cad/fullsize/exports/G01_knee_gusset.step
450.0 x 6.00 x 450.0 mm
