alphasafal/saaya-verify/cad/node/exports/status_led.stl

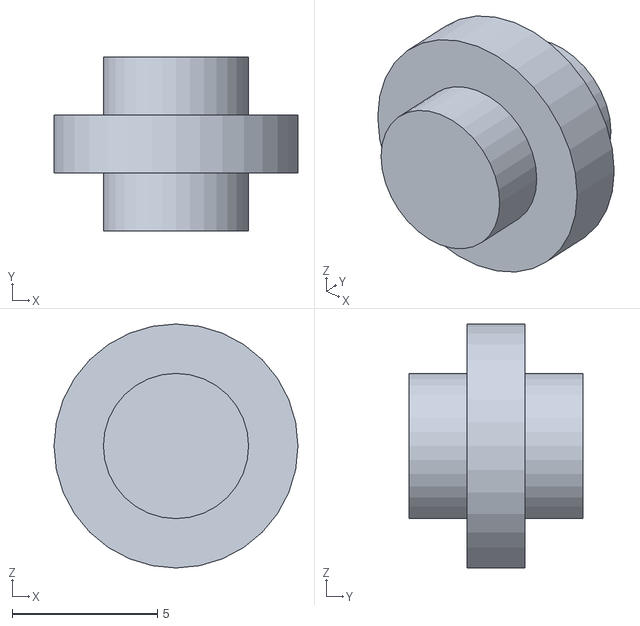
[picture p82: CAD file, 2026-10-20]
cad/node/exports/status_led.stl
8.40 x 6.00 x 8.40
