alphasafal/saaya-verify/site/downloads/sensor_shield_cage.stl

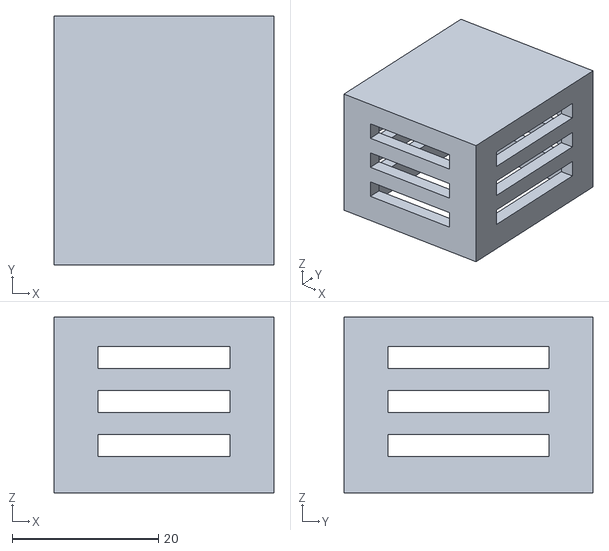
[picture p83: CAD file, 2026-10-11]
site/downloads/sensor_shield_cage.stl
30.0 x 34.0 x 24.0
