alphasafal/saaya-verify/site/fullsize/HW02_M16_anchor_reference.step

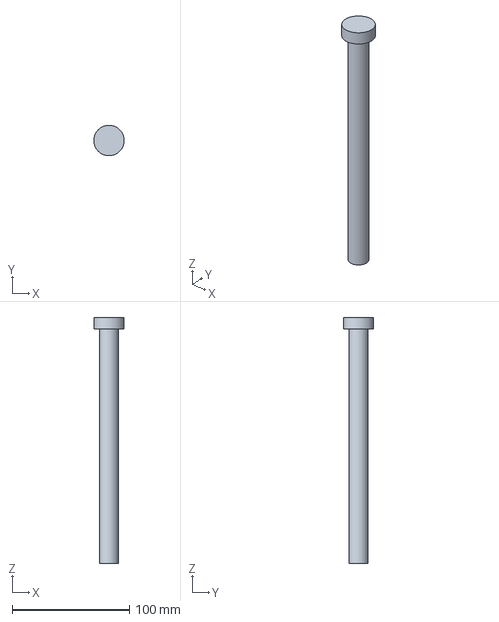
[picture p84: CAD file, 2026-10-12]
site/fullsize/HW02_M16_anchor_reference.step
26.0 x 26.0 x 210.0 mm
