alphasafal/saaya-verify/cad/fullsize/exports/E01_dry_enclosure.step

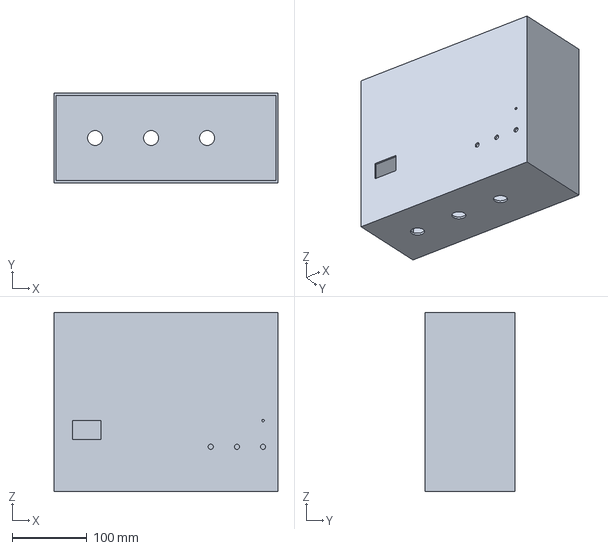
[picture p85: CAD file, 2026-10-12]
cad/fullsize/exports/E01_dry_enclosure.step
300.0 x 120.0 x 240.0 mm
