alphasafal/saaya-verify/site/fullsize/W01_optional_water_vessel.step

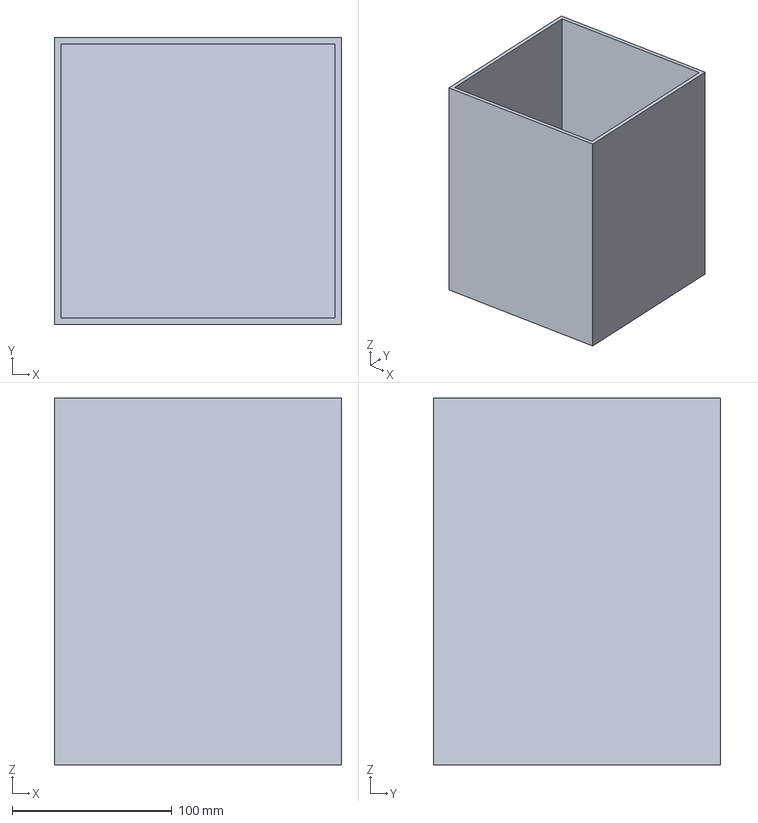
[picture p86: CAD file, 2026-10-12]
site/fullsize/W01_optional_water_vessel.step
180.0 x 180.0 x 230.0 mm
