alphasafal/saaya-verify/site/pavilion/service_cabinet.stl

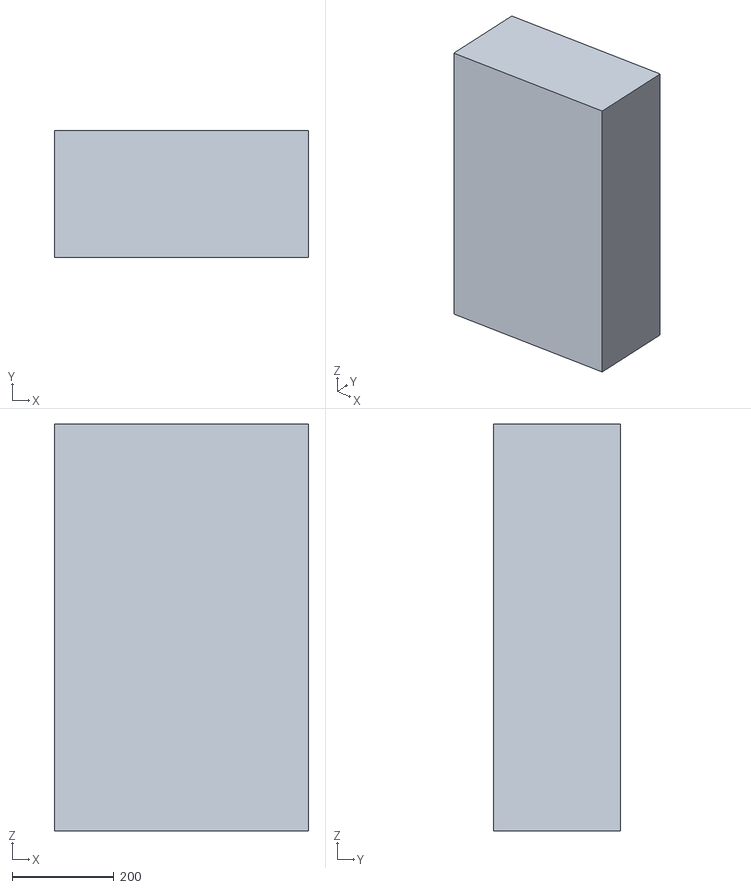
[picture p87: CAD file, 2026-10-13]
site/pavilion/service_cabinet.stl
500.0 x 250.0 x 800.0
