alphasafal/saaya-verify/cad/exports/join_plate_drill_to_fit.stl

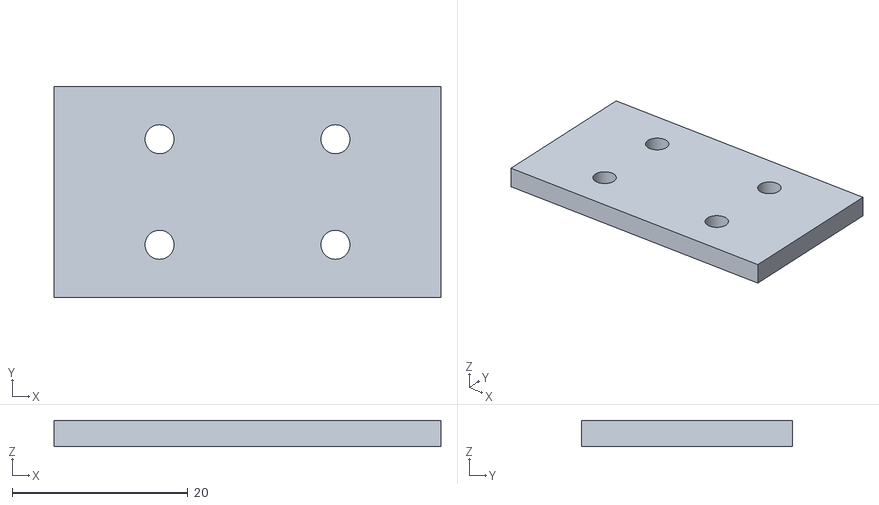
[picture p88: CAD file, 2026-10-11]
cad/exports/join_plate_drill_to_fit.stl
44.0 x 24.0 x 3.00
