alphasafal/saaya-verify/cad/fullsize/exports/ST02_bench_rail.step

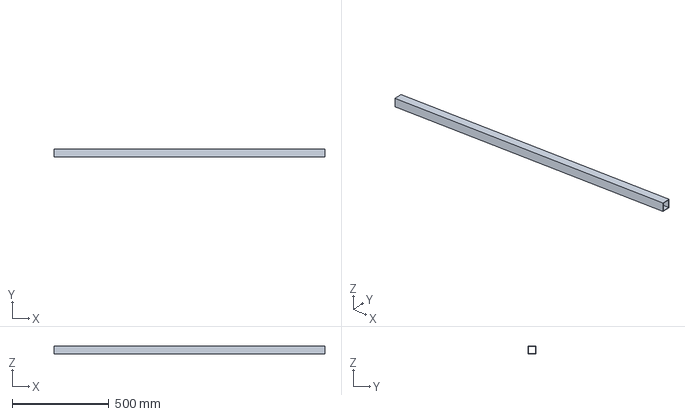
[picture p89: CAD file, 2026-10-12]
cad/fullsize/exports/ST02_bench_rail.step
1400.0 x 40.0 x 40.0 mm
