alphasafal/saaya-verify/site/fullsize/E04_ESP32_reference.step

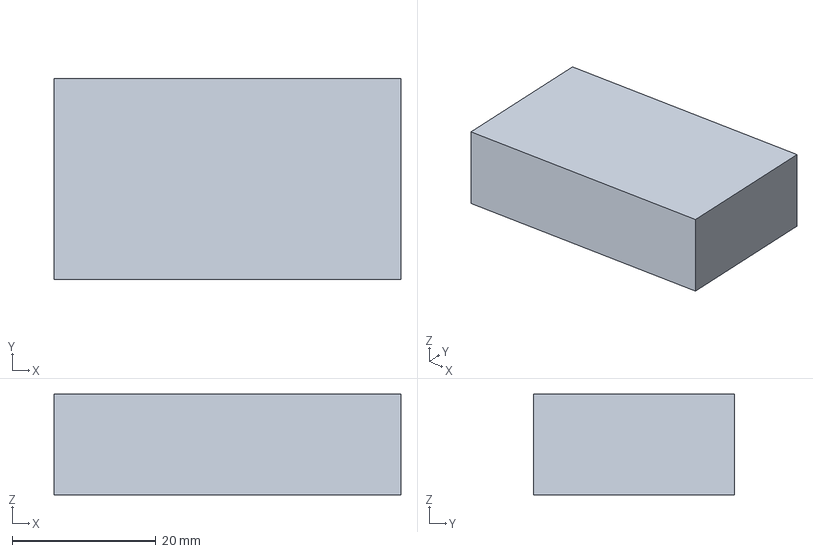
[picture p90: CAD file, 2026-10-12]
site/fullsize/E04_ESP32_reference.step
48.3 x 27.9 x 14.0 mm
