alphasafal/saaya-verify/site/node/ina219.stl

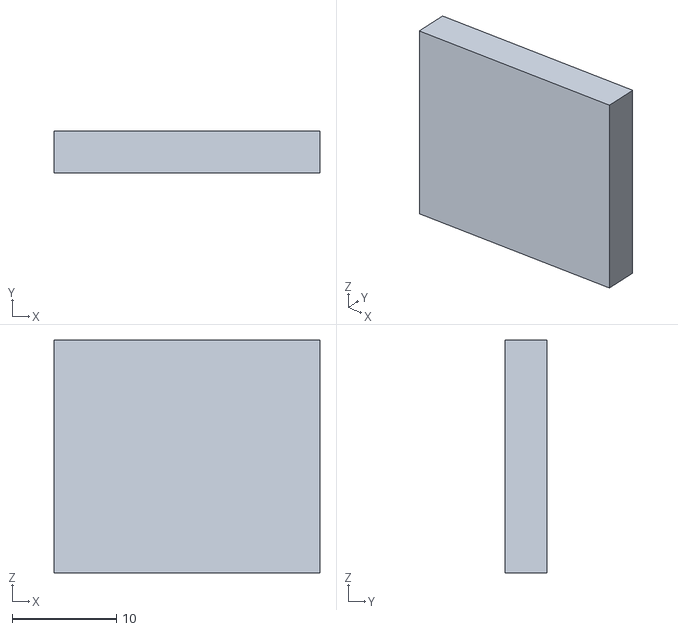
[picture p91: CAD file, 2026-10-20]
site/node/ina219.stl
25.5 x 4.00 x 22.3
