alphasafal/saaya-verify/cad/node/exports/glands_and_vent.stl

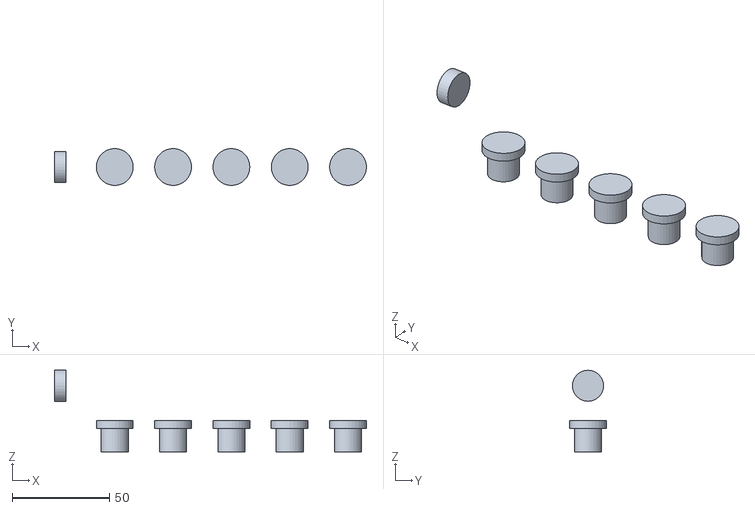
[picture p92: CAD file, 2026-10-20]
cad/node/exports/glands_and_vent.stl
160.5 x 19.0 x 42.0
