alphasafal/saaya-verify/site/fullsize/ST03_seat_slat.step

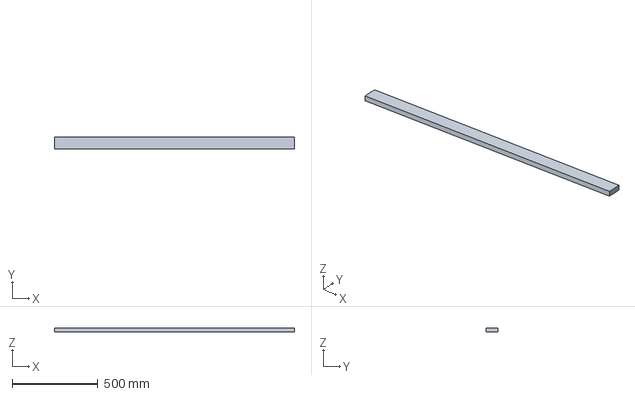
[picture p93: CAD file, 2026-10-12]
site/fullsize/ST03_seat_slat.step
1400.0 x 70.0 x 25.0 mm
