alphasafal/saaya-verify/cad/exports/fan_guard_spacer.stl

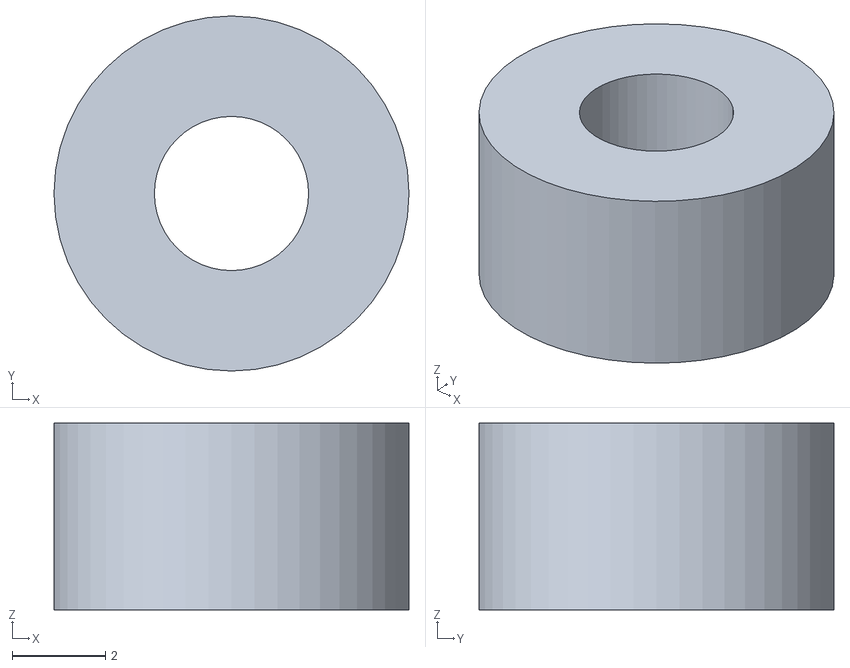
[picture p94: CAD file, 2026-10-11]
cad/exports/fan_guard_spacer.stl
7.60 x 7.60 x 4.00
