alphasafal/saaya-verify/cad/node/exports/terminal_blocks.stl

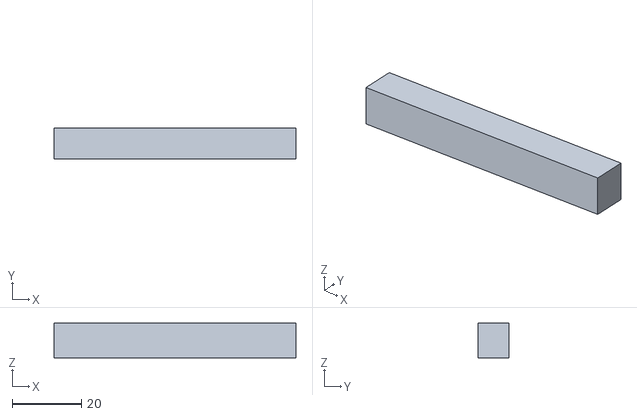
[picture p95: CAD file, 2026-10-20]
cad/node/exports/terminal_blocks.stl
70.0 x 9.00 x 10.0
