alphasafal/saaya-verify/site/fullsize/W02_float_reference.step

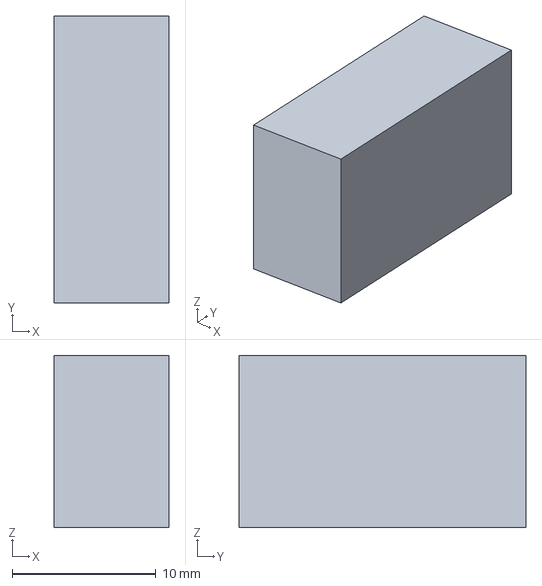
[picture p96: CAD file, 2026-10-12]
site/fullsize/W02_float_reference.step
8.00 x 20.0 x 12.0 mm
