alphasafal/saaya-verify/site/pavilion/ridge_cap.stl

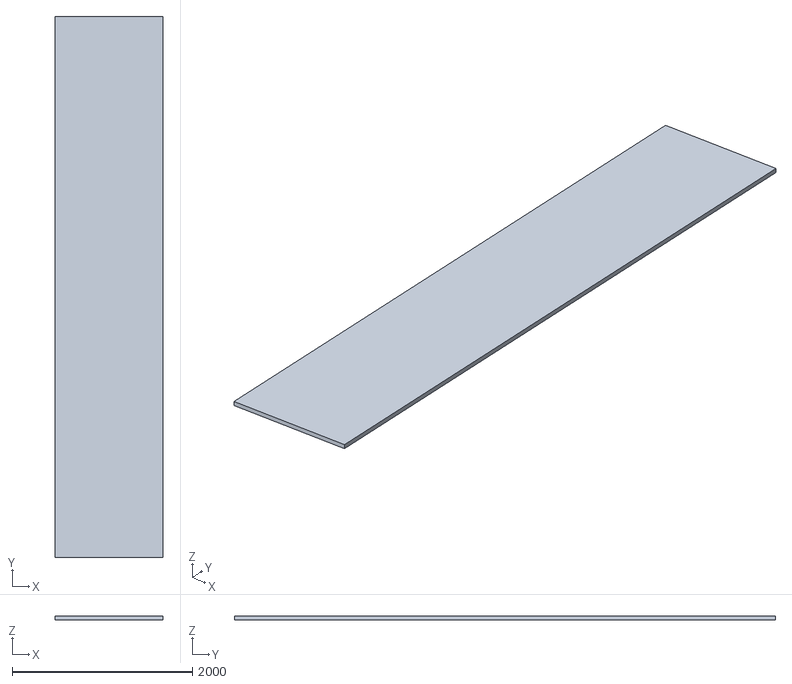
[picture p97: CAD file, 2026-10-13]
site/pavilion/ridge_cap.stl
1200.0 x 6000.0 x 40.0
