alphasafal/saaya-verify/site/node/help_button.stl

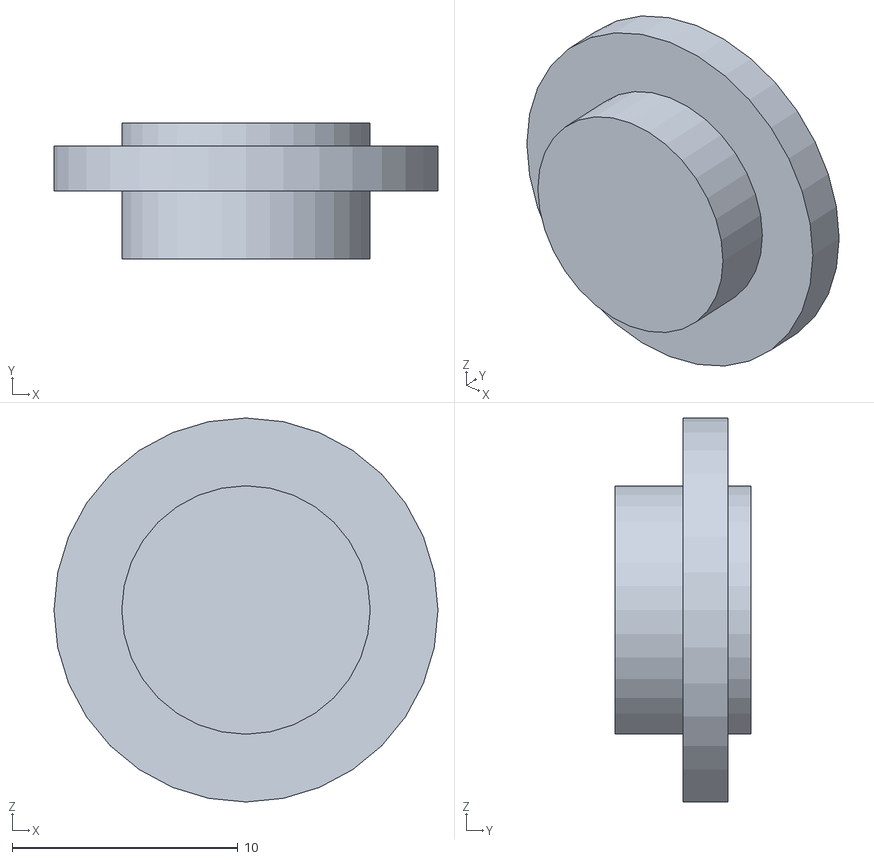
[picture p98: CAD file, 2026-10-20]
site/node/help_button.stl
17.0 x 6.00 x 17.0
