alphasafal/saaya-verify/site/pavilion/wbgt_station.stl

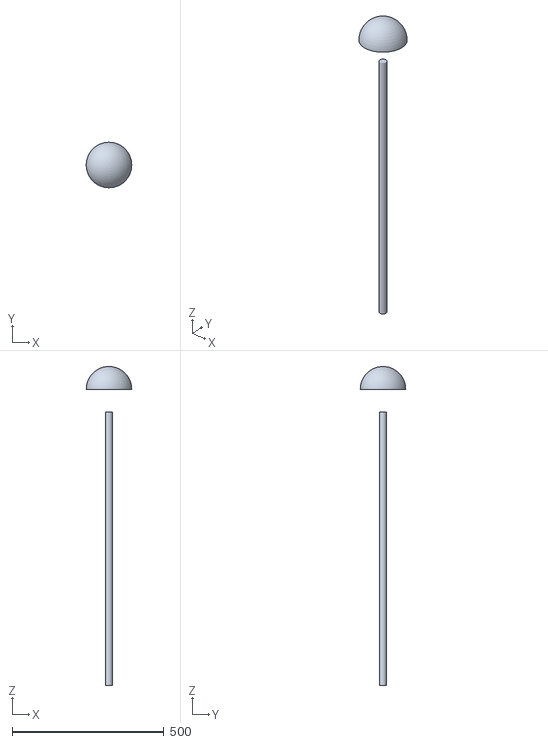
[picture p99: CAD file, 2026-10-13]
site/pavilion/wbgt_station.stl
149.9 x 150.0 x 1050.0
