alphasafal/saaya-verify/cad/fullsize/exports/MT01_rear_service_rail.step

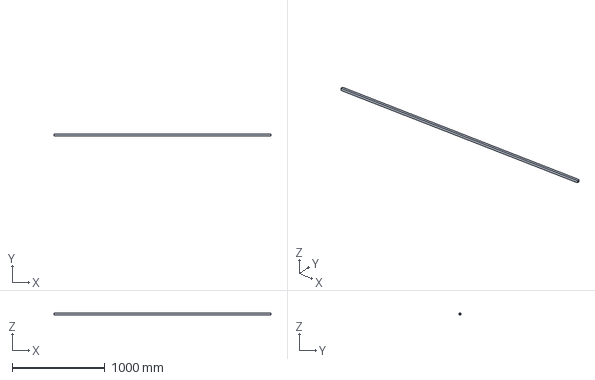
[picture p100: CAD file, 2026-10-12]
cad/fullsize/exports/MT01_rear_service_rail.step
2340.0 x 20.0 x 20.0 mm
