alphasafal/saaya-verify/site/fullsize/BP01_base_plate.step

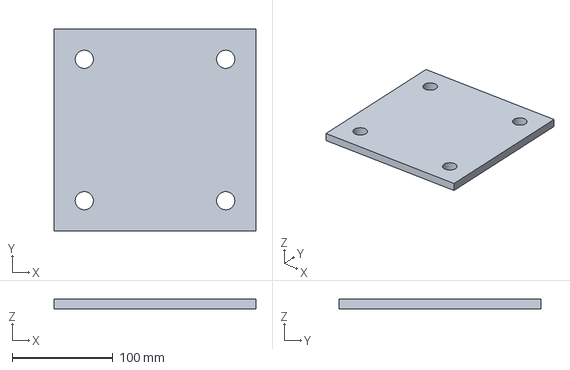
[picture p101: CAD file, 2026-10-12]
site/fullsize/BP01_base_plate.step
200.0 x 200.0 x 10.0 mm
