alphasafal/saaya-verify/site/fullsize/CP02_spacer_cap.step

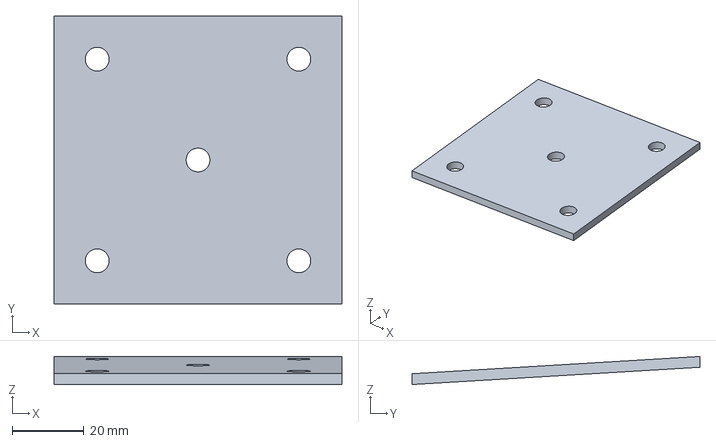
[picture p102: CAD file, 2026-10-12]
site/fullsize/CP02_spacer_cap.step
80.0 x 80.0 x 7.80 mm
