alphasafal/saaya-verify/cad/fullsize/exports/R01_roof_purlin.step

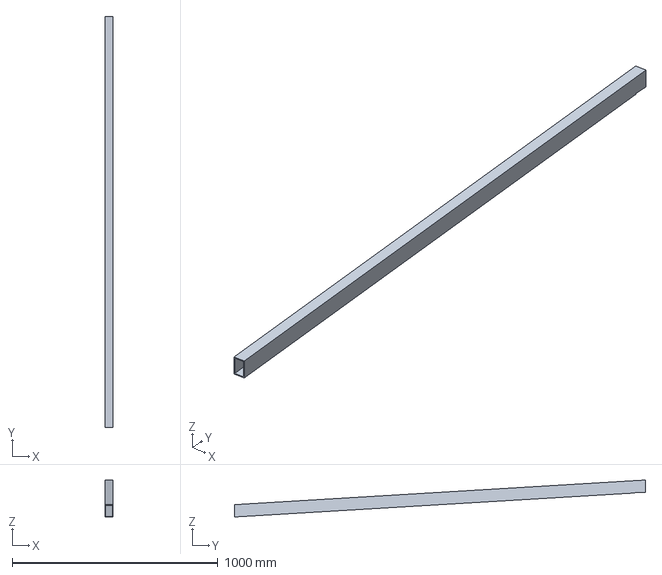
[picture p103: CAD file, 2026-10-12]
cad/fullsize/exports/R01_roof_purlin.step
40.0 x 2000.0 x 180.0 mm
