alphasafal/saaya-verify/cad/fullsize/exports/E03_component_carrier.step

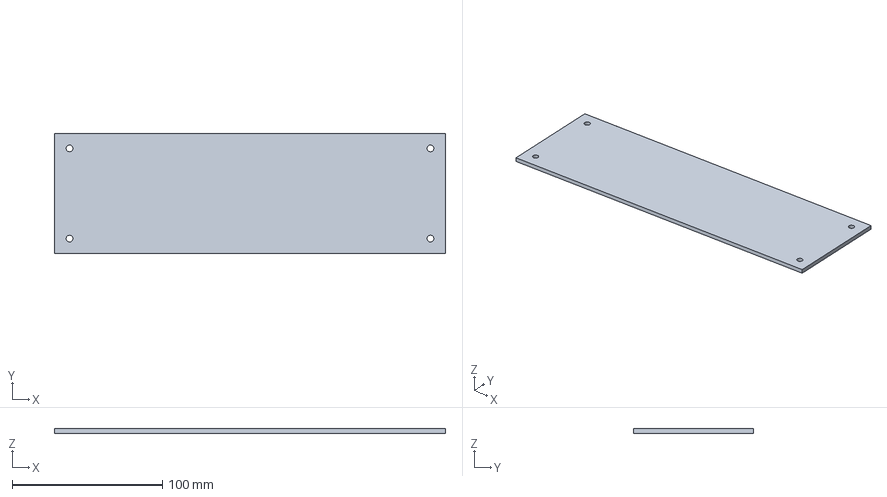
[picture p104: CAD file, 2026-10-12]
cad/fullsize/exports/E03_component_carrier.step
260.0 x 80.0 x 3.00 mm
