alphasafal/saaya-verify/cad/pavilion/exports/SAAYA_FS02_concept.step

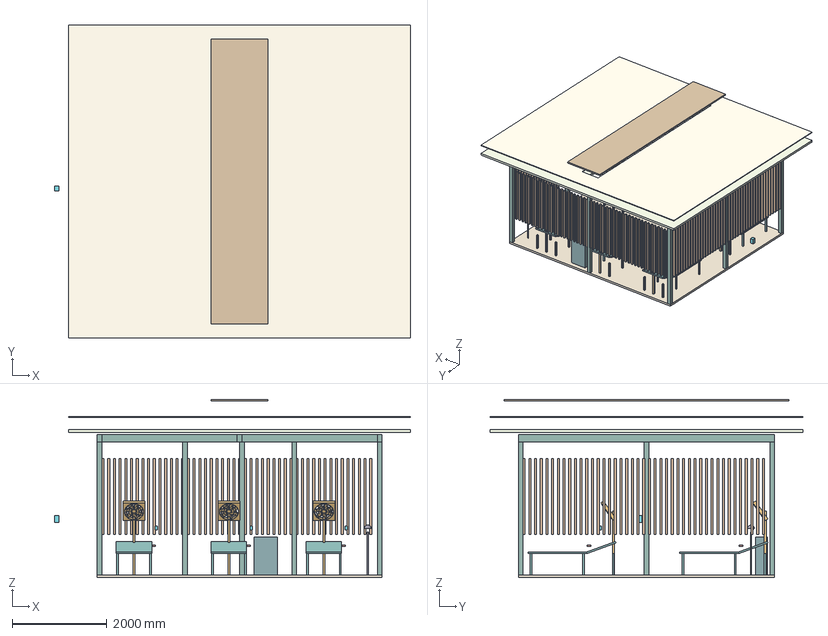
[picture p105: CAD file, 2026-10-13]
cad/pavilion/exports/SAAYA_FS02_concept.step
7500.0 x 6600.0 x 3760.0 mm
footprint
frame
lower_roof
reflective_roof
ridge_cap
west_screen
east_screen
rear_screen
cot_1
fan_1
air_sensor_1
control_1
cot_2
fan_2
air_sensor_2
control_2
cot_3
fan_3
air_sensor_3
control_3
cot_4
fan_4
air_sensor_4
control_4
cot_5
fan_5
air_sensor_5
control_5
service_cabinet
reference_station
wbgt_station
