alphasafal/saaya-verify/cad/fullsize/exports/MT02_fan_support_arm.step

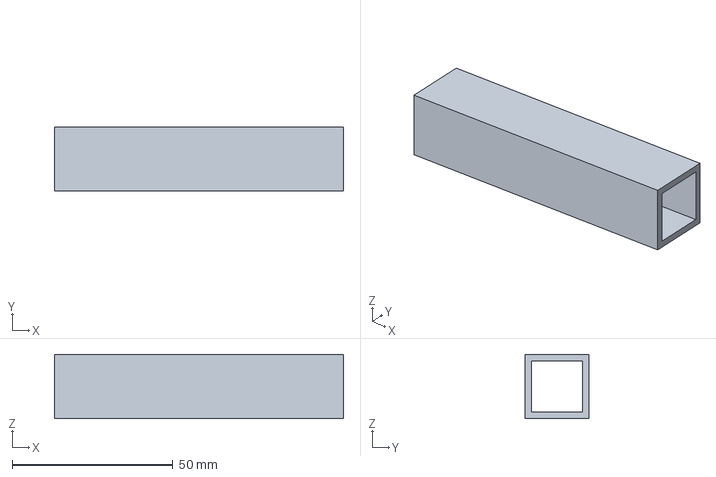
[picture p106: CAD file, 2026-10-12]
cad/fullsize/exports/MT02_fan_support_arm.step
90.0 x 20.0 x 20.0 mm
