alphasafal/saaya-verify/site/fullsize/E02_service_lid.step

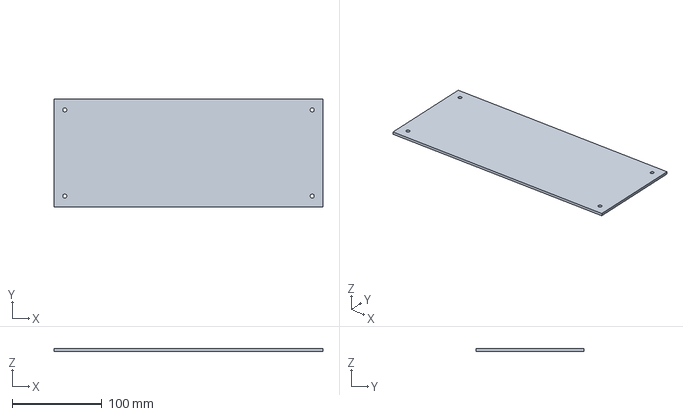
[picture p107: CAD file, 2026-10-12]
site/fullsize/E02_service_lid.step
300.0 x 120.0 x 3.00 mm
