alphasafal/saaya-verify/cad/node/exports/oled_glass.stl

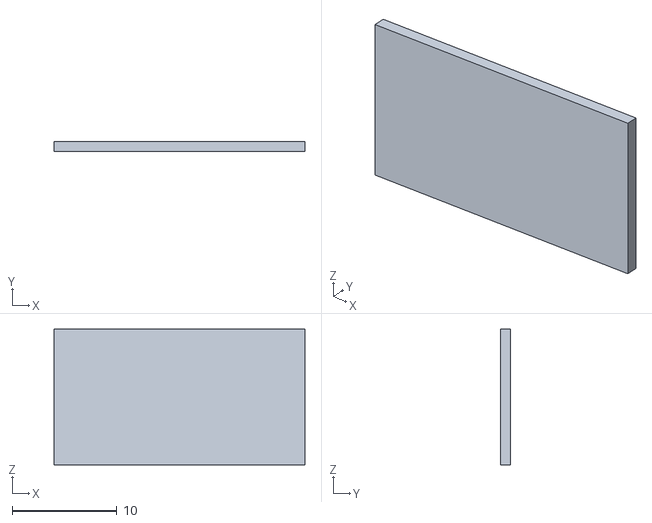
[picture p108: CAD file, 2026-10-20]
cad/node/exports/oled_glass.stl
24.0 x 1.00 x 13.0
