alphasafal/saaya-verify/site/node/oled_module.stl

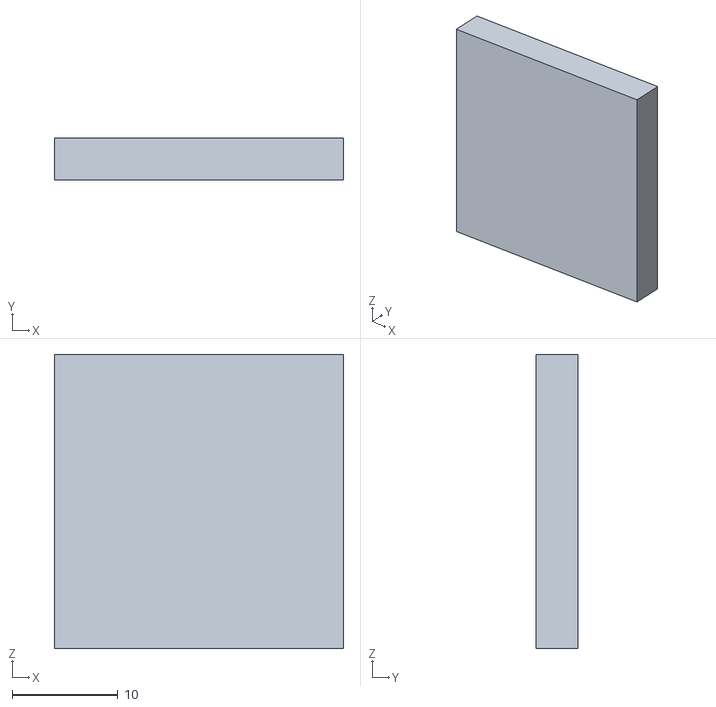
[picture p109: CAD file, 2026-10-20]
site/node/oled_module.stl
27.3 x 4.00 x 27.8
