alphasafal/saaya-verify/(list of files, cad)

Other CAD files:
cad/pavilion/exports/air_sensor_2.stl
cad/pavilion/exports/control_3.stl
site/pavilion/air_sensor_1.stl
site/pavilion/fan_4.stl
cad/pavilion/exports/cot_4.stl
site/pavilion/control_2.stl
cad/pavilion/exports/cot_5.stl
cad/pavilion/exports/control_2.stl
site/pavilion/air_sensor_2.stl
cad/pavilion/exports/control_1.stl
cad/pavilion/exports/fan_3.stl
site/node/ack_button.stl
cad/pavilion/exports/control_5.stl
site/pavilion/fan_5.stl
cad/node/exports/ack_button.stl
cad/pavilion/exports/air_sensor_5.stl
site/pavilion/cot_4.stl
cad/pavilion/exports/air_sensor_3.stl
site/pavilion/control_3.stl
cad/pavilion/exports/fan_1.stl
site/pavilion/fan_1.stl
archive/lab-v1/controller_box.scad
archive/lab-v1/saaya_shelter.scad
archive/lab-v1/saaya_assembly.obj
cad/fullsize/exports/B01_crossbeam.step
cad/fullsize/exports/B01_crossbeam.stl
cad/fullsize/exports/BP01_base_plate.dxf
cad/fullsize/exports/BP01_base_plate.stl
cad/fullsize/exports/C01_cable_trunk.stl
cad/fullsize/exports/CP01_roof_connection.dxf
cad/fullsize/exports/CP01_roof_connection.step
cad/fullsize/exports/CP01_roof_connection.stl
cad/fullsize/exports/CP02_spacer_cap.dxf
cad/fullsize/exports/CP02_spacer_cap.stl
cad/fullsize/exports/E01_dry_enclosure.stl
cad/fullsize/exports/E02_service_lid.dxf
cad/fullsize/exports/E02_service_lid.stl
cad/fullsize/exports/E03_component_carrier.dxf
cad/fullsize/exports/E03_component_carrier.stl
cad/fullsize/exports/E04_ESP32_reference.stl
cad/fullsize/exports/E05_monitor_reference.stl
cad/fullsize/exports/E06_display_reference.step
cad/fullsize/exports/E06_display_reference.stl
cad/fullsize/exports/E07_button_reference.step
cad/fullsize/exports/E07_button_reference.stl
cad/fullsize/exports/E08_LED_reference.step
cad/fullsize/exports/E08_LED_reference.stl
cad/fullsize/exports/E09_buzzer_reference.step
cad/fullsize/exports/E09_buzzer_reference.stl
cad/fullsize/exports/F01_fan_cartridge.stl
cad/fullsize/exports/F02_fan_guard.stl
cad/fullsize/exports/F03_reference_fan.step
cad/fullsize/exports/F03_reference_fan.stl
cad/fullsize/exports/G01_knee_gusset.stl
cad/fullsize/exports/HW01_M10_bolt_reference.step
cad/fullsize/exports/HW01_M10_bolt_reference.stl
cad/fullsize/exports/HW02_M16_anchor_reference.stl
cad/fullsize/exports/JA01_louvre.stl
cad/fullsize/exports/JA02_screen_rail.step
cad/fullsize/exports/JA02_screen_rail.stl
cad/fullsize/exports/MT01_rear_service_rail.stl
cad/fullsize/exports/MT02_fan_support_arm.stl
cad/fullsize/exports/MT03_enclosure_backrail.step
cad/fullsize/exports/MT03_enclosure_backrail.stl
cad/fullsize/exports/MT04_enclosure_return.stl
cad/fullsize/exports/MT05_seated_sensor_stem.stl
cad/fullsize/exports/MT06_reference_sensor_stem.step
cad/fullsize/exports/MT06_reference_sensor_stem.stl
cad/fullsize/exports/MT07_sensor_foot.dxf
cad/fullsize/exports/MT07_sensor_foot.stl
cad/fullsize/exports/P01_front_post.stl
cad/fullsize/exports/P02_rear_post.stl
cad/fullsize/exports/R01_roof_purlin.stl
cad/fullsize/exports/RF01_lower_skin.dxf
cad/fullsize/exports/RF01_lower_skin.step
cad/fullsize/exports/RF01_lower_skin.stl
cad/fullsize/exports/RF02_upper_skin.dxf
cad/fullsize/exports/RF02_upper_skin.stl
cad/fullsize/exports/S01_sensor_shield.step
cad/fullsize/exports/S01_sensor_shield.stl
cad/fullsize/exports/S02_roof_probe.step
cad/fullsize/exports/S02_roof_probe.stl
cad/fullsize/exports/S03_SHT31_reference.step
cad/fullsize/exports/S03_SHT31_reference.stl
cad/fullsize/exports/SP01_roof_spacer.stl
cad/fullsize/exports/ST01_bench_leg.step
cad/fullsize/exports/ST01_bench_leg.stl
cad/fullsize/exports/ST02_bench_rail.stl
cad/fullsize/exports/ST03_seat_slat.stl
cad/fullsize/exports/ST04_bench_crossrail.stl
cad/fullsize/exports/W01_optional_water_vessel.stl
cad/fullsize/exports/W02_float_reference.stl
cad/node/exports/buzzer.stl
cad/node/exports/radiation_shield.stl
cad/node/exports/sht31_in_shield.stl
cad/pavilion/exports/air_sensor_1.stl
cad/pavilion/exports/cot_1.stl
cad/pavilion/exports/cot_2.stl
cad/pavilion/exports/fan_4.stl
cad/pavilion/exports/fan_5.stl
cad/pavilion/exports/footprint.stl
cad/pavilion/exports/rear_screen.stl
cad/pavilion/exports/west_screen.stl
site/fullsize/B01_crossbeam.step
site/fullsize/B01_crossbeam.stl
site/fullsize/BP01_base_plate.dxf
site/fullsize/BP01_base_plate.stl
site/fullsize/C01_cable_trunk.stl
site/fullsize/CP01_roof_connection.dxf
site/fullsize/CP01_roof_connection.step
site/fullsize/CP01_roof_connection.stl
site/fullsize/CP02_spacer_cap.dxf
site/fullsize/CP02_spacer_cap.stl
site/fullsize/E01_dry_enclosure.stl
site/fullsize/E02_service_lid.dxf
site/fullsize/E02_service_lid.stl
site/fullsize/E03_component_carrier.dxf
site/fullsize/E03_component_carrier.stl
site/fullsize/E04_ESP32_reference.stl
site/fullsize/E05_monitor_reference.stl
site/fullsize/E06_display_reference.step
site/fullsize/E06_display_reference.stl
site/fullsize/E07_button_reference.step
site/fullsize/E07_button_reference.stl
site/fullsize/E08_LED_reference.step
site/fullsize/E08_LED_reference.stl
site/fullsize/E09_buzzer_reference.step
site/fullsize/E09_buzzer_reference.stl
site/fullsize/F01_fan_cartridge.stl
site/fullsize/F02_fan_guard.stl
site/fullsize/F03_reference_fan.step
site/fullsize/F03_reference_fan.stl
site/fullsize/G01_knee_gusset.stl
site/fullsize/HW01_M10_bolt_reference.step
site/fullsize/HW01_M10_bolt_reference.stl
site/fullsize/HW02_M16_anchor_reference.stl
site/fullsize/JA01_louvre.stl
site/fullsize/JA02_screen_rail.step
site/fullsize/JA02_screen_rail.stl
site/fullsize/MT01_rear_service_rail.stl
site/fullsize/MT02_fan_support_arm.stl
site/fullsize/MT03_enclosure_backrail.step
site/fullsize/MT03_enclosure_backrail.stl
site/fullsize/MT04_enclosure_return.stl
site/fullsize/MT05_seated_sensor_stem.stl
site/fullsize/MT06_reference_sensor_stem.step
site/fullsize/MT06_reference_sensor_stem.stl
site/fullsize/MT07_sensor_foot.dxf
site/fullsize/MT07_sensor_foot.stl
site/fullsize/P01_front_post.stl
site/fullsize/P02_rear_post.stl
site/fullsize/R01_roof_purlin.stl
site/fullsize/RF01_lower_skin.dxf
site/fullsize/RF01_lower_skin.step
site/fullsize/RF01_lower_skin.stl
site/fullsize/RF02_upper_skin.dxf
site/fullsize/RF02_upper_skin.stl
site/fullsize/S01_sensor_shield.step
site/fullsize/S01_sensor_shield.stl
site/fullsize/S02_roof_probe.step
site/fullsize/S02_roof_probe.stl
site/fullsize/S03_SHT31_reference.step
site/fullsize/S03_SHT31_reference.stl
site/fullsize/SP01_roof_spacer.stl
site/fullsize/ST01_bench_leg.step
site/fullsize/ST01_bench_leg.stl
site/fullsize/ST02_bench_rail.stl
site/fullsize/ST03_seat_slat.stl
site/fullsize/ST04_bench_crossrail.stl
site/fullsize/W01_optional_water_vessel.stl
site/fullsize/W02_float_reference.stl
site/node/buzzer.stl
site/node/radiation_shield.stl
site/node/sht31_in_shield.stl
site/pavilion/air_sensor_3.stl
site/pavilion/air_sensor_5.stl
site/pavilion/control_1.stl
site/pavilion/control_5.stl
site/pavilion/cot_1.stl
site/pavilion/cot_2.stl
site/pavilion/cot_5.stl
site/pavilion/fan_3.stl
site/pavilion/footprint.stl
site/pavilion/rear_screen.stl
site/pavilion/west_screen.stl
