alphasafal/saaya-verify/docs/report/SAAYA_Viva_and_Presentation_Guide.pdf

# SAAYA Cool Shelter — Viva and Presentation Guide

For Safal’s personal preparation. Not part of the submitted report.

## 1. Your one-minute pitch (learn this by heart)

“Outdoor workers in Vellore rest under hot metal sheets in 39 °C heat. Nobody knows if these shades help, fans fail without anyone noticing, and there is no reliable way to call for help. SAAYA is a demountable cool shelter: a reflective, ventilated double roof with a deep overhang and a jaali screen does most of the cooling passively. An ESP32-based system measures the seat and outdoor air, the roof and the fan, runs the fan only when it helps, stops it above 39 °C where research shows fans add heat, detects faults, and gives workers a help button that cannot be lost. It costs about ₹5,314 in electronics and every claim it makes must be backed by measurement.”

## 2. Presentation plan — follows the slide deck (≈ 14 min talk + 5 min demo)

Slide | Content | Time | What to say
1 | Title | 0:20 | Name and register number (23BCT0237). “SAAYA is a cool shelter for outdoor workers; passive design cools, the IoT system controls and proves.”
2 | The problem | 0:50 | 39 °C May, 67 °C modelled shed roof underside, ILO 5.8 % hours lost. Three gaps: hot roof, no feedback, no help signal.
3 | Our idea | 0:40 | Shelter + node + evidence rules. Point at the roofless render: bench, fan, sensors, box.
4 | Six layers | 0:50 | Shade → white top → ventilated gap → cool lining → overhang + jaali → smart fan. Only the last uses power.
5 | Heat model | 1:10 | Shade −15.9 °C, roof extra −2.6 °C, underside ≈ 26 °C cooler. Say “screening model, not validated”.
6 | Vs AC / cooler | 0:50 | AC wastes 1.4–1.6 kW in an open shelter; cooler adds humidity, weak in monsoon. SAAYA ≈ 3 W and the only one that knows if it works.
7 | Shelter decisions | 0:50 | Read two rows aloud (white skin, ventilated gap); the rest is on the slide.
8 | Fan rules | 0:50 | Auto on 32 / off 31, caution 37, stop 39, restart 38.5; manual never blocked; fault < 100 rpm after 3 s; HELP latch.
9 | Architecture | 0:40 | Sense → decide → act; logging optional; network failure changes nothing for the worker.
10 | Devices 1 | 1:00 | ESP32 vs Uno/Pi; SHT30 vs DHT22/BME280; tach fan vs 2-wire. Stress “why not”.
11 | Devices 2 | 0:40 | OLED, IP65 buttons, float switch fail-safe, buck not 7805, bought IP65 box not 3D print.
12 | Compatibility | 0:50 | 3.3 V logic, 4 I²C addresses, safe pins, 578 mA of 2 A, non-blocking loop, fits the plate.

SAAYA cool shelter - viva and presentation guide - page 1 of 9

Slide | Content | Time | What to say
13 | Interfacing | 0:50 | Trace one path with a pointer: 12 V → fuse → buck → ESP32; then fan PWM and tach.
14 | Shelter CAD | 0:40 | 2400 × 2000 posts, 2800 × 2400 roof, 2310 clear, 120 mm gap, ≈ 250 kg; engineer approval needed.
15 | Node CAD | 0:30 | 175 × 100 × 60 IP65; glands down; ACK on side; vent.
16 | Deployment | 0:30 | Front away from afternoon sun, box 1.4 m, seat 1.1 m, reference ≥ 2 m outside, mains or 20 W solar.
17 | Cost | 0:40 | Node ₹5,314; shelter ₹94k–₹1.71 lakh estimate; 3.2 W vs ≈ 1,500 W AC; how cost drops.
18 | Evidence rules | 0:50 | Declare, pair, repeat 3 days, claim only if the 95 % interval clears the margin.
19 | Hardware simulation | 0:40 | Whole node simulated; rules are the firmware’s own code compiled to WebAssembly (identical on 5,000 cases); 9 behaviours tested; Wokwi runs the real firmware; found 3 bugs before soldering.
20 | Live demo | 5:00 | Switch to the website (script in section 3).
21 | Honest status | 0:40 | Done and tested / not yet proven / next steps. End calmly.
22 | Thank you | — | Leave it up during questions.

Delivery tips. Stand beside the screen, not in front of it. Point at the diagram while you talk about pins. Say numbers slowly. When you switch to the demo, say what you are about to show before clicking. Finish on the “what is proven / not yet proven” slide: honesty at the end leaves a strong impression.

## 3. Live demo script — https://saaya-verify.vercel.app

Page | What to click and say
designs.html | Open the design gallery. “Everything I will show is live and open: CAD, firmware and data.”
fullsize-model.html | Click Whole shelter, then untick Roof to show the frame and devices; tick Section; click
Worker + airflow. Type ESP32 in the search box and press Focus selected component.
simulator.html | The whole node circuit running the firmware’s own rules (compiled to WebAssembly). Click
Afternoon 34 °C: fan starts at 50 %. Click Extreme 40 °C: automatic stops, OLED says HOT. Press MODE on the circuit: manual 70 % still works. Tick Fan blocked: FAN FEEDBACK FAULT after 3 s. Press HELP, then Power cut: the latch comes back after reboot; ACK clears it. Point at the serial monitor: the same JSON the real node sends.
node.html | Click Lid off, then Front panel, then Cable entries. Point out glands facing down and
ACK on the side.
explain.html | Click a sensor on the IoT diagram; it opens that part in 3D. Scroll to 3 · Wiring & working.
index.html#lab | Choose Normal operation, endpoint Roof surface temperature, Start replay, then
Complete replay: the record shows a single-run estimate and says replication is needed. Press Reset, choose Fan feedback failure with endpoint Seated air speed, run again: the claim is withheld with the reason. This is the key moment of the demo.
defense.html | Scroll to the MRT chart and the decision table. End the demo here.

SAAYA cool shelter - viva and presentation guide - page 2 of 9

Backup. If Vercel does not load, use the mirror https://alphasafal.github.io/saaya-verify/ with the same page names. If there is no internet, open the report PDF and the slide deck offline.

## 4. Numbers to remember

Item | Value
Shelter post grid / roof | 2400 × 2000 mm / 2800 × 2400 mm (200 mm overhang)
Clear height / roof fall / roof gap | 2310 mm / 120 mm over 2000 (3.4°) / ≈ 120 mm
Bench | 1400 × 450 mm, seat 450 mm high, 4–6 people
Steel sections | Posts SHS 60×60×3, beams RHS 80×60×3, purlins RHS 60×40×3
Model: shade alone / cool roof extra | −15.9 °C / −2.6 °C MRT at seated head

Model: roof underside vs weathered

sheet | ≈ 26 °C cooler
Fan rules | Auto on ≥ 32 °C, off < 31 °C; auto stops ≥ 39 °C, restarts < 38.5 °C; manual
| 70 %, auto 50 %
Fan fault | Commanded but < 100 rpm after 3 s
I²C addresses | SHT30 seat 0x44, SHT30 reference 0x45, OLED 0x3C, INA219 0x40; bus
| 50 kHz
Pins | SDA 21, SCL 22, PWM 25, tach 34, float 35, roof 4, MODE 32, HELP 33,
| ACK 27, LED 26, buzzer 14
Power | ≈ 3.2 W typical, 6.9 W peak, ≈ 34 Wh/day; 12 V 2 A adapter, 1 A fuse
Enclosure | 175 × 100 × 60 IP65 ABS (ProtechT WPE16), 5 × PG7 glands down, M12
| vent
Cost | Electronics ₹5,314 (₹3,965 listed); shelter ₹94,134–₹170,771 estimate
Tests | 89 Python tests, C++ controller tests, 4 firmware builds in CI, 9 simulator
behaviour tests, WebAssembly = native C++ on 5,000 cases, 143-instance
| and 23-solid clash checks

## 5. Why every shelter decision — and why not the alternatives

Decision | Why | Why not the alternatives
Steel SHS/RHS frame | Standard sections, bolted plates → demountable, repairable, locally fabricated. | Bamboo: variable strength, termites. Timber: rot, fire. Aluminium: cost, local welding.
White upper skin | Reflects most sunlight; cheap; repaintable. | Bare GI: hot underside (model ≈ 80 °C). Cement sheet: heavy, brittle. Polycarbonate: transmits heat.
Ventilated gap ≈ 120 mm | Carries away heat absorbed by the top skin; lining stays near air temp even when the top gets dirty. | Sealed gap: hotter lining. Sandwich panel: cost, releases heat into the evening.

SAAYA cool shelter - viva and presentation guide - page 3 of 9

Decision | Why | Why not the alternatives
Painted aluminium lining | Cool surface above heads; paint resists corrosion; model shows finish matters little once cool. | No lining: hot top skin faces people. False ceiling: moisture.
200 mm overhang | Wider shadow at the bench without bigger
post grid.

Bigger overhang: more wind uplift and cost (upgrade option; +0.3 m ≈ −1.4 °C).

Removable jaali
louvres
Cut low-angle sun, keep airflow. | Solid wall: blocks breeze. Fabric: UV wear.

Slatted bench 450
high

Comfortable, drains, stays cooler than metal. Steel bench: too hot. Concrete: fixed.

Base plates +
anchors
Can be lifted and moved with the site. | Embedded posts: permanent.

No AC / no
evaporative cooler

Open shelter cannot hold cool air; coolers
need water, add humidity, weak in monsoon.

For enclosed cooling, NDMA treats a cooling room as a separate facility.

## 6. Why every device — alternatives and compatibility

Device | Why chosen | Why not others | Compatibility
ESP32- DevKitC | ₹499; 2×I²C, 16 PWM, interrupt tach input, Wi-Fi, flash, watchdog, −40…85 °C. | Arduino Uno: no Wi-Fi, 2 kB RAM. Raspberry Pi: SD corruption on power cuts, ~10× power. ESP8266: one ADC, fewer pins. | 3.3 V logic matches all sensors; 5 V input from buck.
SHT30 ×2 | ±0.2 °C, ±2 %RH typ, same as SHT31 in 0–65 °C, ₹179 each; addresses 0x44/0x45 share one bus. | DHT22: slower, timing-critical, RH drift. BME280: self-heating, pressure not needed. SHT31: ₹399 for no gain in our range. | 2.15–5.5 V → 3.3 V OK; I²C.

DS18B20
probe

₹49, ±0.5 °C, waterproof, long cable, 1 GPIO.

IR sensor: needs emissivity, wrong on metal. NTC: calibration, lead resistance.

3.0–5.5 V; 1-Wire + 4.7
kΩ.
INA219 | ₹89, high-side V and I on I²C, 0.5 % class → measured energy.
ACS712: only ≈ 60 mV signal at 0.33 A, noisy. Datasheet watts: not a measurement.

Logic 3.3 V; bus ≤ 26 V
(12 V used).
Arctic P12 Pro fan | 4-wire: tach proves rotation; 25 kHz PWM; 0 rpm < 5 %; fails ON if PWM floats; 0.33 A.

2-wire fan: no feedback. 230 V pedestal fan: shock risk, no feedback, 55–125 W.

12 V supply; PWM pulled
low by 2N3904; tach
open-collector → 10 kΩ
to 3.3 V.
SSD1306 OLED | ₹130, readable without a phone, shares I²C.
LCD 16×2: needs 5 V and more pins. Phone app only: workers may not carry phones.

3.3–5 V; 0x3C.

3 × 12 mm
IP65 buttons

Weatherproof; HELP front, ACK side (staff only).

Touch sensors: false triggers with sweat/rain. Membrane: UV
ageing.

To GND, internal pull-ups.

SFM-27
buzzer +
LED

>95 dB at <12 mA; visible + audible.

Passive piezo: quieter, needs tone code.

12 V via 2N3904; LED
330 Ω at 3.3 V ≈ 8 mA.

SAAYA cool shelter - viva and presentation guide - page 4 of 9

Device | Why chosen | Why not others | Compatibility
PP float switch | Dry contact; broken wire reads “low” (fail-safe). | Ultrasonic: cost, condensation. Capacitive: fouling. | IO35 input-only + 10 kΩ pull-up.
12 V 2 A + MP1584 + 1 A fuse | 12 V feeds fan; buck is efficient; >3× margin. | 7805 linear: >50 % lost as heat in a sealed box. | Never USB and 5 V pin together.
IP65 ABS box | Purchasable, rain-rated, glands down + vent. | 3D-printed PETG: softens near 60–70 °C, not rain-rated. | 175 × 100 × 60 fits 90 × 70 board + modules.

## 7. How to prove the parts are compatible

Check | Explanation
Logic levels | All sensors and the OLED run at 3.3 V on the ESP32’s own 3.3 V rail, so no level shifters are
needed. The fan’s PWM and tach lines never see 12 V: PWM is pulled down by a transistor and tach is an open collector pulled up to 3.3 V.
I²C address map | Four devices, four different addresses: 0x44, 0x45, 0x3C, 0x40. No clash. Bus at 50 kHz for the
| longer reference cable.
Pins | Input-only pins (IO34, IO35) used only as inputs with external pull-ups. Strapping pins (0, 2, 12,
15) and flash pins (6–11) avoided. Every peripheral has its own GPIO.
Current | 3.3 V rail ≈ 25 mA typical vs ≈ 500 mA LDO budget. 12 V adapter ≈ 578 mA peak vs 2000 mA
| rating.
Timing | DS18B20 750 ms conversion runs in the background; Wi-Fi runs on the other core with a
queue; the control loop is never blocked; 5 s watchdog.
Mechanical | Every module fits the 160 × 86 mounting plate; clash check passes; glands spaced 30 mm for
spanner access; box fits on a 60 mm SHS post with hose clamps.

## 8. Explaining the firmware in 30 seconds

“The ESP32 runs a loop. Every cycle it reads the buttons and applies the control rules; once a second it reads the sensors, updates the display and sends one record. The rules live in one header file that we test on a computer: HELP latches and only ACK clears it; manual fan is 70 %; auto fan is 50 % between 32 °C and 39 °C with hysteresis; if the fan is commanded but the tachometer shows under 100 rpm after 3 seconds it is a fault; a missing sensor is shown as unavailable, never as zero. A watchdog restarts the board in 5 seconds if anything hangs.”

## 9. Questions examiners are likely to ask

Q. What is new in your project? Shade shelters already exist.
Shade and cool roofs are not new and I do not claim them. What is new is the combination: a demountable cool shelter whose own sensors tell you whether it works, a fan controller that stops at 39 °C because research shows fans can add heat there, and a help request that cannot be lost.

SAAYA cool shelter - viva and presentation guide - page 5 of 9

Q. Why not just put an air conditioner?
An open shelter cannot hold cooled air, so most of the AC’s 1.4–1.6 kW would be wasted, and it needs mains power and servicing. If a site needs truly cooled air, NDMA treats an enclosed cooling room as a separate facility.
Q. Why not an evaporative cooler or mist fan?
They need water and cleaning, add humidity, and lose their effect in Vellore’s humid monsoon months. Hygiene of standing water is also a concern.
Q. Your model says the double roof adds only 2.6 °C. Why build it?
Because the seated MRT is dominated by shade, but the double roof keeps the underside ≈ 26 °C cooler, which matters for anyone standing close to it, keeps working as the white coat gets dirty, and the upper skin is removable so we can test both on site.
Q. Is your model validated?
No, it is a screening model. It uses standard relations, its energy balance closes, and it has 17 tests. It makes predictions with tolerance bands for the roof underside and a globe thermometer, which we will check on three clear days.
Q. Why 39 °C as the fan cut-off?
Morris et al. 2021 propose 39 °C for young healthy adults, 38 °C for over-65s, 37 °C for older people on certain medicines; WHO says below 40 °C. We stop auto at 39 °C, warn from 37 °C, and leave manual to the worker.
Q. Why ESP32 and not Raspberry Pi?
The controller must survive power cuts and network loss. ESP32 boots instantly, has a hardware watchdog, PWM, flash for the help latch and costs ₹499. A Pi boots Linux from an SD card that can corrupt on power loss and uses far more power.
Q. Why two temperature sensors?
One at the seat, one outside as a reference at the same height. Weather changes affect both, so the difference shows what the shelter does. With one sensor you cannot separate the shelter from the weather.
Q. Why SHT30 and not DHT22?
SHT30 is digital I²C, faster and more accurate (±0.2 °C, ±2 %RH), and two can share one bus. DHT22 uses a timing-critical one-wire protocol and drifts in humidity.
Q. The website says SHT31 but the report says SHT30. Which?
SHT30 is the final choice: same typical accuracy in our range, same footprint and same addresses, at less than half the price. SHT31 is a drop-in upgrade if a wider accurate range is needed.
Q. Why does the fan need a tachometer?
Without it, a stalled or unplugged fan looks exactly like a running one. The tach lets the system say “fan fault” instead of claiming cooling.
Q. What happens if the ESP32 crashes?
The watchdog restarts it within 5 s and the help latch is restored from flash. Meanwhile the fan’s PWM line floats and, by the four-wire fan standard, the fan runs at full speed: it fails on, not off.
Q. What if Wi-Fi is down?
Nothing changes for the worker. All control is on the ESP32; Wi-Fi is only for logging and runs on a separate core.

SAAYA cool shelter - viva and presentation guide - page 6 of 9

Q. How does HELP work and why is ACK on the side?
HELP latches LED, buzzer and display and is saved in flash. Only ACK clears it. ACK is on the side so it is pressed deliberately by staff, not by accident.
Q. How did you choose the 1 °C margin?
Two ±0.5 °C sensors could disagree by up to about 1 °C before we correct their offset, so smaller differences cannot be trusted.
Q. How do you compare results across days?
One run is never a result. We need at least three valid runs on three different days, then a 95 % confidence interval; a direction is claimed only if the whole interval clears the margin.
Q. How much does it cost?
Electronics ≈ ₹5,314. The first shelter is estimated at ₹94,134–₹170,771 including foundations, fabrication, transport and contingency. It is an estimate, not a quote. The retrofit option costs only the electronics.
Q. How will you reduce the shelter cost?
Repeated production, bolted standard sections, using an existing slab, optional upper skin, ground cover instead of bigger roof, and retrofitting existing sheds where possible.
Q. Is the structure safe?
The sections are candidates. Foundations, connections and wind loads must be designed and approved by a structural engineer before anyone sits under it. I state this in the report.
Q. How is it powered off-grid?
Daily need ≈ 34 Wh; a 20 W panel with a 12 V 7 Ah battery would cover it. Not costed yet.
Q. Where exactly do sensors go and why?
Seat sensor at 1.1 m (seated head height) in a radiation shield; reference ≥ 2 m outside at the same height; roof probe on the lining centre; box at 1.4 m on a rear post.
Q. Why a radiation shield?
Sun or a hot roof shining on a sensor makes it read high. The plates block radiation while letting air through.
Q. Why glands at the bottom?
Rain runs off rather than into the box; drip loops make water drop before reaching the gland. The vent stops condensation being sucked in at night.
Q. What did you actually test?
Firmware compiles in CI (including Wi-Fi build); control logic has native C++ tests; 89 Python tests; both CAD models clash-checked; website browser-tested. Not yet: assembly and field measurement.
Q. What is the role of AI in this project?
None in control. There is an optional local explainer for finished data records that cannot change data or control anything.
Q. Why Vellore?
Hot pre-monsoon (May mean max ≈ 39 °C) and humid monsoon: a demanding test for both fan rules and weatherproofing, and it is where VIT is.

SAAYA cool shelter - viva and presentation guide - page 7 of 9

Q. Can it scale to a big site?
Yes, by placing one shelter per 4–6 resting workers near the work fronts, each with its node; data can go to one supervisor laptop over Wi-Fi.
Q. Is the simulator real or just an animation?
The decisions are real: the firmware’s own control header is compiled to WebAssembly and called directly, and a test shows identical results to the normal C++ build on 5,000 random cases. The loop around it copies main.cpp: debounce, 1 s sampling, tach maths, inverted PWM, flash latch. What is modelled is the sensor readings (sliders) and the fan’s speed and current, and the page says so.
Q. Why not just simulate everything in Wokwi?
I did build a Wokwi project that runs the real firmware binary. But Wokwi has no SHT30, INA219 or 4-wire fan, so I had to write those as custom chips in C, and it needs an account. The website simulator works anywhere without login, which is safer for a live demo.
Q. How did you test your custom Wokwi chips?
I compiled them with Wokwi’s exact compiler flags and ran them in a small stand-in for the Wokwi host, sending the same I²C bytes the Adafruit libraries send: SHT30 reset, status and measurement with CRC checks, and INA219 calibration and power reads; and driving the fan with the firmware’s 25 kHz PWM to check rpm, tach pulses and stall detection.
Q. Did the simulation find anything?
Yes, three real bugs: the seat and reference SHT30 addresses were swapped in the code compared with the design, the only firmware build had automatic mode switched off, and the first OLED line was 22 characters on a 21-character display. All fixed and re-tested.
Q. What would you do with more time?
Structural approval, build one shelter and two nodes, co-locate sensors, 3-day paired tests, compare single vs double roof, add GSM/LoRa for help alerts, design a PCB.

## 10. Hard questions and how to handle them

Q. “So you haven’t built anything?”
Say calmly: “Not yet. This stage is a complete, tested design: CAD, circuit, firmware that compiles, and a test plan. I deliberately do not claim any cooling result until we measure it.” Then show the demo where the system refuses to claim.
Q. “This is just a fan under a roof.”
“The roof and fan are standard. The contribution is how they are combined and checked: the roof chosen by a heat model, a fan that stops when it would add heat, fault detection, and evidence rules.”
Q. “Your numbers are from a model.”
“Yes, and I label them as screening estimates with tolerance bands. The roof underside prediction is the cheapest thing to verify, with a ₹49 probe.”
Q. “Why not a cheaper fan?”
“Cheap Indian 40/120 mm fans are 2-wire with no tachometer. Without feedback the system cannot detect a stalled fan, which is one of the problems we set out to solve.”

SAAYA cool shelter - viva and presentation guide - page 8 of 9

## 11. Things not to say

Do not say the shelter “cools the air” or is “as good as AC”. Say it reduces radiant heat and moves air. Do not say it is “tested” or “proven”. Say firmware and logic are tested in software; field testing is next. Do not say “safe for workers” or mention medical benefits.
Do not claim it is the first in the world or patentable.
If you do not know an answer, say: “I have not checked that; I would find out by …”. Examiners respect that more than guessing.

## 12. Day-before checklist

Print two copies of the report.
Open every demo page once on the presentation laptop the day before (Vercel can be slow the first time).
Keep the GitHub Pages mirror open in a second tab in case Vercel is blocked on the college network. Download the report PDF and slide deck to the laptop for offline use; take screenshots of each demo page as a last resort.
Rehearse the 14-minute talk twice with a timer; the demo should be 5 minutes.
Carry the numbers page printed or memorised.

SAAYA cool shelter - viva and presentation guide - page 9 of 9
