alphasafal/saaya-verify/(commit log)

2026-10-11 docs: preserve original lab concept and approved build scope
    [controller_box.scad, saaya_assembly.obj, saaya_shelter.scad]
2026-10-11 feat: add public research lab, fabrication candidates and ESP32 bench firmware
    [base_quarter_print_4.stl, enclosure_base.stl, enclosure_lid.stl, fan_angle_bracket.stl, fan_guard_40mm.stl, fan_guard_spacer.stl, jaali_coupon_pitch_12.stl, jaali_coupon_pitch_8.stl]
2026-10-11 fix: resolve evidence freshness and fabrication review findings
    [fan_angle_bracket.stl]
2026-10-11 build: verify ESP32 firmware in CI and publish current IoT diagram
2026-10-11 fix: use C++11-compatible firmware initialization
    [main.cpp]
2026-10-12 feat: publish full-size shelter CAD review package and Vercel demo
    [B01_crossbeam.step, B01_crossbeam.stl, BP01_base_plate.dxf, BP01_base_plate.step, BP01_base_plate.stl, C01_cable_trunk.step, C01_cable_trunk.stl, CP01_roof_connection.dxf]
2026-10-12 feat: add panel teaching walkthrough and annotated IoT CAD
2026-10-13 feat: show worker cooling path, adjustable fan concept and AI evidence role
2026-10-13 fix: use CAD RGB colours and show reclining reference occupants
2026-10-13 feat: publish validated FS-02 concept solids and readable cutaway
    [SAAYA_FS02_concept.step, air_sensor_1.stl, air_sensor_2.stl, air_sensor_3.stl, air_sensor_4.stl, air_sensor_5.stl, control_1.stl, control_2.stl]
2026-10-20 Add fan-benefit screen, sourced design defense, budget BOM and CI check
    - Firmware/Python/JS: auto fan stops >=39 C (restart <38.5 C) where fans may add heat; manual never blocked; OLED and telemetry advice
    - Design defense page + docs/DEFENSE.md: problem, comparison with conventional cooling, model findings, ADRs, evidence engine, costs, fixes, panel Q&A
    - research/costs.json budget profile (~INR 4,661 bench) with sources
    - Browser test for defense page in CI
    Claude-Session: https://claude.ai/code/session_01NMquVqSFFRs6ktiM1DZ2QE
    [controller.h, main.cpp]
2026-10-20 Apply adversarial review: correct radiant model and evidence claims
    - Model: convection-only Watmuff coefficient, black-globe absorptance for globe prediction,
    roof lining views shaded+sunlit ground by view factor, noon sun from date (north of zenith in May),
    less-favourable seat reported, declared prediction bands, lining-emissivity sensitivity
    - Headline no longer double-counts shade and roof (15.9 K + 2.6 K = 18.5 K)
    - Single runs report point estimates only; 'difference' claims need >=3 runs on >=3 distinct days
    - paired_statistics: undefined autocorrelation for constant series, n_eff clamped to [1, n]
    - Defense page/doc updated; design now favours a painted lining and optional secon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
    [build_site.py]
2026-10-20 Add SAAYA Node v1 retrofit IoT product (WIP): CAD, diagrams, viewer, Wi-Fi option
    - cad/node/build.py: IP65 enclosure fit model, internals, bracket, shield, fan; STEP/STL; interference check
    - scripts/node_diagrams.py: labelled interfacing diagram, dimensioned enclosure drawing, installation elevation
    - firmware: I2C at 50 kHz; optional Wi-Fi LAN uplink task (env esp32dev_wifi, off by default)
    - site/node.html 3D viewer; gallery entry
    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
    [SAAYA_NODE_v1.step, ack_button.stl, back_bracket.stl, buck.stl, buzzer.stl, enclosure_body.stl, enclosure_lid.stl, esp32_devkitc.stl]
2026-10-20 SAAYA Node v1: final IoT design PDF, purchasable parts, Wokwi project, node page test
    - Design uses verified-price parts: WPE16 IP65 box 175x100x60, SHT30 x2, Arctic P12 Pro, 12 mm IP65 buttons, SFM-27 buzzer
    - docs/node/SAAYA_Node_IoT_Design.pdf (+ HTML source, generator scripts)
    - firmware/diagram.json + wokwi.toml for the Wokwi ESP32 simulator
    - tests/node-browser.cjs in CI
    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
    [SAAYA_NODE_v1.step, ack_button.stl, back_bracket.stl, buck.stl, enclosure_body.stl, enclosure_lid.stl, esp32_devkitc.stl, esp32_shield_can.stl]
2026-10-20 Cool shelter project report (VIT format), viva guide builder, report on site
    - scripts/build_report.py + report_body.py + print_report.cjs: A4 VIT-format
    report centred on the cool shelter, with component selection, compatibility,
    interfacing, 3D models, deployment, cost and verification
    - scripts/build_viva.py: separate viva and presentation guide (not part of the report)
    - installation elevation now shows the node in the SAAYA cool shelter
    - designs page links the report PDF
    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
2026-10-20 Hardware simulation of the SAAYA Node: live simulator page and full Wokwi project
    - site/simulator.html: every part of the node wired as built (ESP32, 2x SHT30, DS18B20,
    INA219, OLED, 4-wire fan + 2N3904, buttons, LED, buzzer, float, 12 V/5 V path). Control
    rules are firmware/include/controller.h compiled to WebAssembly; the loop mirrors main.cpp.
    Scenarios, fault injection, power cut, OLED, serial JSON, event log, trace.
    - tests: wasm vs native C++ on 5000 random cases, wasm freshness, simulator end-to-end.
    - firmware/wokwi-full: complete Wokwi project running the real firmware with custom chips
    for SHT30 (CRC-checked protocol) and the fan branch (2N3904 inversion, tach, INA219);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
    [build_viva.py, build_wokwi_full.py, controller.h, main.cpp]
2026-10-20 Firmware: fix comment that swallowed the end of the OLED line; regenerate Wokwi sketch
    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
    [main.cpp, sketch.ino]
